JimboMcRackem/ESP32MCCAN/hardware/datasheets/NEEDED.md

# Datasheets still needed

Manufacturer sites block automated fetching from this project — downloading the PDF yourself and
dropping it in this directory is what has worked every time. PDFs, PNGs and text extractions here
are **gitignored**; only this file and `README.md` are tracked.

**Last reconciled against the folder contents: 2026-09-19**, after the owner supplied six files.
Full read-out of what each one settled is in `../docs/part-selection.md`, "Parts selected 2026-09-18".

---

## 2026-11-13 — aux stage

- ~~`sn74ahct2g126.pdf`~~ **Supplied 2026-11-13 as `74AHC_AHCT2G126.pdf`** (Nexperia Rev. 9). The pinout
  is verified, and U15 is now **74AHCT2G126DC, VSSOP-8 (SOT765-1)**. That is the only AHCT package;
  the TSSOP-8 "DP" is AHC.
- **`mmbt3904.pdf`** (Diotec, 2025-11-18): supplied. B on pin 1, E on pin 2, C on pin 3, which
  matches `Q_NPN_BEC` on Q2, Q3 and Q12.
- The pod switch is **chosen**: Infineon BTS7008-2EPA, already held here
  (`infineon_bts7008_2epa_datasheet_en.pdf`). The inrush measurement confirms it; it no longer
  gates it.

---

## 2026-10-18 — board phase A

**`tps4h160-q1.pdf` supplied by the owner** (TI SLVSCV8E, rev. June 2025) and graded in
`../docs/part-selection.md`, "Signal-output quad switch, 2026-10-18": **selected**. The ST
VNQ9080AJ alternate is **not needed**. Still needed, kit-gated: the `AUX_L`/`AUX_R` dual switch's
datasheet, once the pod's inrush is measured (spec §9.1).

---

## Blocking — nothing

**Closed 2026-09-19, both items, within hours of being opened.** The owner supplied the two
documents that settled them:

| Item | Settled by | Outcome |
|---|---|---|
| **Pass FET for route C** | `infineon_ipt008n06nm5lf_datasheet_en.pdf` | **Infineon IPT008N06NM5LF SELECTED** — OptiMOS 5 **LinearFET**, 60 V, **0.8 mΩ max**, SOA Diagram 3 gives **~50 A at 12 V / 10 ms** against a 7 A need. Route C now lands the board at **~60 °C**, 3 K *better* than today, with protection it does not currently have |
| **eFuse / controller** | `LTC4380.pdf` | **LTC4380 route chosen**, indicated orderable `LTC4380HMS-2#TRPBF`. Stock `Package_SO:MSOP-10_3x3mm_P0.5mm` verified correct — **no footprint download needed** |

> **Two judgement calls recorded against the FET, neither blocking** (detail in
> `../docs/part-selection.md`): it is **JEDEC Industrial-qualified, not AEC-Q101** — every other
> active part in this feed path is automotive-grade, so this is the owner's call and worth one
> check for an automotive OptiMOS LinearFET before ordering; and **PG-HSOF-8 (TOLL) is large**,
> ~9.9 × 10.5 mm each, ~180 mm² net added over the Q1 it replaces.

> **What is still needed is a decision, not a document:** whether the Experia's DC-DC fed 12 V rail
> can produce a load dump at all. If it cannot, the LTC4380's overvoltage clamp never operates and
> the SOA question is moot. **Confirm on the vehicle** (spec §6, and the Task 11 bring-up list).

---

## Previously blocking — now closed

**Every electrical part on the earlier blocking list is chosen.** L2, the last one, is the **Würth
WE-CMBNC 7448031002** (`wurth_we-cmbnc_7448031002.pdf`) — nanocrystalline, 2 mH, 10 A,
**6.3 mΩ max per winding**, **AEC-Q200 Grade 1**. With L1 = IHLP-4040DZ-01 at 1.5 µH the pair is
**18.40 mΩ against F4's 22 mΩ ceiling — a 16.4% margin**, 0.90 W, night total ~2.70 W.

> **Any substitution anywhere in the feed path must still be re-checked against the 22 mΩ sum.**
> The margin is comfortable now, not infinite: the two ferrite alternatives considered
> (Bourns PM3700-10-RC, Coilcraft CG3885-AL) are both 8.0 mΩ per winding and would take the pair
> back to 21.80 mΩ — a 0.9% margin.

> **Two items to confirm before ordering** (flagged, not assumed): whether the 6.3 mΩ is **per
> winding** — the conservative reading used above; Würth does not state it, Bourns and Coilcraft
> both do — or the total; and the **derating curve** at the 65 °C internal ambient, since the 10 A
> is specified at 20 °C.

## Blocking Task 9 — nothing; the antenna document is obtained

**CLOSED 2026-09-19.** The owner supplied the URL for *ESP32 Hardware Design Guidelines → PCB
Layout Design*. Both halves of the keep-out question are now answered:

| | |
|---|---|
| **Antenna area** (module datasheet, Fig. 12) | **18.0 mm wide × 6.19 mm deep** from the module end face |
| **Preferred placement** | *"place the module's on-board PCB antenna outside the base board, and the feed point … close to the edge"* — board-edge overhang, which spec §9.1 already assumes |
| **Explicitly forbidden** | *"the module should not be placed in the center of the board with clearance created by hollowing out on all four sides"* |
| **Housing clearance** | **"A clearance of at least 15 mm is recommended in all directions"** |

> **The 15 mm figure is an ENCLOSURE constraint and is the significant one** — a keep-clear volume
> ~48 mm across that must contain no PCB, metal, cable, gland or heat-spreader plate. It is
> recorded in `../docs/enclosure.md` §5a, where it now has to be reconciled with the gland field,
> the plate wall and the no-penetrations-in-the-antenna-wall rule **simultaneously**. *"Opposite
> wall"* used to settle the plate/antenna relationship; it now carries a minimum distance.

## Medium / low — for the BOM, not blocking

| Part | Why |
|---|---|
| **BAT54** (D8–D21, fourteen) | V_F at the clamp point and, more importantly, **reverse leakage at 3.3 V over temperature** — twelve sit across the RGB sense nodes where leakage biases the reading |
| **D1** 12 V Zener, **D3** 40 V Schottky, **C3** 220 µF, **F1** blade fuse holder | No part numbers; needed for the BOM and footprints. **C3 must be 63 V, not 50 V** — `smbj.pdf` gives the SMBJ24A an **8/20 µs clamp of 50.6 V**, which leaves a 50 V part no margin (see part-selection.md, "Correction 2") |
| **MMBT3904** (Q2, Q3) | Generic jellybean; any vendor's datasheet will do |
| **Automotive-grade IHLP** for L1 | `ihlp-4040dz-01.pdf` is the **Commercial** series — no AEC-Q200. Electrically it is the right part; for a vehicle, order the automotive variant of the same package |

---

## Recently closed — do not re-source these

| Ref | Part chosen | Closed by |
|---|---|---|
| **L1** input inductor | **Vishay IHLP-4040DZ-01**, **1.5 µH — required, not merely preferred** (5.80 mΩ max, Isat 27.5 A) | `ihlp-4040dz-01.pdf` |
| **L2** input CM choke | **Würth WE-CMBNC 7448031002** — nanocrystalline, 2 mH, 10 A, **6.3 mΩ max/winding**, **AEC-Q200 Grade 1**, through-hole. *Chosen 2026-09-19 over the Bourns PM3700-10-RC and Coilcraft CG3885-AL, both 8.0 mΩ ferrite and neither AEC-qualified* | `wurth_we-cmbnc_7448031002.pdf` |
| **L4 / L5** buck inductors | **Coilcraft XAL7070-223ME**, 22 µH, 39.69 mΩ max, Isat 6.3 A | `xal7070.pdf` |
| **L6** CAN choke | **TDK ACT45B-510-2P-TL003**, 51 µH, AEC-Q200 | `cmf_automotive_signal_act45b_en.pdf` |
| **D6 / D7** CAN ESD | **Nexperia PESD2CANFD24U-T** — one SOT23 part replaces both | `PESD2CANFD24U-T.pdf` |
| **D4** boost rectifier | **Vishay SS5PH102**, 100 V / 5 A | `ss5ph102.pdf` |
| **D2** input TVS | **SMBJ24A** — row 6.2 closed | `smbj.pdf` |
| **U7** PCA9685 | **PCA9685PW/Q900** (the AEC-Q100 variant), TSSOP28 | `PCA9685.pdf` |
| **U5** ESP32 module | **ESP32-WROOM-32E-N8** confirmed, EN reset RC verified, pin table cross-checked | `esp32-wroom-32e_esp32-wroom-32ue_datasheet_en.pdf` |

## 3D models worth sourcing (Task 8/9, enclosure fit)

KiCad ships footprints and STEP models for nearly everything now selected — including
`RF_Module:ESP32-WROOM-32E`, `Inductor_SMD:L_Vishay_IHLP-4040`, `Package_TO_SOT_SMD:SOT-23`,
`Package_SO:TSSOP-28_4.4x9.7mm_P0.65mm` and `Package_SO:Infineon_PG-TSDSO-14-22`. These are the ones
it cannot have:

- **ESP32-WROOM-32E module** — tall, and its antenna end dictates a keep-out plus board-edge
  placement. Espressif publish a STEP model
- **TE Superseal 1.0** 4-way (J3–J6) and 2-way (J8); **TE Superseal 1.5** 3-way (J1, J7) — panel
  penetration positions and mating clearance (§9.1). TE publish STEP per part number
- **Panel-mount ATO/ATC fuse holder** (F1) — one of the nine penetrations
- **Würth WE-CMBNC 7448031002 (L2)** — **DONE.** The vendor SamacSys footprint and STEP model are
  installed as `footprints/mccan.pretty/Wurth_WE-CMBNC_7448031002.kicad_mod` and
  `3dmodels/Wurth_WE-CMBNC_7448031002.stp`. Pads verified against the datasheet: four through-hole
  pads, **7.5 × 10.7 mm pattern, ⌀1.3 mm drills**. Body **23.0 × 17.0 mm** in the board plane
  (courtyard 25.0 × 19.65), and it stands **~23–24 mm above the PCB** — **double either ferrite
  alternative, and the constraint to check against the enclosure lid (§9)**
- **TDK ACT45B** — no KiCad footprint exists for it; `L_CommonModeChoke_Coilank_ACM4532` is the right
  size class but **its land pattern must be checked against the ACT45B drawing before use**
