JimboMcRackem/ESP32MCCAN/hardware/docs/enclosure.md

# Enclosure, Heat-Spreader Plate and Panel

**Status:** **the board outline is 200 × 140 mm, four M3 holes 5 mm in from the corners**
(originally 140 × 100 mm at Task 8, 2026-09-20; re-laid out to 200 × 140 mm by
`docs/superpowers/specs/2026-09-23-pcb-relayout-8layer-design.md`, Tasks 1-10 of its own plan).
**Revision, 2026-09-27 — this document is re-derived against the 200 × 140 mm board.** Every
figure below that depended on the old 140 × 100 mm outline (plate area, notch coordinates, gland
row, board-outline row) has been re-measured against `mccan.kicad_pcb` as it stands today; the
thermal physics (§1's K-rise table) did not change and are carried forward.
**Thermal design decided 2026-09-12, revised 2026-09-13 (flat plate), figures corrected 2026-09-20
and re-derived 2026-09-27 for the 200 × 140 mm board — see §1.**
Every item marked **[PROVISIONAL]** depends on something not yet decided; every item marked
**[TO CONFIRM]** needs a catalogue or datasheet lookup and is stated as selection criteria rather
than a guessed part number.

**Authority:** `../../docs/superpowers/specs/2026-09-11-esp32-mccan-pcb-hardware-design.md` §9.3, §9.4

> **No part numbers have been invented in this document.** Where a specific manufacturer part is
> needed, the selection criteria are given precisely enough to make the lookup mechanical. A
> fabricated part number in a document that drives an order is worse than an admitted gap.

---

## 1. Thermal design — flat plate, ≥ 150 cm²

**Decision: FLAT plate ≥ 150 cm², metal-to-metal plate-to-bracket, rubber isolators at the frame only.**

> **This supersedes the finned-plate decision of 2026-09-12.** Fins were required when the budget
> stood at 4.5 W and needed ≥ 300 cm² of effective area. The RGB load then turned out to be ~4×
> smaller than assumed (spec §2.2), and §4.2's rewrite replaced the 0.78 W P-FET with a back-to-back
> pair at 0.12 W plus a 0.27 W sense resistor. Fins remain a harmless option — they would buy a
> further ~10 K — but nothing depends on them, and the "fins must be vertical" installation
> constraint falls away with them.

### How much plate area is needed

At the steady-state worst case, natural convection (h ≈ 8 W/m²K) needs:

**Load figures, current as of 2026-09-20.** The operating modes never coincide (spec §2.4 — the owner
confirmed the loads never all occur together: daytime has the Denali lights off, night has the front
DRLs off). **Night governs at ~2.31 W**; daytime is ~1.4 W plus the inductors. The
full-white-plus-both-Denali combination occurs only during a flash-to-pass in daylight, for seconds,
and is absorbed by thermal mass.

| Effective area | Night 2.31 W (governs) | Internal at 40 °C | Daytime ~1.4 W | Verdict |
|---|---|---|---|---|
| 80 cm² (a 100 × 80 mm plate) | 36 K | 76 °C | 22 K | Fails the 65 °C target |
| 100 cm² | 29 K | 69 °C | 18 K | Still short |
| 140 cm² (the *original* 140 × 100 mm board's own footprint — this board is no longer that size) | 21 K | **61 °C** | 13 K | Meets the target |
| **150 cm² — requirement** | **19 K** | **59 °C** | 12 K | Comfortable |
| 200 cm² | 14 K | 54 °C | 9 K | Ample |
| **276.8 cm² — this board's plate, after notching (§ below)** | **10.4 K** | **50.4 °C** | **6.3 K** | Ample, with more margin than the 200 cm² row |

**This table is what moved the plate, and it now also explains why the plate stopped being a
design driver on the 200 × 140 mm board.** The old 80 cm² footprint was sized against a board
assumed to be 100 × 80 mm; at 2.31 W it no longer clears the target. The 140 cm² row records
what the *original* 140 × 100 mm board's own footprint delivered. **Revision, 2026-09-27 — the
board re-laid out to 200 × 140 mm**, and the plate (which follows the board, less the antenna
notch) grew with it to **276.8 cm²** — see "Which face the plate is" below, where the new
figure is derived from the current board, not carried over from the old one. The new row's
K-rise figures use the same Q = h·A·ΔT relation as the rest of this table (h ≈ 8 W/m²K,
Q = 0.0008 W/cm²K·A): the other five rows all give Q/h between 2800 and 2940 K·cm² (the small
spread is rounding in the source table, not a different model), consistent with Q/h = 2.31 W ÷
0.0008 W/cm²K = 2887.5 K·cm² at night. At 276.8 cm², ΔT = 2887.5 / 276.8 = **10.4 K**; the
daytime figure scales the same way from 1.4 W.

> **Correction, 2026-09-20.** Earlier revisions of this section quoted "daytime, ~4.5 W governs;
> night ~2.9 W", and a table headed "Night 1.9 W / Daytime 1.2 W" that contradicted the prose two
> lines above it. Both are wrong and both are replaced here. The plan's own amendment table records
> the same correction.

### The contradiction that is now resolved

Spec §9.3 previously made the bracket **part of the heatsink** *and* **rubber-isolated from the
frame**. Rubber is a thermal insulator, so the vibration isolation destroyed the conduction path the
thermal argument depended on. Both could not hold.

**Because the plate now carries the whole thermal load by itself, the frame is no longer needed as a
heatsink — so the vibration isolation survives intact.** The conflict dissolves rather than being
traded away.

### Specification

| | Value |
|---|---|
| Plate type | **Flat aluminium plate** forming the base (a finned extrusion is optional, not required) |
| Plate face | **The BASE** — the face under the board (decided 2026-09-20, below) |
| Footprint | **200 × 140 mm, antenna corner notched** (3.09 cm², re-measured 2026-09-27 for the 8-layer board) → **276.8 cm² of plate** |
| **Effective area — requirement** | **≥ 150 cm²** → ~59 °C at 40 °C ambient |
| Effective area — plate alone | **276.8 cm² → ~50.4 °C**, which clears the 65 °C target with the bracket no longer needed to close the gap |
| Base thickness | ≥ 3 mm, for flatness under fastener load and in-plane spreading |
| Fin orientation, *if* fins are fitted | **VERTICAL in the installed attitude** — see below |
| Material | Aluminium — **6082/6061, machined** (the notch makes an extrusion awkward) |

Expressed as an area requirement rather than a named profile, so any plate or extrusion meeting it
qualifies. **[TO CONFIRM]** the supplier and, if a profile is used after all, its published area.

### Which face the plate is — DECIDED 2026-09-20: the BASE, antenna corner notched

**Decision: the heat-spreader plate is the BASE** — the face the board lies over — **200 × 140 mm
(re-laid out 2026-09-23, was 140 × 100 mm), with the antenna corner notched out.** The decision
itself — base, notched — is unchanged; only the outline grew under it. See below for the
re-derived notch coordinates and area.

Three things forced it off the wall spec §9.1 named:

1. **The gap pad contacts B.Cu** (§3, and the board's own fab note). Assembly is single sided
   precisely so the bottom is bare copper. A gap pad only works between two roughly parallel
   faces, so the plate it presses against has to be **parallel to the board**.
2. **An edge wall cannot be 140 cm².** The board is 1.6 mm thick with a ~24 mm tallest part (L2);
   an edge wall big enough to host the plate would need a box roughly 100 mm deep, against a
   board that needs about 30 mm of height.
3. **Spec §9.1's wall is now free**, which relaxes the three-constraint problem in §2 item 5
   rather than tightening it.

**The notch — coordinates re-derived 2026-09-27 for the 200 × 140 mm board.** U5 moved 60 mm to
the right in the re-layout (it sits at board x = 207 now, was x = 147), and its keep-out moved
with it. Re-read directly from `mccan.kicad_pcb`'s U5 footprint `(keepout ...)` polygon this
session: the keep-out runs to **x = 234.75 mm in board coordinates, 14.75 mm beyond the board's
own 220 mm edge** — the same 14.75 mm overhang as before, because the shift is a pure
translation — and spans **y = 48 to 96 mm** (unchanged; the board did not grow in y at this
edge). The plate is cut back clear of that rectangle. Because the gap-pad patches stop at
**x = 98 mm** (§3), the notch still costs nothing thermally — there is no thermal via anywhere
near this edge.

**Area after notching: 276.8 cm².** The notch itself did not change size, only position: it is
still the 6.44 × 48 mm sliver where the keep-out overlaps the board, now at
**x 213.56 → 220.00, y 48.00 → 96.00 = 6.44 × 48 mm = 3.09 cm²** (re-measured; the old figure was
3.1 cm² to one decimal place, same rectangle). Re-derived from the board's own geometry rather
than carried over: the board is **200 × 140 mm** less four 3 mm corner arcs = **279.92 cm²**
(`Edge.Cuts`, this session), so the plate after notching is **279.92 − 3.09 = 276.8 cm²** — up
from the old board's ~136.9 cm², because the board grew far more than the notch did. At 2.31 W
that is **10.4 K over ambient, 50.4 °C at 40 °C** (§1's table, same Q/h relation) — well clear of
the 65 °C target on the plate alone, and the ≥ 150 cm² requirement no longer needs the bracket's
help to meet it (see "the plate stops being a design driver",
`docs/superpowers/specs/2026-09-23-pcb-relayout-8layer-design.md` §2).

**Clearance actually achieved.** The keep-out rectangle still contains Espressif's 15 mm halo on
every side (unchanged: 21.19 mm deep against a 6.19 mm antenna; 48 mm wide against an 18 mm
antenna — the halo geometry is a property of the *keep-out*, not of where it sits on the board),
so the antenna proper occupies **x 228.56–234.75, y 63–81** (shifted the same 60 mm as the
keep-out). Measured from that, on the new geometry:

| Nearest plate metal | Distance to the antenna |
|---|---|
| Notch inner corners (213.56, 48) and (213.56, 96) | **21.2 mm** |
| Plate edge at (220, 48) and (220, 96) | **17.3 mm** |

Both figures are numerically unchanged from the old board — a pure 60 mm translation does not
change a distance between two points that both moved by the same amount, and re-computing them
against the new coordinates (√(15² + 15²) = 21.2 mm; √(8.56² + 15²) = 17.3 mm) confirms it rather
than assuming it. Both clear the 15 mm minimum. **[TO CONFIRM]** the vertical case separately:
the plate sits ~1.6 mm below B.Cu, and nothing in the notch region may rise toward the antenna.

> **Why notching beats cutting the plate back.** This argument's shape survives the re-layout;
> its arithmetic is redone against the new board rather than reused. A straight cut-back clear
> of the keep-out's x = 213.56 mm line would leave a **213.56 − 20 = 193.56 mm** wide plate at
> full 140 mm depth ≈ **271.0 cm²** — which, unlike the old board's 85 cm² cut-back, would
> actually still clear the thermal target on this much larger board. **The margin for notching
> over cutting back has shrunk to almost nothing on this board** (276.8 cm² notched vs. ~271 cm²
> cut back — about 2 % apart), because the board is now so much larger than the plate area the
> thermal budget needs. The notch is kept here because it is already drawn and costs one
> machining operation either way, not because cutting back would fail — that is a change from
> the old board worth recording rather than silently carrying the old conclusion forward.

**Spec §9.1 has been amended** to record this — it previously said the plate was the wall
opposite the panel, which is not compatible with a gap pad on B.Cu.

### Fin orientation, if fins are fitted

Fins are optional (§1). If they are fitted they must run **vertically** once installed, so convection
forms a chimney between them. Mounted with fins horizontal they trap air and much of the added area
stops contributing. Record the intended mounting attitude alongside the bracket drawing.

### Mounting interfaces

- **Plate → bracket: metal-to-metal**, thermal compound at the interface. On the 200 × 140 mm
  board the plate alone (276.8 cm², §1) already clears both the 65 °C target (50.4 °C) and the
  ≥ 150 cm² requirement, so the bracket's spreading area is no longer needed to close a gap —
  it is now pure margin, the reverse of the old board's arrangement where the bracket supplied
  the last ~13 cm². **[TO CONFIRM]** the bracket's effective area once its drawing exists, for
  the margin it adds rather than out of necessity.
- **Bracket → frame: rubber isolators.** Vibration decoupling preserved; nothing thermal is lost.

### Gap pad — not the bottleneck

**~0.75 K** across the **1358 mm²** the board actually presents (§3, measured from Task 8's
placement) of 1.5 mm, 2 W/mK material, at the **~1.35 W** that reaches it through the thermal vias.
The constraint was always the plate's external convection, never the pad.

**Note what the pad does *not* carry.** Only parts with an exposed paddle full of thermal vias couple
into it: U9 (PROFET), U3 (boost controller), U1 and U2 (the buck regulators) and D4's tab. **L2, the
single largest heat source at 0.78 W, is a through-hole common-mode choke with no paddle** — its heat
leaves through its own pins into the board copper and then into the air, not through the gap pad. So
the pad sees ~1.35 W while the plate must still be sized for the full ~2.31 W.

---

## 2. Enclosure

**[TO CONFIRM]** Polycarbonate or ABS, IP67, **with a removable or machinable BASE** for the
heat-spreader plate (§1 — the plate is the base, not a wall).

Selection criteria, in priority order:

1. **Internal dimensions** must clear the board plus the internal cable service loop. The board
   is **200 × 140 mm** (re-laid out 2026-09-23, was 140 × 100 mm at Task 8), tallest part
   ~24 mm (L2, the Würth common-mode choke). **The 25–40 mm of connector mating depth is gone**
   (glands, §5 below), and is replaced by a smaller but real allowance: enough slack on seven
   soldered tails to lift the board clear with the glands slackened, since nothing unplugs any
   more.
2. **The BASE must take a 200 × 140 mm plate** (§1, decided 2026-09-20, re-derived for this
   outline 2026-09-27). Either the box has a separable base the plate replaces, or the base is
   machined to accept it with a gasket. A box whose base is moulded in one piece with the walls
   will not work.
3. **The plate is notched clear of the antenna**, so this is no longer a choice of walls. The
   notch removes **x 213.56–220.00, y 48.00–96.00** in board coordinates (3.09 cm², re-derived
   for the new U5 position — was x 153.56–160.00 before the antenna moved 60 mm right with the
   re-layout) and leaves ≥ 17.3 mm from the nearest plate metal to the antenna — see §1. What
   still needs checking against the chosen box is the **vertical** case and that no bracket boss
   or gland body intrudes into the same volume (item 5a).
4. **Plastic elsewhere, not metal** — the ESP32-WROOM-32E uses its onboard antenna, so the remaining
   walls must be RF-transparent (spec §9.3). This is why a diecast aluminium box was rejected.
5a. **ANTENNA CLEARANCE — 15 mm in all directions. ADDED 2026-09-19, and it may be the
   binding constraint on this enclosure.** Espressif's *ESP32 Hardware Design Guidelines → PCB
   Layout Design* states: **"A clearance of at least 15 mm is recommended in all directions"**
   around the PCB antenna inside the end-product housing.

   The module is 18 mm wide and its antenna area is **18.0 × 6.19 mm** (module datasheet Figure
   12). Fifteen millimetres clear on every side makes a keep-clear volume roughly **48 mm across
   and 15 mm deep** that must contain **no PCB, no metal, no cable, no gland body and no plate**.

   **Re-placed in the 2026-09-23 re-layout, and re-read from the board this session.** U5 is now
   at **(207, 72) rotated 270°** (was (147, 72) — moved 60 mm right with the outline), and the
   board-level keep-out — copper, board material and plate alike — is **x 213.56 to 234.75 mm,
   y 48.00 to 96.00 mm**, i.e. **21.19 × 48.0 mm, overhanging the board's 220 mm edge by
   14.75 mm** — the same overhang as before, because the whole arrangement translated rather than
   changed shape. Espressif **explicitly forbids** the alternative: *"the module should not be
   placed in the center of the board with clearance created by hollowing out on all four sides."*
   Board-edge overhang is their preferred arrangement and is what the board does.

   **Still to check against the chosen box:** that 15 mm of air, not plastic wall thickness, sits
   beyond that rectangle on the +x side and above/below it.

5. **Panel area** for **eight** penetrations (§4). **REVISED 2026-09-19**, count corrected
   2026-09-20 — two changes, both of which shrink this:
   - The seven "Superseal panel cutouts" **never existed**: Superseal is a wire-to-wire series
     with no panel-mount housing. Those seven become **cable glands** — 5 × M12 and 2 × M16.
   - The blade-fuse holder is gone; F1 is now a **board-mounted eFuse** (spec §4.1).

   **Revision, 2026-09-27 — the 200 mm wall fits all seven glands in one row, computed rather
   than assumed.** The panel used to be 140 mm wide, which forced two rows (below). On a
   200 mm wall: 5 × M12 at an assumed 18 mm hex-across-flats (90 mm) + 2 × M16 at an assumed
   22 mm hex-across-flats (44 mm) + 6 gaps at an assumed 4 mm spanner clearance (24 mm) =
   **158 mm**, against 200 mm available — **42 mm of margin**. See spec §9.1 for the same
   arithmetic and the redrawn single-row panel sketch. (The old 140 mm wall could not fit this
   in one row: **4 × M12 corners ≈ 96 mm** in one row plus **M12 CAN + M16 Denali + M16 PWR
   ≈ 78 mm** in a second, ≈ 143 mm total gland width against a 140 mm wall — which is the
   "will not fit" defect the 2026-09-23 re-layout spec's §1 cites as one reason for the extra
   60 mm of width.)

   **The glands must stack in two rows; the board's connectors do not.** The board puts all seven
   pigtails in a single row spanning ~123 mm of one edge, but a seven-gland row is
   **≈ 143 mm** (5 × M12 + 2 × M16 with spanner access) and will not fit a 140 mm wall. This is
   harmless — these are solder-wire pigtails, not panel connectors, so the tails simply fan out
   inside the box on their way to two rows of glands. It is recorded because the panel drawing and
   the board's connector edge are *not* a one-to-one map, and someone will otherwise assume they are.

   **The bigger gain is not area, it is that there is no mating envelope.** A panel connector
   needs 25–40 mm of clear space in front of its face for the plug and its cable bend; a gland
   needs only the cable's bend radius. That envelope was what made the old estimate the binding
   constraint on enclosure length.

   **This is now satisfiable, and §1's decision is what settled it.** The plate moved to the
   **base**, which takes it out of the wall set entirely: the panel and the antenna sit on
   opposite edge walls with the remaining faces free. Spec §9.1 has been amended accordingly —
   it previously put the plate on the wall opposite the panel, and that is what made the three
   constraints fight.
6. IP67 with a gasketed lid, and lid screws accessible after installation.

**Revision, 2026-09-27 — checked against the 200 × 140 mm size class, since the board grew past
what these were originally listed for.** Candidate families known to offer IP66/67 polycarbonate
boxes: **Hammond 1554/1555** (catalogue range extends to roughly 299 × 240 × 120 mm — still
reaches this size) and **Fibox MNX** (range extends to roughly 360 × 255 × 150 mm — also still
reaches it). **Bopla is not a safe pointer by brand alone**: its commonly catalogued Euromas
family tops out around 200 × 120 × 75 mm, which is wide enough but not deep enough for a 140 mm
board dimension plus a service loop; a different Bopla series would need identifying before it
belongs on this list. Polycase is unverified this session and carried forward without a check.
**Exact part number and internal dimensions still require a catalogue lookup** — not guessed
here, and not chosen by this revision either.

---

## 3. Heat-spreader plate and gap pad

**Plate** — flat plate per §1 (a finned extrusion is optional). Dimensions follow the board
outline (re-laid out 2026-09-23 to 200 × 140 mm; was 140 × 100 mm at Task 8):
- Material: aluminium — **6082/6061, machined** (the notch makes an extrusion awkward)
- Base thickness: **3 mm minimum** for flatness under fastener load and in-plane heat spreading
- **Footprint 200 × 140 mm, the BASE, with the antenna corner notched** (§1) — no metal inside
  x 213.56–234.75, y 48.00–96.00 in board coordinates (moved 60 mm right with U5; was
  x 153.56–174.75)
- Fins, if fitted, vertical in the installed attitude (§1)
- Replaces one face; sealed with a gasket in a machined groove, or a compressible gasket under a
  flange
- Fastener pattern: M3 or M4 at ≤40 mm pitch around the perimeter, so gasket compression is even.
  Torque to the gasket manufacturer's compression spec — **[TO CONFIRM]** with the gasket choice;
  do not over-torque a plastic boss.

**Gap pad** — this part of the thermal path *does* close:
- Silicone gap pad, thermal conductivity **≥2 W/mK**, thickness **1.5 mm** nominal, compressible to
  ~1.0 mm
- **Contact area: two patches, 1358 mm² total**, measured from Task 8's placement and drawn on the
  board's `Cmts.User` layer as dashed rectangles labelled with their sizes:

  | Patch | Board coordinates | Size | Area | What it covers |
  |---|---|---|---|---|
  | **TIM-A** | x 64–98, y 23–58 | 34 × 35 mm | 1190 mm² | D4's tab, U3's paddle, U1 and U2's paddles, L3 alongside |
  | **TIM-B** | x 69–83, y 82–94 | 14 × 12 mm | 168 mm² | U9, the PROFET |

  Two patches rather than one because the thermal group's bounding box is 73 × 67.5 mm ≈ 4900 mm² —
  mostly empty board. The patches are sized to where the thermal vias actually are.
- **The pad contacts B.Cu.** Assembly is single sided and the bottom is left bare on purpose. The
  stitching vias inside the patches are tented no differently from the rest of the bottom side.
- Computed drop across the pad: **~0.75 K** at ~1.35 W through 1358 mm² of 1.5 mm / 2 W/mK material.
  Negligible — the pad is not the bottleneck. The bottleneck is the plate's external convection (§1).

> **Corrected 2026-09-20.** This section previously read "the Task 8 thermal group (boost FETs, boost
> inductor, the single P-FET) — estimate ~1000 mm²". There are **no boost FETs** (U3 is an integrated
> switcher) and **no P-FET** (§4.2's rewrite replaced it with a back-to-back pair). The area is now
> measured, not estimated.

---

## 4. Panel layout

**Eight penetrations.** Corrected 2026-09-20 from "nine": the ninth was a blade fuse holder, and F1
is now a board-mounted eFuse (spec §4.1). Positions follow Task 8, which owns the connector-edge
ordering (controller Ruling 3 — this document matches the board, not the reverse).

| # | Penetration | Board ref | Notes |
|---|---|---|---|
| 1 | **PWR** (single feed) | J1 | Superseal 1.5 **3-way** — IGN_IN, FEED_P, GND_IN. Gland **M16** |
| 2 | Denali | J7 | Superseal 1.5 3-way. Gland **M16** |
| 3 | CAN | J8 | Superseal 1.0 2-way, sited away from the power connector. Gland **M12** |
| 4–7 | Corner connectors FL, FR, RL, RR | J3, J4, J5, J6 | Superseal 1.0 4-way; must be **distinguishable** — see `harness.md` §3. Glands **M12** |
| 8 | Pressure-equalisation vent | — | §5 |

**Board-edge order, left to right (Task 8):** **J1 (PWR), J7 (Denali), J8 (CAN), J3, J4, J5, J6**,
spanning ~123 mm. **J2 is not a penetration** — it is the 6-pin programming header, reached with the
lid off, and it sits at the right-hand end of the same edge.

> **Corrected 2026-09-20.** PWR was listed as "Superseal 1.5 **2-way**"; the netlist has three
> conductors on J1 (IGN_IN, FEED_P, GND_IN), so it is **3-way**. The blade fuse holder row is
> deleted. **There is no panel-mounted fuse** — the accepted-risk note in `harness.md` §6 about
> owner-chosen panel fusing no longer applies to this build and should be re-read in that light.

**No second feed connector.** The second feed exists only as unpopulated board footprints, so
restoring it later needs one drilled hole rather than a PCB respin.

**Layout rules:**
- Keep the CAN gland away from the power gland
- Group the four corner glands, ordered to match the board's connector edge where the two rows allow
  (see §2 item 5 — seven glands do not fit one 140 mm row)
- Maintain the gasket land and minimum wall between adjacent cutouts per the gland datasheets
  **[TO CONFIRM]**
- **No penetration in the wall facing the ESP32 antenna**, and no metal there

---

## 5. Pressure-equalisation vent

**[TO CONFIRM]** A breathable membrane vent (Gore-type or equivalent), panel-mounted.

**Why it is not optional:** a sealed enclosure that heats and cools pumps air past its seals, and
eventually draws moisture *through* them. The vent equalises pressure while blocking liquid water,
and is what makes an IP67 rating hold over years rather than months.

Mount on a **sheltered face, pointing downward or sideways** — never upward where standing water
collects on the membrane.

---

## 6. Mounting

- Plate to bracket: **solid metal-to-metal** contact with thermal compound or a thermal pad, so the
  bracket contributes to heat spreading
- Bracket to frame: **rubber isolators** for vibration — see §1, this is the interface where the
  thermal/vibration conflict lives
- Bracket material: steel or aluminium, stiff enough not to resonate; no large unsupported spans
- Orientation: glands and vent **downward or sideways**, never upward
- Board to enclosure: **four M3 holes, 5 mm in from each corner** of the **200 × 140 mm** outline
  — re-verified this session against `mccan.kicad_pcb`'s H1–H4 footprints at (25, 25), (215, 25),
  (25, 155), (215, 155), which is 5 mm in from the board's own 20…220 / 20…160 edges; the
  5 mm inset carried over from Task 8 unchanged, only the outline it is measured from grew

---

## 7. Conformal coating

**[TO CONFIRM]** Acrylic or silicone conformal coating. Acrylic is easier to rework; silicone
tolerates temperature better and is kinder over thermal cycles.

**Mask before coating — every one of these:**

| Must be masked | Why |
|---|---|
| All connector solder pads and tails | Coating is an insulator; a coated joint is an open circuit |
| Programming header J2 (`+3V3_ALW`, `GND`, `UART_TX`, `UART_RX`, `DTR`, `RTS`) | Needed for flashing |
| All test points | Needed for bring-up (`bring-up.md`) |
| **ESP32 antenna keep-out** (x 213.56–234.75, y 48.00–96.00 — moved 60 mm right with U5 in the 2026-09-23 re-layout; was x 153.56–174.75) | Coating over the antenna detunes it — the same reason potting was rejected |
| Pressure-equalisation vent | Coating would seal the membrane and defeat it |
| **Gap-pad contact patches on B.Cu** — TIM-A and TIM-B (§3) | Coating adds thermal resistance exactly where it hurts |

Note the last two: both are cases where coating would silently destroy a feature designed in
elsewhere. Both are drawn on the board's `Cmts.User` layer so the coating house can see them.

> **Corrected 2026-09-21.** This row listed J2 as `(3V3, GND, TXD0, RXD0, EN, IO0)`. Pins 5 and 6
> are **`DTR` and `RTS`**, not `EN` and `IO0` — they reach `EN_MCU` and `BOOT_N` only *through* the
> cross-coupled auto-reset pair Q2/Q3 (`schematic-review.md` §7.4; netlist at
> `part-selection.md` §J2). The distinction matters when building an adapter cable: wiring a
> USB-UART's DTR and RTS straight to `EN` and `IO0` is the naive arrangement the transistor pair
> exists to replace, and it resets the board on every serial connect. Feed the header raw DTR and
> RTS and let Q2/Q3 do the sequencing — that is what makes flashing work with **no manual BOOT
> hold** (`bring-up.md` §106).

---

## 8. Open items carried

| Item | Needed to close |
|---|---|
| ~~Thermal design~~ **RESOLVED 2026-09-12/13** | Flat plate, metal-to-metal plate-to-bracket, rubber at the frame. Remaining: pick a plate or profile meeting **≥ 150 cm²** |
| ~~Which face the plate is~~ **RESOLVED 2026-09-20, figures superseded 2026-09-27** | The **base** — still true. **200 × 140 mm** (was 140 × 100 mm), antenna corner notched (3.09 cm², moved 60 mm right with U5) → **276.8 cm²** (was ~137 cm²). Spec §9.1 amended. §1 |
| ~~2 oz outer copper vs the land patterns~~ **RESOLVED 2026-09-20, wrong twice by 2026-09-27** | This row read "1 oz outer / 2 oz inner" and named `In2.Cu` as the feed. Both are wrong on this board: it is **1 oz on all eight layers** (not 2 oz inner — see the layer-count row below), and the feed polygon is `In4.Cu` (not `In2.Cu`, which is a signal/CAN layer). Spec §10 amended; see `fabrication.md` §2 |
| ~~Layer count~~ **RESOLVED 2026-09-22, layer count superseded 2026-09-27** | **8 layers, 1 oz on all eight** (was 6 layers, 1 oz on all six — the board grew two more inner layers during the 200×140 mm re-layout; see `fabrication.md` §2). The reasoning that decided the copper weight is unchanged and still holds: odd stacks are laminated from an even one and warp, so an even layer count costs the same; 2 oz inner is still not used, because PCBWay etch inner layers to 6/8 mil at 2 oz and 8 mil is 0.203 mm, above this board's 0.20 mm clearance. The feed plane also moved layers — it is `In4.Cu` now, not `In3.Cu` — and `check_plane_width.py` measures its current worst cut at 104.90 mm against 11.44 mm required (was 71 mm on the retired six-layer `In3.Cu`; see `fabrication.md` §2 for both figures, re-measured this session) |
| Bracket spreading area | **Revised 2026-09-27**: the notched plate is now **276.8 cm²** (~50.4 °C, target met with room to spare) — it already clears the ≥ 150 cm² requirement on its own. Quantifying the bracket is no longer needed to *reach* the requirement, only to add margin |
| Antenna-to-plate **vertical** clearance | In-plane is 17.3 mm (§1). The plate sits ~1.6 mm below B.Cu; confirm nothing rises into the notch |
| ~~Board outline~~ **RESOLVED 2026-09-20, re-laid out 2026-09-23** | **200 × 140 mm**, M3 at 5 mm from each corner — inset unchanged, re-verified this session against H1–H4 at (25,25)/(215,25)/(25,155)/(215,155) (was 140 × 100 mm at Task 8) |
| ~~Thermal group area~~ **RESOLVED 2026-09-20, needs re-measurement** | 1358 mm² in two patches — §3. The 2026-09-23 re-layout spec §4.3 relaxed the thermal group's placement veto now that the plate has margin; the patch geometry itself was not re-measured against the new placement this session and should not be assumed unchanged |
| Enclosure part number and internal dimensions | Catalogue lookup against **200 × 140 mm** + ~24 mm tallest part + the antenna's 15 mm halo. §2's family check (2026-09-27) confirms Hammond 1554/1555 and Fibox MNX still reach this size; Bopla needs a specific series identified first |
| Plate part number, or drawing if machined | Catalogue lookup against the **≥ 150 cm²** requirement, once §1's face decision closes |
| Gasket and fastener torque | Follows the gasket part choice |
| Vent part number | Catalogue lookup |
| Gland cutout diameters and minimum spacing | Gland datasheets (5 × M12, 2 × M16) |
| ~~`harness.md` §6~~ **RESOLVED 2026-09-22** | Rewritten for the eFuse. §4 no longer claims a 10 A panel fuse, and §6's accepted risk now says what it always meant: the protection is at the wrong end of the cable, and that was as true of the panel fuse as it is of F1. The one thing it could not answer is what the **vehicle** fuses the peripheral outlet with, which is now a **[TO CONFIRM]** in harness.md rather than an assumption. |
