JimboMcRackem/ESP32MCCAN/docs/superpowers/plans/2026-10-18-board-schematic-phase-a.md

# Board Schematic, Phase A (everything the Oxford kit does not gate) Implementation Plan

> **For agentic workers:** REQUIRED SUB-SKILL: Use superpowers:subagent-driven-development (recommended) or superpowers:executing-plans to implement this plan task-by-task. Steps use checkbox (`- [ ]`) syntax for tracking.

**Goal:** Regenerate the four schematic sheets for the E-marked-module board — feed A protection, a new feed B, the rails, the MCU/CAN sheet with its final pin map, and ten signal outputs on three quad smart high-side switches — verified by a netlist assertion script, leaving only the pod (aux) switch stage for when the Oxford kit arrives.

**Architecture:** The sheets stay text-generated by `hardware/scripts/gen_*.py` (never hand-edited). A new `check_netlist.py` encodes this plan's electrical intent as named check groups and is written first, failing against the plan3 netlist; each sheet task turns its group green. The chosen quad switch's pin numbers and application values live in one module, `quadpins.py`, which `symlib.py`, `gen_outputs.py` and `check_netlist.py` all import. **Layout is out of scope** — the pod switch's footprint is kit-gated, so `gen_pcb.py` is not run in this plan and `hardware/mccan.kicad_pcb` stays the abandoned plan3 board.

**Tech Stack:** Python 3 generators emitting KiCad 10 s-expressions; `kicad-cli` 10.0 (ERC, netlist export); PlatformIO / Arduino-ESP32 for the one firmware task.

**Spec:** `docs/superpowers/specs/2026-10-17-emarked-module-redesign-design.md` (the `main` copy is current; Task 0 brings it to the PCB branch)

## Global Constraints

- Work on branch **`plan4-emarked-modules`** in a worktree at `D:/Projects/ESP32MCCAN-pcb` (spec §8: board work inherits `hardware/scripts/`). Only Task 10 touches `main`.
- Sheets are generated, **never hand-edited**. Every generator must stay idempotent: running it twice leaves the file byte-identical.
- Run order: `symlib.py` first, then `gen_power_input.py`, `gen_rails.py`, `gen_mcu_can.py`, `gen_outputs.py`, `gen_root.py`, all from `hardware/scripts/`.
- `kicad-cli` is **not on PATH**: `"/c/Program Files/KiCad/10.0/bin/kicad-cli.exe"`. ERC and netlist export can exceed 2 min — use a 180 s timeout.
- **Do not run `gen_pcb.py`**, any `layout_*`/`route_*` script, or DRC in this plan.
- **Never `git add -A`.** Datasheet PDFs and their `pdftotext` extractions are gitignored third-party content; extract to the scratchpad, stage files by name.
- Datasheets are read from `hardware/datasheets/` with `/mingw64/bin/pdftotext -layout`. Manufacturer sites block automated fetching: a missing datasheet is a request to the user, not a web fetch.
- Every part on `VBAT`, `VBAT_PROT` or `VBAT_B` must survive the **SMBJ24A's 50.6 V 8/20 µs clamp** (fpmap.py docstring) — capacitors there are **≥ 63 V**, 0805 or larger.
- Every enable net carries an external pull-down (hardware-review-lessons: missed three times on plan3).
- An alternative-build part is a **DNP flag**, never a sentence in sheet text.
- Feed A's protected net keeps its existing name **`VBAT`**; the new feed is **`VBAT_B`**. They are never joined by any net or part (spec §4.1.1).
- **No lamp output on a strapping pin** (GPIO 0, 2, 5, 12, 15), and none on GPIO 14, which toggles during boot.

## Review Focus

1. **Lamp lit at reset.** A GPIO floats or is pulled high while the ESP32 boots, and a switch input sees it → every switch `IN` net must have a resistor to `GND` and no path to a supply. Test: `boot_safety` group (Task 2).
2. **Feed B fitted backwards / the TVS on the wrong side.** A reverse-connected feed B must be blocked by the P-FET, and the unidirectional TVS must sit on the protected side or it shorts the reversed supply → FET drain on the connector, source on `VBAT_B`, TVS cathode on `VBAT_B`. Test: `feed_b` group (Task 2).
3. **The two feeds bridged.** Any part with one pin on `VBAT` and another on `VBAT_B` re-merges both pods through one 5 A fuse → no such part, no shared net. Test: `feed_b` group.
4. **A fault drives a sense pin above 3.3 V into the ADC.** Smart-switch sense outputs go to a fault level on short or over-temperature → every `SNS_x` net reaches the MCU through a series resistor and a Schottky clamp to `+3V3_ALW`. Test: `outputs` group.
5. **CAN never wakes or never receives.** The RX pin must be RTC-capable for EXT1 wake, and the transceiver's `+5V` must be under an enable that defaults off but that the firmware drives on → `CAN_RXD` on GPIO35, `EN_5V` pulled down, firmware drives `EN_5V` high and `CAN_STB` low. Test: `mcu` group (Task 2) and Task 10's build.

---

## Decisions this plan applies (made 2026-10-18, before Task 1)

These are fixed inputs. A task that finds one of them impossible stops and reports rather than choosing another.

**D1. Three quad switches, not two.** Spec §4.4 says "two quad-channel parts for the ten signal outputs", which is eight channels. User decision: **three quads, 12 channels, 2 spare.** Channel allocation, chosen so that one dead chip never takes out both sides' indicators, and brake survives a side chip failing:

| Chip | Ref | Ch1 | Ch2 | Ch3 | Ch4 | Sense net |
|---|---|---|---|---|---|---|
| A (left) | U11 | `FL_DRL` | `FL_IND` | `RL_DRL` | `RL_IND` | `SNS_A` |
| B (right) | U12 | `FR_DRL` | `FR_IND` | `RR_DRL` | `RR_IND` | `SNS_B` |
| C (brake) | U13 | `RL_BRK` | `RR_BRK` | spare, reserved for `AUX_MODE` | spare | `SNS_C` |

**D2. Final ESP32 pin map.** Module pin numbers are ESP32-WROOM-32E pad numbers, as in the plan3 netlist.

| Net | GPIO | Pad | Why this pin |
|---|---|---|---|
| `OUT_FL_DRL` | 25 | 10 | non-strapping output |
| `OUT_FL_IND` | 26 | 11 | " |
| `OUT_FR_DRL` | 32 | 8 | " |
| `OUT_FR_IND` | 33 | 9 | " |
| `OUT_RL_DRL` | 27 | 12 | " |
| `OUT_RL_IND` | 16 | 27 | " (free on WROOM: no PSRAM) |
| `OUT_RL_BRK` | 17 | 28 | " |
| `OUT_RR_DRL` | 18 | 30 | " |
| `OUT_RR_IND` | 19 | 31 | " |
| `OUT_RR_BRK` | 21 | 33 | " (was I2C SDA) |
| `OUT_AUX_L` | 22 | 36 | " (was I2C SCL) — terminated in a pull-down until the kit plan |
| `OUT_AUX_R` | 23 | 37 | " — as above |
| `EN_5V` | 4 | 26 | enable, RTC-capable so it can be held in sleep |
| `LED_STAT` | 13 | 16 | unchanged from plan3 |
| `CAN_STB` | 14 | 13 | unchanged; a boot-time toggle on standby is harmless |
| `CAN_RXD` | 35 | 7 | input-only, **RTC GPIO → EXT1 wake** (firmware currently says 16, which cannot wake) |
| `DIAG_EN` | 2 | 24 | strapping, must be low for download — the pull-down serves both |
| `DIAG_SEL0` | 5 | 29 | strapping; a select line's boot-time level is harmless while `DIAG_EN` is low |
| `DIAG_SEL1` | 15 | 23 | strapping; as above |
| `SNS_A` | 34 | 6 | ADC1 (ADC2 is unusable with Wi-Fi up) |
| `SNS_B` | 36 / SENSOR_VP | 4 | ADC1; freed by deleting `IGN_SENSE` |
| `SNS_C` | 39 / SENSOR_VN | 5 | ADC1 |
| `IO12_STRAP` | 12 | 14 | keeps plan3's pull-down; also the firmware's TWAI TX pin (D4) |
| `BOOT_N`, `EN_MCU`, `UART_RX`, `UART_TX` | 0, EN, 3, 1 | 25, 3, 34, 35 | unchanged |

`DIAG_EN`, `DIAG_SEL0` and `DIAG_SEL1` are **shared by all three chips**; each chip has its own sense line. `DIAG_SEL0`/`DIAG_SEL1` get **no external pull**: their level is irrelevant while `DIAG_EN` is low, and a pull-down on GPIO15 would mute the boot ROM log.

**D3. Ignition sense is deleted.** Spec §6.2: CAN is off when the bike is off, so bus activity is the wake source. `IGN_IN` (J1 cavity 1), `IGN_SENSE` and their divider/clamp parts go; J1 becomes 2-pin.

**D4. The CAN TX GPIO link is deleted; listen-only stays hardware-enforced.** Plan3 joined GPIO17 to the TJA1042 `TXD` through DNP 0R `R23`. GPIO17 is now a lamp output, and the TWAI peripheral idles its TX pin **high** — so if the firmware's TX pin were a lamp pin, that lamp would light. `R23` is removed, `TXD` stays pulled up by `R24`, and the firmware points TWAI TX at **GPIO12**, which has no connection but its strap pull-down (it is sampled only at reset, long before TWAI starts).

**D5. Harness tails.** KiCad's `Connector_Wire` relief footprints stop at 1x06, so the rear 7-conductor run is two tails on one 7-core cable through one gland: one return, as spec §3.1 requires.

| Ref | Footprint | Pin 1..n |
|---|---|---|
| J1 (feed A) | `SolderWire-1.5sqmm_1x02_P6mm_D1.7mm_OD3mm_Relief` | `FEED_P`, `GND_IN` |
| J9 (feed B) | `SolderWire-1.5sqmm_1x02_P6mm_D1.7mm_OD3mm_Relief` | `FEED_B_P`, `GND_B` |
| J3 (front) | `SolderWire-0.5sqmm_1x05_P4.6mm_D0.9mm_OD2.1mm_Relief` | `FL_DRL`, `FL_IND`, `FR_DRL`, `FR_IND`, `GND` |
| J4 (rear, part 1) | `SolderWire-0.5sqmm_1x04_P4.6mm_D0.9mm_OD2.1mm_Relief` | `RL_DRL`, `RL_IND`, `RL_BRK`, `GND` |
| J5 (rear, part 2) | `SolderWire-0.5sqmm_1x03_P4.6mm_D0.9mm_OD2.1mm_Relief` | `RR_DRL`, `RR_IND`, `RR_BRK` |
| J8 (CAN) | unchanged | unchanged |

J6 and J7 (plan3's RR corner and Denali) are deleted. The pod tail is kit-gated and is not added here.

**D6. Feed B circuit** (spec §4.1.1: reverse polarity + 24 V TVS, no buck, no filter, no LTC4380). Reuses parts whose datasheets are already on disk.

| Ref | Part | Connection |
|---|---|---|
| Q13 | Vishay SQJ461EP, P-ch −60 V, 16 mΩ, VGS ±20 V (`sqj461ep.pdf`) | D → `FEED_B_P`, S → `VBAT_B`, G → `GATE_B` |
| R108 | 100 kΩ 0603 | `GATE_B` → `GND_B` |
| D24 | MMSZ5245B, 15 V zener, SOD-123 | cathode `VBAT_B`, anode `GATE_B` (holds VGS inside ±20 V at the 50.6 V clamp) |
| D25 | SMBJ24A, SMB | cathode `VBAT_B`, anode `GND_B` — on the **protected** side |
| C66 | 100 nF 100 V 0805 | `VBAT_B` → `GND_B` |
| NT1 | `Device:NetTie_2`, `NetTie:NetTie-2_SMD_Pad0.5mm` | `GND_B` ↔ `GND`: the star point, a deliberate object for the layout phase |

At 2.48 A worst case (spec §4.1.1, 10.5 V) Q13 dissipates 2.48² × 16 mΩ ≈ 0.10 W. `VBAT_B` ends at a root-level label for the kit plan's `AUX_R` switch.

**D7. LTC4380 current limit — recorded, not changed.** `R100` = 5.6 mΩ sets 50 mV / 5.6 mΩ ≈ **9 A** (`LTC4380.pdf`, VSNS 45–55 mV), behind feed A's **4 A** fuse, so it can never act. Re-sizing it needs pod L's start-up current on feed A, which is spec §9.1 item 2: **kit-gated**. `R100` is left as is, and Task 9 records the gap in spec §9.1.

---

### Task 0: Worktree and baseline

**Files:**
- Create: worktree `D:/Projects/ESP32MCCAN-pcb` on `plan4-emarked-modules`
- Modify (from `main`): `docs/superpowers/specs/2026-10-17-emarked-module-redesign-design.md`, this plan file

- [ ] **Step 1: Create the worktree and bring the current spec and this plan across**

```bash
cd /d/Projects/ESP32MCCAN && git worktree add ../ESP32MCCAN-pcb plan4-emarked-modules
cd ../ESP32MCCAN-pcb && git checkout main -- docs/superpowers/specs/2026-10-17-emarked-module-redesign-design.md docs/superpowers/plans/2026-10-18-board-schematic-phase-a.md
git commit -m "docs: bring the current redesign spec and the phase-A board plan onto the PCB branch"
```

- [ ] **Step 2: Confirm every generator is idempotent on the untouched tree**

Run each generator in the Global Constraints order, then `git status --short hardware/`.
Expected: no modified files. If any sheet changes, stop — the baseline is not reproducible.

- [ ] **Step 3: Capture the plan3 netlist as the baseline**

```bash
"/c/Program Files/KiCad/10.0/bin/kicad-cli.exe" sch export netlist --format kicadsexpr -o hardware/output/netlist.net hardware/mccan.kicad_sch
cp hardware/output/netlist.net "$SCRATCH/netlist.plan3.net"
```
Expected: export succeeds. (`$SCRATCH` is the session scratchpad.)

---

### Task 1: Quad switch selection and `quadpins.py`

**Files:**
- Create: `hardware/scripts/quadpins.py`
- Modify: `hardware/docs/part-selection.md` (new section "Signal-output quad switch, 2026-10-18")
- Modify: `hardware/datasheets/NEEDED.md`

**Interfaces:**
- Produces, in `quadpins.py`:
  - `PART: str` (orderable part number), `LIB_ID: str` (`"mccan_parts:<name>"`), `FOOTPRINT: str`
  - `PINS: dict[str, list[str]]` with keys `"IN1".."IN4"`, `"OUT1".."OUT4"` (each a list: multi-pad outputs), `"VS"`, `"GND"`, `"DIAG_EN"`, `"SEL0"`, `"SEL1"`, `"SNS"`, and `"OTHER"` (every remaining pad, with its required strap as a comment)
  - `R_IN_SERIES: str`, `R_IN_PULLDOWN: str`, `R_SNS: str`, `R_CL: str`, `R_THER: str`, `C_OUT: str | None`, `C_VS: str` — value strings as they will appear on the sheet
  - `PINS` also carries `"CL"`, `"THER"`, `"FAULT"` and `"EP"` when the part has them

- [ ] **Step 1: Get the datasheets**

Ask the user to download into `hardware/datasheets/`: **TI TPS4H160-Q1** (first candidate) and **ST VNQ9080AJ** (alternate). Add both to `NEEDED.md` until they land. Do not fetch them yourself.

- [ ] **Step 2: Grade each candidate against the criteria, from the pin table and the electrical tables, not the feature list**

| # | Criterion | Pass if |
|---|---|---|
| 1 | Channels | 4 |
| 2 | Survives the feed | VS rating covers `VBAT`, which the LTC4380-2's **31.5 V gate clamp** (SEL grounded) holds near **27 V**; record the abs. max against the TVS's 50.6 V full-I<sub>PP</sub> clamp as a margin note, not a gate (corrected 2026-10-18: the 50.6 V rule is for passives, and no 12 V smart switch meets it) |
| 3 | Off with input open | internal input pull-down **and** output off with IN floating (spec §3.2) |
| 4 | 3.3 V logic | VIH(max) ≤ 2.0 V |
| 5 | Protection | per-channel current limit and thermal shutdown, fault reported on the sense output |
| 6 | Indicator inrush | limit does not trip on a 0.08 A load with a reservoir capacitor (spec §2.1.1 item 3) |
| 7 | Diagnostics shape | one enable + two select lines + one analog sense per chip (D2's shared-bus layout) |
| 8 | Off-state supply current | record the figure with all inputs low; prefer ≤ 10 µA per chip (three sit on `VBAT` always) |
| 9 | Qualification | AEC-Q100 |
| 10 | Footprint | a stock KiCad footprint whose pad count matches the pin table |
| tiebreak | Open-load | resolves 80 mA; note whether 20 mA (rear `*_DRL`) is resolvable (spec §6 item 4) |

Write the graded table into `part-selection.md` with the datasheet page for every figure. If neither candidate passes 1–10, stop and report.

- [ ] **Step 3: Write `quadpins.py` from the winner's pin table**

Every pad number is copied from the datasheet's pin-function table, with the table's name and page in a comment. `R_IN_SERIES`/`R_IN_PULLDOWN` default to `"4.7k"`/`"47k"` (TI §7.3.7.5 recommends 4.7 kΩ for a 3.3 V MCU); check `3.3 × (Rpd ∥ Rint) / ((Rpd ∥ Rint) + Rs) ≥ VIH + 0.5 V` and record the arithmetic. A sense output's **fault level is a fixed voltage**, not set by `R_SNS`, and the Schottky clamp handles it; `R_SNS` instead puts the **linear full-scale at the current limit ≤ 3.0 V** (ESP32 ADC at 11 dB), so a reading above that means fault. Also record `R_CL` (current-limit resistor), `THER` handling and any pin left unconnected. `C_OUT` is the application circuit's output capacitor or `None`.

- [ ] **Step 4: Verify the module imports and the pin set is complete**

Run: `cd hardware/scripts && python -I -c "import quadpins as q; pads=[p for v in q.PINS.values() for p in v]; assert len(pads)==len(set(pads)); print(q.PART, len(pads))"`
Expected: prints the part and a pad count equal to the package's pad count (including any exposed pad).

- [ ] **Step 5: Commit**

```bash
git add hardware/scripts/quadpins.py hardware/docs/part-selection.md hardware/datasheets/NEEDED.md
git commit -m "hw(parts): select the signal-output quad switch and record its pin table"
```

---

### Task 2: `check_netlist.py` — the plan's tests, written first

**Files:**
- Create: `hardware/scripts/check_netlist.py`

**Interfaces:**
- Consumes: `quadpins.PINS`, D1–D6 above
- Produces:
  - `load(path: str) -> Netlist`, where `Netlist.nets: dict[str, set[str]]` maps a net name with its sheet prefix stripped (`/mcu_can/CAN_RXD` → `CAN_RXD`) to `{"U5.7", ...}`, and `Netlist.parts: dict[str, Part]`, `Part(value: str, footprint: str, dnp: bool)`
  - `GROUPS: dict[str, list[Callable[[Netlist], list[str]]]]` with keys `deleted`, `feed_b`, `rails`, `mcu`, `outputs`, `harness`, `boot_safety` — each check returns a list of failure strings
  - CLI: `python check_netlist.py [--only GROUP ...] [NETLIST]`, default `../output/netlist.net`; prints `PASS <group>` or each failure; exit 0 only when every selected check passes

- [ ] **Step 1: Write the checks**

Values come from D1–D6 and `quadpins`; each group is a list of small functions. Required assertions:

- `deleted`: no part whose value is `LM51571-Q1`, `DML3017LDC`, `PCA9685PW/Q900`, `ADG706`, `NX5020UNBKS`, `BTS7008-2EPA` or `1206L050/24`; no net named `+24V`, `+3V3_SW`, `EN_BOOST`, `EN_3V3SW`, `EN_DIAG`, `IGN_IN`, `IGN_SENSE`, `I2C_SDA`, `I2C_SCL`, `MUX_S0`..`MUX_S3`, `RGB_ISNS`, `ISNS_DEN`, `PWM_DEN_A`, `PWM_DEN_B`, `DEN_DSEL`; no ref `R23`, `J6`, `J7`.
- `feed_b`: D6's table, pin by pin (Q13 pin roles taken from the symbol's G/S/D map); `VBAT` and `VBAT_B` are different nets; **no part has one pin on `VBAT` and another on `VBAT_B`**; `GND_B` contains only J9.2, R108, D25, C66 and NT1.
- `rails`: `EN_5V` contains U5.26, the 5 V buck's `EN/UVLO` pin and a resistor whose other pin is on `GND`; `+5V` still reaches U6 `VCC`.
- `mcu`: every row of D2 — `U5.<pad>` is on the named net; `CAN_RXD` is on U5.7; `IO12_STRAP` has a resistor to `GND`; `U6.1` (`TXD`) is on a net with no U5 pin and a resistor to `+3V3_ALW` (R24 — the hardware listen-only guarantee); `CAN_STB` has a resistor to `+3V3_ALW` (R25, standby by default).
- `outputs`: for each of the 12 `(chip, channel)` cells of D1 that carries a function: `OUT_<fn>` contains U5's pad, the series resistor, and nothing else on the MCU side; the chip's `IN<ch>` pin is on a net with the series resistor's other pin and an `R_IN_PULLDOWN` resistor to `GND`; the chip's `OUT<ch>` pads are all on net `<fn>`. Spare channels: `IN` pulled down, `OUT` unconnected. `OUT_AUX_L`/`OUT_AUX_R`: U5's pad plus a pull-down to `GND`, nothing else. Each chip's `SNS` pin sits on a net with `R_SNS` to `GND` and a series resistor whose other end is on `SNS_A|B|C`, and that net also has a Schottky whose cathode is on `+3V3_ALW`. Each chip's `CL` pin has `R_CL` to `GND`; its `THER` pin has `R_THER` to `+5V`; its `FAULT` pin is unconnected; its `EP` is on `GND`. `DIAG_EN`, `DIAG_SEL0`, `DIAG_SEL1` each reach all three chips; `DIAG_EN` has a pull-down; `DIAG_SEL0`/`DIAG_SEL1` have none. Each chip's `VS` pins are on `VBAT`, `GND` pins on `GND`.
- `harness`: D5's table, pin by pin.
- `boot_safety`: every net containing any chip's `IN*` pin has at least one resistor to `GND` and no part pin on `+3V3_ALW`, `+5V`, `VBAT` or `VBAT_B`; no `OUT_*` net contains U5 pads 13, 14, 23, 24, 25 or 29 (GPIO 14, 12, 15, 2, 0, 5).

- [ ] **Step 2: Run it against the plan3 baseline and confirm it fails for the right reasons**

Run: `cd hardware/scripts && python -I check_netlist.py "$SCRATCH/netlist.plan3.net"`
Expected: exit 1. `deleted` lists the plan3 parts and nets; `feed_b` reports no `VBAT_B`; `mcu` reports `CAN_RXD` correct (plan3 already used pad 7) but the output rows missing. A check that **passes** on plan3 when the table above says it should fail is a broken check — fix it before moving on.

- [ ] **Step 3: Commit**

```bash
git add hardware/scripts/check_netlist.py
git commit -m "hw(gates): check_netlist.py encodes the phase-A board's electrical intent"
```

---

### Task 3: Symbols and footprints

**Files:**
- Modify: `hardware/scripts/symlib.py`, `hardware/symbols/mccan_parts.kicad_sym` (generated)
- Modify: `hardware/scripts/fpmap.py`

**Interfaces:**
- Consumes: `quadpins.PART`, `quadpins.PINS`, `quadpins.FOOTPRINT`
- Produces: symbol `mccan_parts:<quad>` with one pin per pad and pin names equal to the `PINS` keys (`IN1`, `OUT1`, …) so the netlist's `pinfunction` is readable; `fpmap.fp()` entries for U11–U13, Q13, R108, D24, D25, C66, NT1, J1, J3, J4, J5, J9 and every new resistor/capacitor in Task 7

- [ ] **Step 1: Add the quad symbol to `symlib.py`, built from `quadpins.PINS`**

Pin electrical types: `IN*`, `DIAG_EN`, `SEL*` input; `OUT*` output; `SNS` output; `VS` power_in; `GND` power_in. Leave the plan3 symbols in the library — unused symbols cost nothing, and removing them is not this plan's work.

- [ ] **Step 2: Add the fpmap entries**

Footprints from D5, D6 and `quadpins.FOOTPRINT`. Every override carries its reason, per fpmap's rule 2. Remove the entries for deleted refs (J6, J7, R23, and the parts Tasks 4–7 delete) as each of those tasks deletes them — not here.

- [ ] **Step 3: Regenerate the library and confirm idempotence**

Run: `python symlib.py && python symlib.py && git status --short ../symbols/`
Expected: the library shows modified once; a second run changes nothing further (`git diff --stat` identical across the two runs).

- [ ] **Step 4: Commit**

```bash
git add hardware/scripts/symlib.py hardware/symbols/mccan_parts.kicad_sym hardware/scripts/fpmap.py
git commit -m "hw(lib): quad high-side switch symbol and phase-A footprint assignments"
```

---

### Task 4: `power_input` — delete ignition sense, add feed B

**Files:**
- Modify: `hardware/scripts/gen_power_input.py`, `hardware/scripts/layout_power_input.py`, `hardware/scripts/notes_power_input.py`
- Modify (generated): `hardware/sheets/power_input.kicad_sch`

**Interfaces:**
- Produces: hierarchical labels `VBAT_B` (output) on this sheet; `IGN_IN` removed

- [ ] **Step 1: Run the target groups and confirm they fail**

Run: `python -I check_netlist.py --only feed_b` (after a netlist export)
Expected: FAIL — `VBAT_B` absent.

- [ ] **Step 2: Remove `IGN_IN` from J1 and make J1 two-pin (D3, D5)**

J1 pin 1 becomes `FEED_P`, pin 2 `GND_IN`. Delete the ignition divider/clamp parts that lived on this sheet; the MCU-side ones go in Task 6.

- [ ] **Step 3: Add feed B per D6**, with the sheet note stating: feed B serves `AUX_R` only; never diode-OR it with `VBAT`; its fuse (3 A, harness-side) sits below the bike's 5 A circuit fuse.

- [ ] **Step 4: Regenerate twice, export the netlist, run the group**

Run: `python gen_power_input.py && python gen_power_input.py && git diff --stat` then the netlist export, then `python -I check_netlist.py --only feed_b`.
Expected: second run adds no diff; `PASS feed_b`. (The root has no `VBAT_B` pin yet, so ERC is not run until Task 8.)

- [ ] **Step 5: Commit**

```bash
git add hardware/scripts/gen_power_input.py hardware/scripts/layout_power_input.py hardware/scripts/notes_power_input.py hardware/sheets/power_input.kicad_sch hardware/scripts/fpmap.py
git commit -m "hw(power): feed B for AUX_R, and delete the ignition sense"
```

---

### Task 5: `rails` — delete the boost and `+3V3_SW`, `EN_3V3SW` becomes `EN_5V`

**Files:**
- Modify: `hardware/scripts/gen_rails.py`, `hardware/scripts/notes.py`, `hardware/scripts/fpmap.py`
- Modify (generated): `hardware/sheets/rails.kicad_sch`

**Interfaces:**
- Produces: hierarchical label `EN_5V` (input); `+24V`, `+3V3_SW`, `EN_BOOST`, `EN_3V3SW` removed

- [ ] **Step 1: Delete the LM51571 boost and everything only it uses**, and the DML3017 load switch with its bleed resistor, slew cap and `+3V3_SW` decoupling. Grep `hardware/scripts/` for `LM51571`, `DML3017`, `+24V`, `+3V3_SW` the same hour, so no generator, note or fpmap entry still names them.

- [ ] **Step 2: Rename `EN_3V3SW` to `EN_5V`**, now driving only the 5 V buck's `EN/UVLO`, keeping its existing pull-down. Update `notes.py`'s rail description: three domains (`+3V3_ALW`, gated `+5V`, protected `VBAT`) plus `VBAT_B` (spec §4.3).

- [ ] **Step 3: Regenerate twice, export, run `--only rails deleted`**

Expected: no diff on the second run; `PASS rails`. `deleted` still fails on the parts Tasks 6–7 remove — confirm the remaining failures are only those.

- [ ] **Step 4: Commit** the generator, notes, fpmap and sheet by name: `hw(rails): delete the 24 V boost and the switched 3V3 domain`.

---

### Task 6: `mcu_can` — the final pin map

**Files:**
- Modify: `hardware/scripts/gen_mcu_can.py`, `hardware/scripts/fpmap.py`
- Modify (generated): `hardware/sheets/mcu_can.kicad_sch`

**Interfaces:**
- Produces: hierarchical labels on this sheet for every D2 net that leaves it: the 12 `OUT_*`, `EN_5V`, `DIAG_EN`, `DIAG_SEL0`, `DIAG_SEL1`, `SNS_A`, `SNS_B`, `SNS_C`

- [ ] **Step 1: Confirm `--only mcu` fails**

- [ ] **Step 2: Rewire U5 to D2.** Delete `IGN_SENSE` (R37–R39, D7, C40), the I2C, mux, Denali and `EN_BOOST`/`EN_DIAG` nets and any pull resistor that served only them; delete `R23` (D4). Add the `DIAG_EN` pull-down (10 kΩ) on this sheet. Keep `R24` (TXD pull-up), `R25` (STB), `R36` (IO12 strap), the BOOT/EN/UART/LED circuitry unchanged.

- [ ] **Step 3: Verify every pad against the WROOM-32E datasheet's pin table**

Extract `esp32-wroom-32e_esp32-wroom-32ue_datasheet_en.pdf` to the scratchpad and confirm, for each D2 row, the pad number and that the GPIO is output-capable where D2 drives it (34/35/36/39 are input-only and appear only as inputs). Record any mismatch and stop.

- [ ] **Step 4: Regenerate twice, export, run `--only mcu boot_safety`**

Expected: no diff on the second run; `PASS mcu`. `boot_safety` may still fail until Task 7 adds the chips — confirm its failures are only "no IN nets found".

- [ ] **Step 5: Commit** by name: `hw(mcu): final GPIO map for twelve outputs, shared diagnostics and RTC CAN RX`.

---

### Task 7: `outputs` — three quads, the signal tails, the aux placeholders

**Files:**
- Modify: `hardware/scripts/gen_outputs.py` (rewrite of the channel section; keep its geometry helpers and lib-symbol plumbing)
- Modify: `hardware/scripts/fpmap.py`
- Modify (generated): `hardware/sheets/outputs.kicad_sch`

**Interfaces:**
- Consumes: `quadpins.*`, Task 6's hierarchical labels
- Produces: hierarchical labels matching Task 6's, consumed by `gen_root.py` in Task 8

- [ ] **Step 1: Confirm `--only outputs harness boot_safety` fails**

- [ ] **Step 2: Delete the plan3 output stage**: PCA9685, ADG706, the 12 NX5020 channels and shunts, the DNP snubbers, the BTS7008, the four PTCs, J6, J7, and their fpmap entries.

- [ ] **Step 3: Place U11–U13 per D1**, each with `C_VS` (≥ 63 V) on `VS`. Per used channel: GPIO net → `R_IN_SERIES` → `IN` net with `R_IN_PULLDOWN` to `GND`; `OUT` pads → the function net → its tail pin per D5; `C_OUT` to `GND` if `quadpins.C_OUT` is not `None` (≥ 63 V). Spare channels: `IN` pulled down, `OUT` pads no-connect; a sheet note on U13 ch3 saying it is reserved for `AUX_MODE` (spec §3) and wired in the kit plan.

- [ ] **Step 4: Sense and control paths.** Per chip: `SNS` → `R_SNS` to `GND`; series 4.7 kΩ → `SNS_A|B|C` (limits the clamp current from the 6.5 V fault level to ~0.6 mA); BAT54 anode on `SNS_x`, cathode on `+3V3_ALW`; 10 nF 0603 `SNS_x` → `GND`. `CL` → `R_CL` → `GND`. `THER` → `R_THER` → `+5V` (latch mode, so the firmware owns retry with backoff per spec §6.3; tied to the **gated** `+5V` so the pin's internal pull-down draws nothing in sleep). `FAULT` unconnected (no GPIO left; the per-chip sense line reports faults). `GND` pins and the exposed pad straight to `GND`: feed A's LTC4380 already blocks reverse polarity, so TI's GND network is not fitted.

- [ ] **Step 5: Aux placeholders.** `OUT_AUX_L` and `OUT_AUX_R` each end in a 47 kΩ pull-down to `GND` and a sheet note: switch stage, pod tail and `R100` re-size are kit-gated (spec §9.1).

- [ ] **Step 6: Regenerate twice, export, run `--only outputs harness boot_safety deleted`**

Expected: no diff on the second run; all four PASS.

- [ ] **Step 7: Commit** by name: `hw(outputs): ten signal channels on three quad smart high-side switches`.

---

### Task 8: Root sheet, ERC, and reading every net

**Files:**
- Modify: `hardware/scripts/gen_root.py`
- Modify (generated): `hardware/mccan.kicad_sch`, `hardware/output/erc.rpt`, `hardware/output/netlist.net`

- [ ] **Step 1: Update `PINS` in `gen_root.py`**: remove `IGN_IN` and every deleted inter-sheet net; add `VBAT_B` (power_input out), `EN_5V`, the 12 `OUT_*`, `DIAG_EN`, `DIAG_SEL0`, `DIAG_SEL1`, `SNS_A`–`SNS_C` (mcu_can ↔ outputs/rails). `VBAT_B` gets a root-level label and `PWR_FLAG`, with no consumer yet. Resize the sheet boxes to fit; keep the four sheet UUIDs fixed.

- [ ] **Step 2: Regenerate everything in order, twice**

Expected: the second full pass produces no diff anywhere under `hardware/`.

- [ ] **Step 3: ERC**

Run: `"/c/Program Files/KiCad/10.0/bin/kicad-cli.exe" sch erc --output hardware/output/erc.rpt hardware/mccan.kicad_sch` (180 s timeout)
Expected: 0 errors. Every warning is listed in the commit message with why it stands. A `hier_label_mismatch` means a Step 1 pin is missing.

- [ ] **Step 4: Full check, footprints, and read every net by hand**

Run: `python -I check_netlist.py && python -I verify_fpmap.py`
Expected: every group PASS; verify_fpmap exit 0.
Then dump `net → ref.pin` for the whole netlist and read every net. Look specifically for: nets that should have merged across sheets and did not (two halves of a rail with different names); any single-pin net; and the DNP set read back as a list, compared against intent (only plan3's surviving DNP parts, nothing new).

- [ ] **Step 5: Commit** by name, including `erc.rpt` and `netlist.net`: `hw(root): phase-A hierarchy; ERC clean, every net read`.

---

### Task 9: Documentation

**Files:**
- Modify: `hardware/docs/harness.md`, `hardware/docs/part-selection.md`, `hardware/README.md`
- Modify: `docs/superpowers/specs/2026-10-17-emarked-module-redesign-design.md` (on this branch **and** on `main`)

- [ ] **Step 1: `harness.md`**: replace the RGB/Denali/PWR rows with D5's tails and the wire gauges for spec §3.1's currents (front return 160 mA, rear return 200 mA: 22 AWG; feed A 2.86 A and feed B 2.48 A worst case: 18 AWG minimum); the two harness-side fuses (4 A feed A, 3 A feed B); the pod run marked kit-gated.

- [ ] **Step 2: `hardware/README.md`**: state that `mccan.kicad_pcb` and `output/gerbers/` are the abandoned plan3 board and no longer match the schematic.

- [ ] **Step 3: Spec updates** — §4.4 "two quad-channel parts" → three (D1, with the reason); §3.1 rear tail split (D5); §9.1 gains item 2a: `R100` sets ~9 A behind a 4 A fuse and is re-sized once pod inrush is measured (D7); §9.3 records that ignition sense is deleted (D3). Apply on this branch, then `git checkout plan4-emarked-modules -- <spec>` on `main` and commit there too, since `main` holds the current copy.

- [ ] **Step 4: Commit** on each branch, files by name: `docs: phase-A board decisions reach the spec and the hardware docs`.

---

### Task 10: Firmware pin table (on `main`)

**Files:**
- Modify: `src/main.cpp`

**Interfaces:**
- Consumes: D2, D4

- [ ] **Step 1: Update the pins**

`kOutputPins` in `OutputIndex` order = `{25, 26, 32, 33, 27, 16, 17, 18, 19, 21, 22, 23}`; `kCanRxPin = 35`; `kCanTxPin = 12` with a comment giving D4's reason (TX idles high, so it must never be a lamp pin; GPIO12 is wired only to its strap pull-down). Add `kEn5vPin = 4`, `kCanStbPin = 14`, `kDiagEnPin = 2`. Replace the "provisional" comment with one saying the table matches the phase-A schematic.

- [ ] **Step 2: Drive the new control pins in `setup()`**, after `g_out.begin()` and before the CAN driver starts: `DIAG_EN` low, `CAN_STB` low (normal mode), `EN_5V` high (the transceiver's `VCC`; without it nothing is received and every lamp stays dark).

- [ ] **Step 3: Native tests and the ESP32 build**

Run: `python -m platformio test -e native` then `py -3.13 -m platformio run -e esp32`
Expected: 95/95 native pass (`main.cpp` is not in the native build); ESP32 build SUCCESS.

- [ ] **Step 4: Commit** `src/main.cpp`: `feat(pins): output and CAN pins match the phase-A schematic`. This board does not exist yet, so the on-device output walk waits for it, and the plan does not claim it.

---

## Left for the kit plan (not tasks here)

The `AUX_L`/`AUX_R` dual switch (spec §4.4: current limit 3.0–3.5 A, latch before feed A's 4 A fuse, capacitive-load rated), the pod tail and `AUX_MODE` wiring, the `R100` re-size, the aux diagnostic pins (GPIO12 is the only spare output and is taken by TWAI TX; the aux sense needs an ADC1 pin that D2 has used up — the kit plan must share a sense line or free one), and then the 4-layer layout.
