JimboMcRackem/ESP32MCCAN/docs/superpowers/specs/2026-09-23-pcb-relayout-8layer-design.md

# ESP32 MCCAN — PCB Re-layout: 200 × 140 mm, 8 Layers

**Date:** 2026-09-23
**Status:** design, approved for planning
**Branch:** `plan3-pcb-hardware`
**Supersedes:** the board produced by Plan 3 Tasks 8–9 up to commit `4989e8a`. It does
**not** supersede `2026-09-11-esp32-mccan-pcb-hardware-design.md` — that document remains
the electrical specification. This one replaces its §9.1, §9.3 and §10 and nothing else.

---

## 1. Why this exists

The 6-layer, 140 × 100 mm board reached 0 DRC errors and 122 of 139 signal nets routed,
and it is still not a board worth fabricating. Three complaints, all of them the same
complaint:
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
