JimboMcRackem/ESP32MCCAN/docs/superpowers/specs/2026-07-29-esp32-mccan-lighting-firmware-design.md

# ESP32 MCCAN — Dynamic CAN-Driven Lighting Firmware

**Status:** Design approved (2026-07-29)
**Scope:** Firmware + configuration web app for the ESP32 lighting controller.
**Out of scope (future sessions):** PCB/hardware design, and app packaging beyond the self-hosted web app.

---

## 1. Overview
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
