JimboMcRackem/ESP32MCCAN/hardware/output/mccan-bom.csv

Refs | Value | Footprint | Qty | DNP
C1 | 100nF | Capacitor_SMD:C_0603_1608Metric | 1
C2 | 100nF | Capacitor_SMD:C_0805_2012Metric | 1
C3 | 220uF 63V | Capacitor_SMD:CP_Elec_10x10.5 | 1
C4 | 1uF | Capacitor_SMD:C_1206_3216Metric | 1
C5 | 100nF | Capacitor_SMD:C_0805_2012Metric | 1
C6 | 2.2uF | Capacitor_SMD:C_1206_3216Metric | 1
C7 | 100nF | Capacitor_SMD:C_0805_2012Metric | 1
C8 | 2.2nF | Capacitor_SMD:C_0603_1608Metric | 1
C9 | 68pF | Capacitor_SMD:C_0603_1608Metric | 1
C10 | 22uF | Capacitor_SMD:C_0603_1608Metric | 1
C11 | 22uF | Capacitor_SMD:C_0603_1608Metric | 1
C12 | 2.2uF | Capacitor_SMD:C_1206_3216Metric | 1
C13 | 100nF | Capacitor_SMD:C_0805_2012Metric | 1
C14 | 2.2nF | Capacitor_SMD:C_0603_1608Metric | 1
C15 | 39pF | Capacitor_SMD:C_0603_1608Metric | 1
C16 | 22uF | Capacitor_SMD:C_0603_1608Metric | 1
C17 | 100nF | Capacitor_SMD:C_0603_1608Metric | 1
C18 | 10uF | Capacitor_SMD:C_1210_3225Metric | 1
C19 | 10uF | Capacitor_SMD:C_1210_3225Metric | 1
C20 | 4.7uF | Capacitor_SMD:C_1206_3216Metric | 1
C21 | 4.7uF | Capacitor_SMD:C_1206_3216Metric | 1
C22 | 4.7uF | Capacitor_SMD:C_1206_3216Metric | 1
C23 | 10nF | Capacitor_SMD:C_0603_1608Metric | 1
C24 | 100pF | Capacitor_SMD:C_0603_1608Metric | 1
C25 | 22nF | Capacitor_SMD:C_0603_1608Metric | 1
C26 | 1uF | Capacitor_SMD:C_0603_1608Metric | 1
C27 | 100nF | Capacitor_SMD:C_0603_1608Metric | 1
C28 | 2.2nF | Capacitor_SMD:C_0603_1608Metric | 1
C29 | 2.2nF | Capacitor_SMD:C_0603_1608Metric | 1
C30 | 1uF | Capacitor_SMD:C_0603_1608Metric | 1
C31 | 1uF | Capacitor_SMD:C_0603_1608Metric | 1
C32 | 1nF | Capacitor_SMD:C_0603_1608Metric | 1
C33 | 100nF | Capacitor_SMD:C_0603_1608Metric | 1
C34 | 10uF | Capacitor_SMD:C_0603_1608Metric | 1
C35 | 10uF | Capacitor_SMD:C_0603_1608Metric | 1
C36 | 100nF | Capacitor_SMD:C_0603_1608Metric | 1
C37 | 1uF | Capacitor_SMD:C_0603_1608Metric | 1
C38 | 100nF | Capacitor_SMD:C_0603_1608Metric | 1
C39 | 100nF | Capacitor_SMD:C_0603_1608Metric | 1
C40 | 100nF | Capacitor_SMD:C_0603_1608Metric | 1
C41 | 10uF | Capacitor_SMD:C_0603_1608Metric | 1
C42 | 100nF | Capacitor_SMD:C_0603_1608Metric | 1
C43 | 100nF | Capacitor_SMD:C_0603_1608Metric | 1
C44 | 10nF | Capacitor_SMD:C_0603_1608Metric | 1
C45 | 10uF | Capacitor_SMD:C_1210_3225Metric | 1
C46 | 100nF | Capacitor_SMD:C_0805_2012Metric | 1
C47 | 220pF | Capacitor_SMD:C_0603_1608Metric | 1
C48 | 10nF | Capacitor_SMD:C_0603_1608Metric | 1
C49 | 10nF | Capacitor_SMD:C_1206_3216Metric | 1 | DNP
C50 | 10nF | Capacitor_SMD:C_1206_3216Metric | 1 | DNP
C51 | 10nF | Capacitor_SMD:C_1206_3216Metric | 1 | DNP
C52 | 10nF | Capacitor_SMD:C_1206_3216Metric | 1 | DNP
C53 | 10nF | Capacitor_SMD:C_1206_3216Metric | 1 | DNP
C54 | 10nF | Capacitor_SMD:C_1206_3216Metric | 1 | DNP
C55 | 10nF | Capacitor_SMD:C_1206_3216Metric | 1 | DNP
C56 | 10nF | Capacitor_SMD:C_1206_3216Metric | 1 | DNP
C57 | 10nF | Capacitor_SMD:C_1206_3216Metric | 1 | DNP
C58 | 10nF | Capacitor_SMD:C_1206_3216Metric | 1 | DNP
C59 | 10nF | Capacitor_SMD:C_1206_3216Metric | 1 | DNP
C60 | 10nF | Capacitor_SMD:C_1206_3216Metric | 1 | DNP
C61 | 10pF | Capacitor_SMD:C_0603_1608Metric | 1 | DNP
C62 | 680nF | Capacitor_SMD:C_0603_1608Metric | 1
C63 | 220nF | Capacitor_SMD:C_0603_1608Metric | 1
C64 | 47nF | Capacitor_SMD:C_0805_2012Metric | 1
C65 | 22uF 63V | Capacitor_SMD:CP_Elec_6.3x7.7 | 1
D2 | SMBJ24A | Diode_SMD:D_SMB | 1
D3 | Schottky 40V | Diode_SMD:D_SMA | 1
D4 | SS5PH102 | Package_TO_SOT_SMD:TO-277A | 1
D5 | green | LED_SMD:LED_0603_1608Metric | 1
D6 | PESD2CANFD24U-T | Package_TO_SOT_SMD:SOT-23 | 1
D7 | BAT54 | Diode_SMD:D_SOD-123 | 1
D8 | BAT54 | Diode_SMD:D_SOD-123 | 1
D9 | BAT54 | Diode_SMD:D_SOD-123 | 1
D10 | BAT54 | Diode_SMD:D_SOD-123 | 1
D11 | BAT54 | Diode_SMD:D_SOD-123 | 1
D12 | BAT54 | Diode_SMD:D_SOD-123 | 1
D13 | BAT54 | Diode_SMD:D_SOD-123 | 1
D14 | BAT54 | Diode_SMD:D_SOD-123 | 1
D15 | BAT54 | Diode_SMD:D_SOD-123 | 1
D16 | BAT54 | Diode_SMD:D_SOD-123 | 1
D17 | BAT54 | Diode_SMD:D_SOD-123 | 1
D18 | BAT54 | Diode_SMD:D_SOD-123 | 1
D19 | BAT54 | Diode_SMD:D_SOD-123 | 1
D20 | BAT54 | Diode_SMD:D_SOD-123 | 1
D21 | 22V | Diode_SMD:D_SOD-123 | 1
D22 | 1N4148 | Diode_SMD:D_SOD-323 | 1
D23 | 1N4148 | Diode_SMD:D_SOD-323 | 1
F2 | 1206L050/24 | Fuse:Fuse_1206_3216Metric | 1
F3 | 1206L050/24 | Fuse:Fuse_1206_3216Metric | 1
F4 | 1206L050/24 | Fuse:Fuse_1206_3216Metric | 1
F5 | 1206L050/24 | Fuse:Fuse_1206_3216Metric | 1
J2 | Prog/UART | Connector_PinHeader_2.54mm:PinHeader_1x06_P2.54mm_Vertical | 1
L1 | 1.5uH | Inductor_SMD:L_Vishay_IHLP-4040 | 1
L2 | 7448031002 | mccan:Wurth_WE-CMBNC_7448031002 | 1
L3 | 6.8uH XAL4030-682ME | Inductor_SMD:L_Coilcraft_XAL4030-XXX | 1
L4 | XAL7070-223ME | Inductor_SMD:L_Coilcraft_XAL7070-XXX | 1
L5 | XAL7070-223ME | Inductor_SMD:L_Coilcraft_XAL7070-XXX | 1
L6 | ACT45B-510-2P-TL003 | mccan:TDK_ACT45B | 1
Q2 | MMBT3904 | Package_TO_SOT_SMD:SOT-23 | 1
Q3 | MMBT3904 | Package_TO_SOT_SMD:SOT-23 | 1
Q4 | NX5020UNBKS | Package_TO_SOT_SMD:SOT-363_SC-70-6 | 1
Q5 | NX5020UNBKS | Package_TO_SOT_SMD:SOT-363_SC-70-6 | 1
Q6 | NX5020UNBKS | Package_TO_SOT_SMD:SOT-363_SC-70-6 | 1
Q7 | NX5020UNBKS | Package_TO_SOT_SMD:SOT-363_SC-70-6 | 1
Q8 | NX5020UNBKS | Package_TO_SOT_SMD:SOT-363_SC-70-6 | 1
Q9 | NX5020UNBKS | Package_TO_SOT_SMD:SOT-363_SC-70-6 | 1
Q10 | IPT008N06NM5LF | Package_TO_SOT_SMD:Infineon_PG-HSOF-8-1 | 1
Q11 | IPT008N06NM5LF | Package_TO_SOT_SMD:Infineon_PG-HSOF-8-1 | 1
Q12 | MMBT3904 | Package_TO_SOT_SMD:SOT-23 | 1
R2 | 0R (link) | Resistor_SMD:R_2512_6332Metric | 1 | DNP
R3 | 0R (link) | Resistor_SMD:R_2512_6332Metric | 1 | DNP
R4 | 20.5k | Resistor_SMD:R_0603_1608Metric | 1
R5 | 348k | Resistor_SMD:R_0603_1608Metric | 1
R6 | 200k | Resistor_SMD:R_0603_1608Metric | 1
R7 | 31.6k | Resistor_SMD:R_0603_1608Metric | 1
R8 | 634k | Resistor_SMD:R_0603_1608Metric | 1
R9 | 200k | Resistor_SMD:R_0603_1608Metric | 1
R10 | 9.09k | Resistor_SMD:R_0603_1608Metric | 1
R11 | 37.4k | Resistor_SMD:R_0603_1608Metric | 1
R12 | 576k | Resistor_SMD:R_0603_1608Metric | 1
R13 | 24.9k | Resistor_SMD:R_0603_1608Metric | 1
R14 | 2.61k | Resistor_SMD:R_0603_1608Metric | 1
R15 | 5.1R | Resistor_SMD:R_0603_1608Metric | 1
R16 | 0R | Resistor_SMD:R_0603_1608Metric | 1
R17 | 133k | Resistor_SMD:R_0603_1608Metric | 1
R18 | 174k | Resistor_SMD:R_0603_1608Metric | 1
R19 | 100k | Resistor_SMD:R_0603_1608Metric | 1
R20 | 100k | Resistor_SMD:R_0603_1608Metric | 1
R21 | 100R | Resistor_SMD:R_0603_1608Metric | 1
R22 | 10k | Resistor_SMD:R_0603_1608Metric | 1
R23 | 0R | Resistor_SMD:R_0603_1608Metric | 1 | DNP
R24 | 10k | Resistor_SMD:R_0603_1608Metric | 1
R25 | 10k | Resistor_SMD:R_0603_1608Metric | 1
R26 | 120R | Resistor_SMD:R_0603_1608Metric | 1 | DNP
R27 | 1k | Resistor_SMD:R_0603_1608Metric | 1
R28 | 10k | Resistor_SMD:R_0603_1608Metric | 1
R29 | 10k | Resistor_SMD:R_0603_1608Metric | 1
R30 | 10k | Resistor_SMD:R_0603_1608Metric | 1
R31 | 10k | Resistor_SMD:R_0603_1608Metric | 1
R32 | 10k | Resistor_SMD:R_0603_1608Metric | 1
R33 | 10k | Resistor_SMD:R_0603_1608Metric | 1
R34 | 10k | Resistor_SMD:R_0603_1608Metric | 1
R35 | 10k | Resistor_SMD:R_0603_1608Metric | 1
R36 | 10k | Resistor_SMD:R_0603_1608Metric | 1
R37 | 90.9k | Resistor_SMD:R_0603_1608Metric | 1 | DNP
R38 | 33k | Resistor_SMD:R_0603_1608Metric | 1 | DNP
R39 | 100k | Resistor_SMD:R_0603_1608Metric | 1
R40 | 10k | Resistor_SMD:R_0603_1608Metric | 1
R41 | 10k | Resistor_SMD:R_0603_1608Metric | 1
R42 | 10k | Resistor_SMD:R_0603_1608Metric | 1
R43 | 10k | Resistor_SMD:R_0603_1608Metric | 1
R44 | 10k | Resistor_SMD:R_0603_1608Metric | 1
R45 | 10k | Resistor_SMD:R_0603_1608Metric | 1
R46 | 10k | Resistor_SMD:R_0603_1608Metric | 1
R47 | 10k | Resistor_SMD:R_0603_1608Metric | 1
R48 | 10k | Resistor_SMD:R_0603_1608Metric | 1
R49 | 10k | Resistor_SMD:R_0603_1608Metric | 1
R50 | 10k | Resistor_SMD:R_0603_1608Metric | 1
R51 | 10k | Resistor_SMD:R_0603_1608Metric | 1
R52 | 10R | Resistor_SMD:R_1206_3216Metric | 1
R53 | 10R | Resistor_SMD:R_1206_3216Metric | 1
R54 | 10R | Resistor_SMD:R_1206_3216Metric | 1
R55 | 10R | Resistor_SMD:R_1206_3216Metric | 1
R56 | 10R | Resistor_SMD:R_1206_3216Metric | 1
R57 | 10R | Resistor_SMD:R_1206_3216Metric | 1
R58 | 10R | Resistor_SMD:R_1206_3216Metric | 1
R59 | 10R | Resistor_SMD:R_1206_3216Metric | 1
R60 | 10R | Resistor_SMD:R_1206_3216Metric | 1
R61 | 10R | Resistor_SMD:R_1206_3216Metric | 1
R62 | 10R | Resistor_SMD:R_1206_3216Metric | 1
R63 | 10R | Resistor_SMD:R_1206_3216Metric | 1
R64 | 10k | Resistor_SMD:R_0603_1608Metric | 1
R65 | 10k | Resistor_SMD:R_0603_1608Metric | 1
R66 | 10k | Resistor_SMD:R_0603_1608Metric | 1
R67 | 10k | Resistor_SMD:R_0603_1608Metric | 1
R68 | 10k | Resistor_SMD:R_0603_1608Metric | 1
R69 | 10k | Resistor_SMD:R_0603_1608Metric | 1
R70 | 10k | Resistor_SMD:R_0603_1608Metric | 1
R71 | 10k | Resistor_SMD:R_0603_1608Metric | 1
R72 | 10k | Resistor_SMD:R_0603_1608Metric | 1
R73 | 10k | Resistor_SMD:R_0603_1608Metric | 1
R74 | 10k | Resistor_SMD:R_0603_1608Metric | 1
R75 | 10k | Resistor_SMD:R_0603_1608Metric | 1
R76 | 4.7k | Resistor_SMD:R_0603_1608Metric | 1
R77 | 4.7k | Resistor_SMD:R_0603_1608Metric | 1
R78 | 10k | Resistor_SMD:R_0603_1608Metric | 1
R79 | 4.7k | Resistor_SMD:R_0603_1608Metric | 1
R80 | 4.7k | Resistor_SMD:R_0603_1608Metric | 1
R81 | 2.2k | Resistor_SMD:R_0603_1608Metric | 1
R82 | 4.7k | Resistor_SMD:R_0603_1608Metric | 1
R83 | 4.7k | Resistor_SMD:R_0603_1608Metric | 1
R84 | 4.7k | Resistor_SMD:R_0603_1608Metric | 1
R85 | 4.7k | Resistor_SMD:R_0603_1608Metric | 1
R86 | 10k | Resistor_SMD:R_0603_1608Metric | 1
R87 | 10k | Resistor_SMD:R_0603_1608Metric | 1
R88 | 100R | Resistor_SMD:R_1206_3216Metric | 1 | DNP
R89 | 100R | Resistor_SMD:R_1206_3216Metric | 1 | DNP
R90 | 100R | Resistor_SMD:R_1206_3216Metric | 1 | DNP
R91 | 100R | Resistor_SMD:R_1206_3216Metric | 1 | DNP
R92 | 100R | Resistor_SMD:R_1206_3216Metric | 1 | DNP
R93 | 100R | Resistor_SMD:R_1206_3216Metric | 1 | DNP
R94 | 100R | Resistor_SMD:R_1206_3216Metric | 1 | DNP
R95 | 100R | Resistor_SMD:R_1206_3216Metric | 1 | DNP
R96 | 100R | Resistor_SMD:R_1206_3216Metric | 1 | DNP
R97 | 100R | Resistor_SMD:R_1206_3216Metric | 1 | DNP
R98 | 100R | Resistor_SMD:R_1206_3216Metric | 1 | DNP
R99 | 100R | Resistor_SMD:R_1206_3216Metric | 1 | DNP
R100 | 5m6 1% 1W | Resistor_SMD:R_2512_6332Metric | 1
R101 | 30k | Resistor_SMD:R_1206_3216Metric | 1
R102 | 10R | Resistor_SMD:R_0603_1608Metric | 1
R103 | 33R | Resistor_SMD:R_0603_1608Metric | 1
R104 | 10k | Resistor_SMD:R_0603_1608Metric | 1
R105 | 240k | Resistor_SMD:R_1206_3216Metric | 1
R106 | 10k | Resistor_SMD:R_0603_1608Metric | 1
R107 | 240k | Resistor_SMD:R_1206_3216Metric | 1
SW1 | BOOT | Button_Switch_SMD:Panasonic_EVQPUJ_EVQPUA | 1
SW2 | EN/RESET | Button_Switch_SMD:Panasonic_EVQPUJ_EVQPUA | 1
U1 | LM5164DDA | Package_SO:SOIC-8-1EP_3.9x4.9mm_P1.27mm_EP2.62x3.51mm | 1
U2 | LM5164DDA | Package_SO:SOIC-8-1EP_3.9x4.9mm_P1.27mm_EP2.62x3.51mm | 1
U3 | LM51571-Q1 | Package_DFN_QFN:QFN-16-1EP_3x3mm_P0.5mm_EP1.675x1.675mm | 1
U4 | DML3017LDC | Package_DFN_QFN:DFN-12-1EP_3x3mm_P0.5mm_EP2.05x2.86mm | 1
U5 | ESP32-WROOM-32E-N8 | RF_Module:ESP32-WROOM-32E | 1
U6 | TJA1042T/3 | Package_SO:SOIC-8_3.9x4.9mm_P1.27mm | 1
U7 | PCA9685PW/Q900 | Package_SO:TSSOP-28_4.4x9.7mm_P0.65mm | 1
U8 | ADG706 | Package_SO:TSSOP-28_4.4x9.7mm_P0.65mm | 1
U9 | BTS7008-2EPA | Package_SO:Infineon_PG-TSDSO-14-22 | 1
U10 | LTC4380HMS-2 | Package_SO:MSOP-10_3x3mm_P0.5mm | 1
