JimboMcRackem/ESP32MCCAN/hardware/3dmodels/Wurth_WE-CMBNC_7448031002.stp

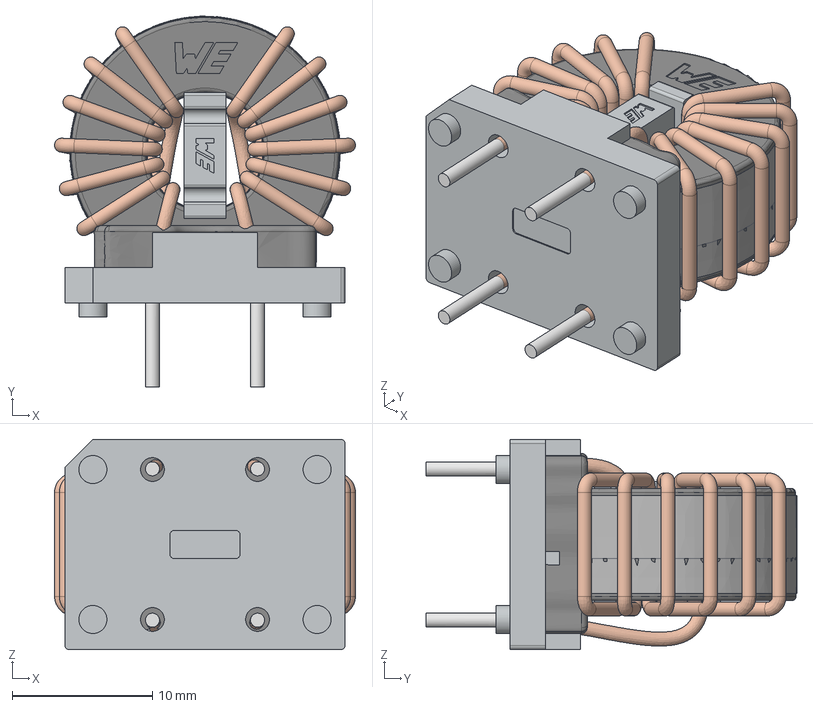
[picture p1: CAD file, 2026-09-18]
hardware/3dmodels/Wurth_WE-CMBNC_7448031002.stp
21.5 x 26.5 x 15.0 mm
BASE-4P-22
SPACER-0909-1
CASE-T1610-3A_0
CASE-T1610-3B_0
PRT0001_0
tesaM1
glueM6
turns_m
