JimboMcRackem/ESP32MCCAN/hardware/output/mccan-assembly.pdf

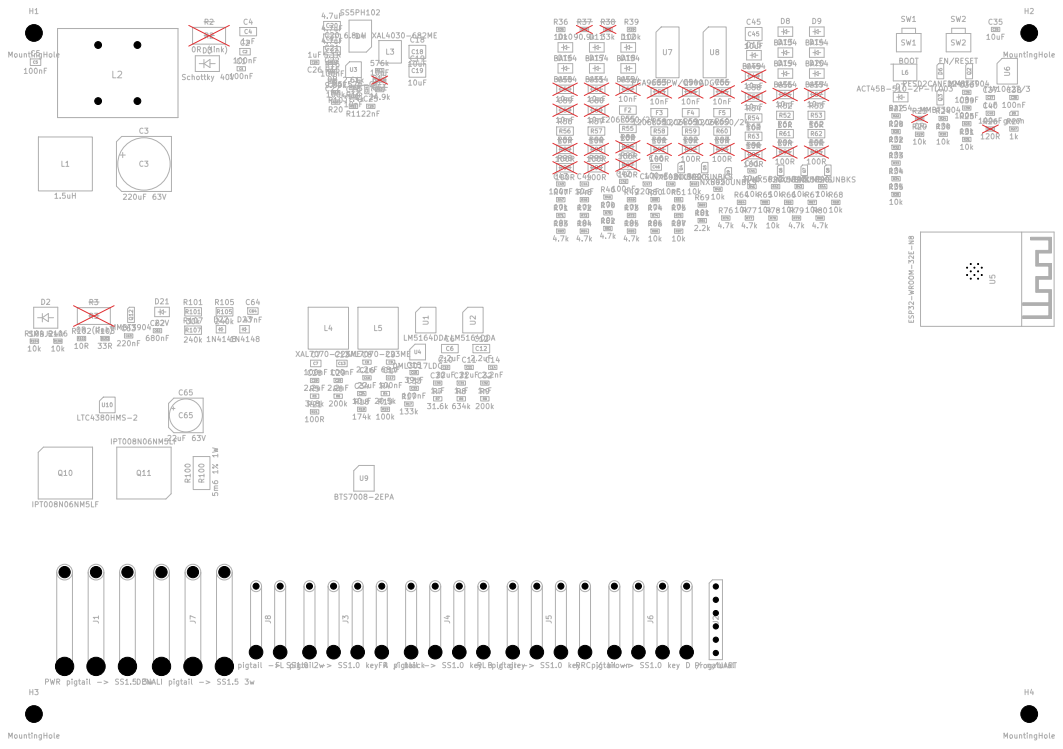
[picture p2: page 1]

FL pigtail -> SS1.0 key A / black J3

Board 200 x 140 mm, 8 layer, 1 oz copper on all layers
GENERATED by scripts/gen_pcb.py -- do not edit in pcbnew

Sheet:
File: mccan.kicad_pcb
Title: MCCAN Lighting Controller

Size: A3 | Rev: | F Date:
KiCad E.D.A. 10.0.2 | Id: 1/4

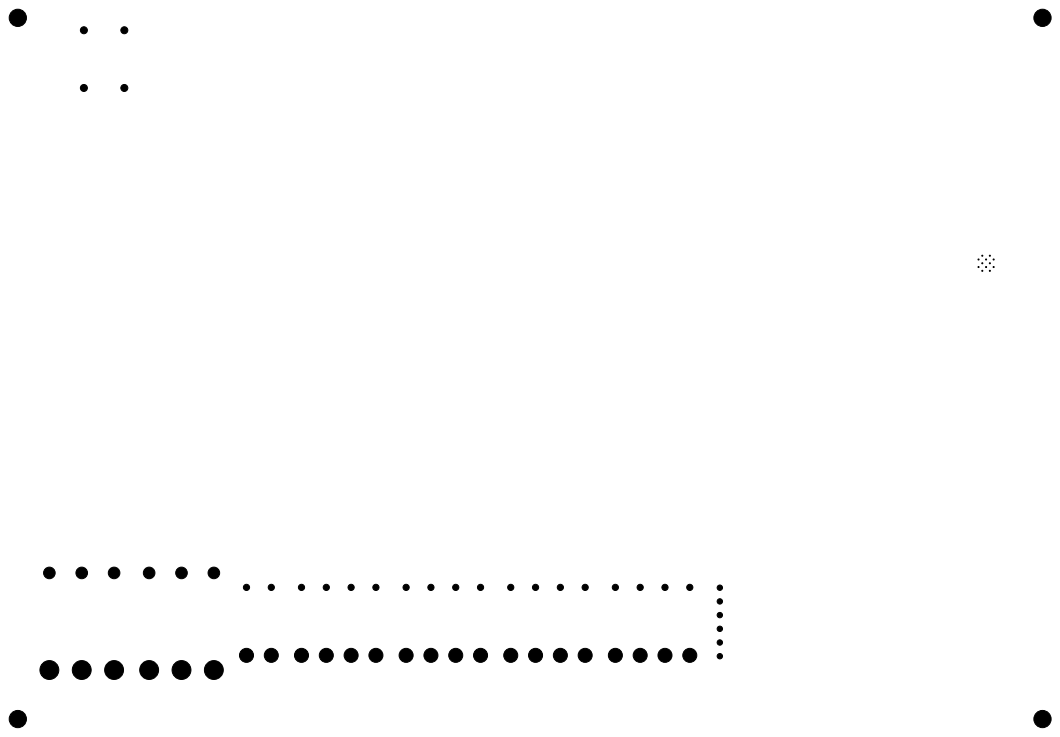
[picture p3: page 2]
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

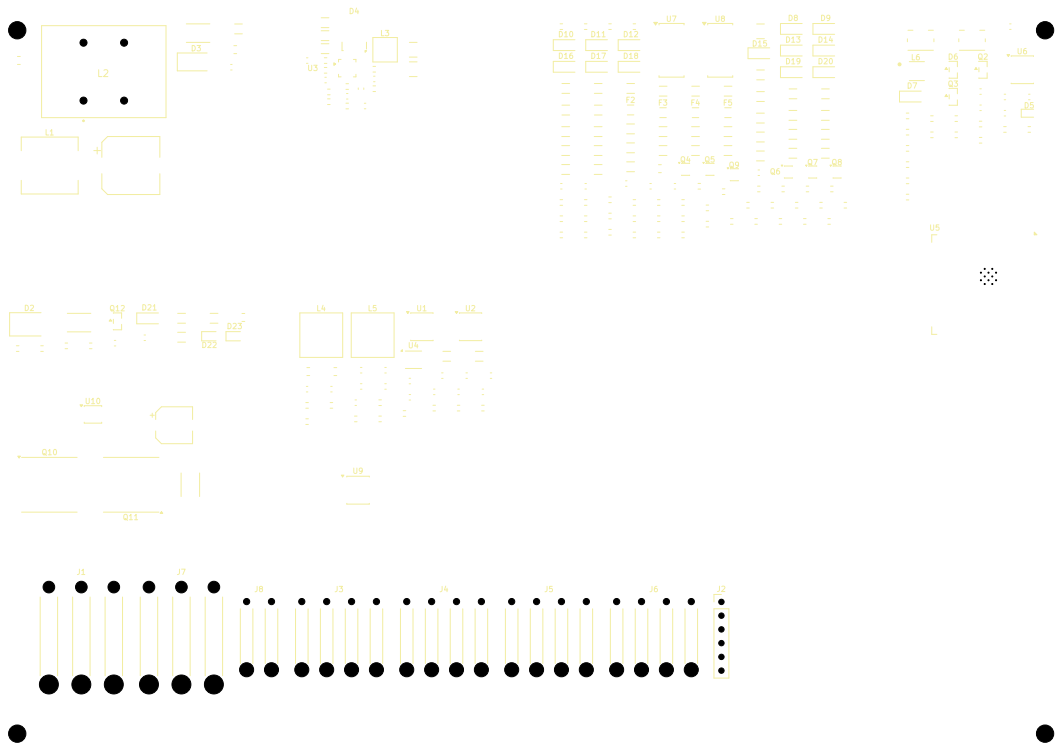
[picture p4: page 3]
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

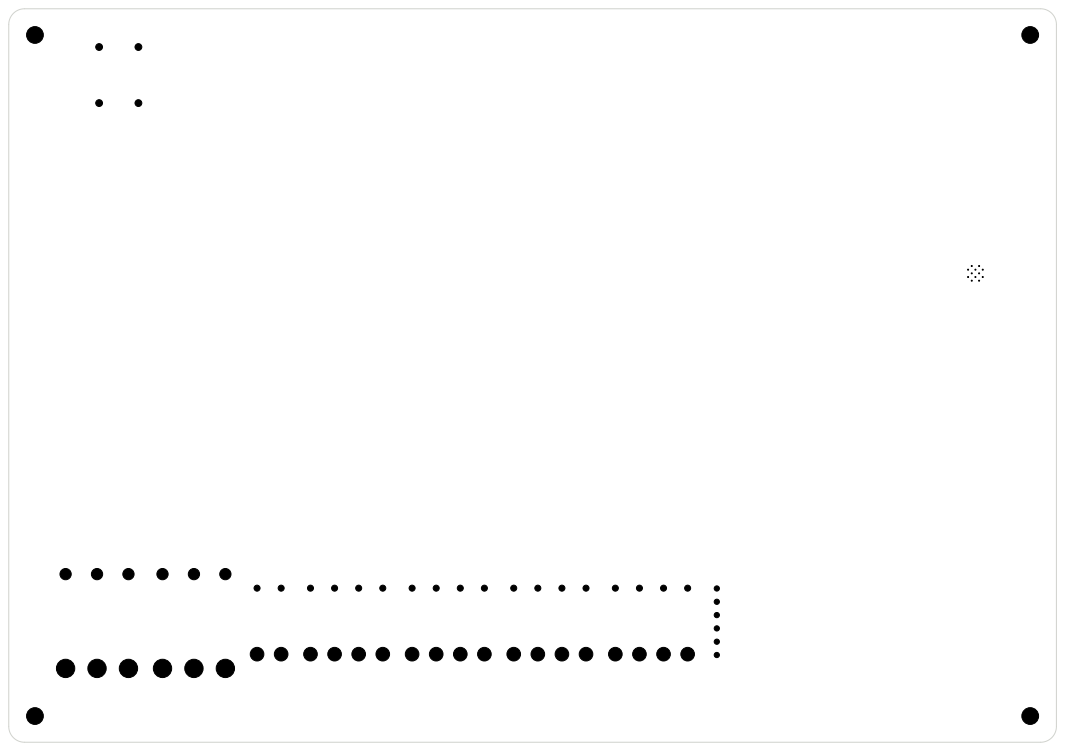
[picture p5: page 4]
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
