JimboMcRackem/ESP32MCCAN/hardware/mccan.kicad_pcb

## KiCad design hardware/mccan.kicad_pcb (2026-09-27)

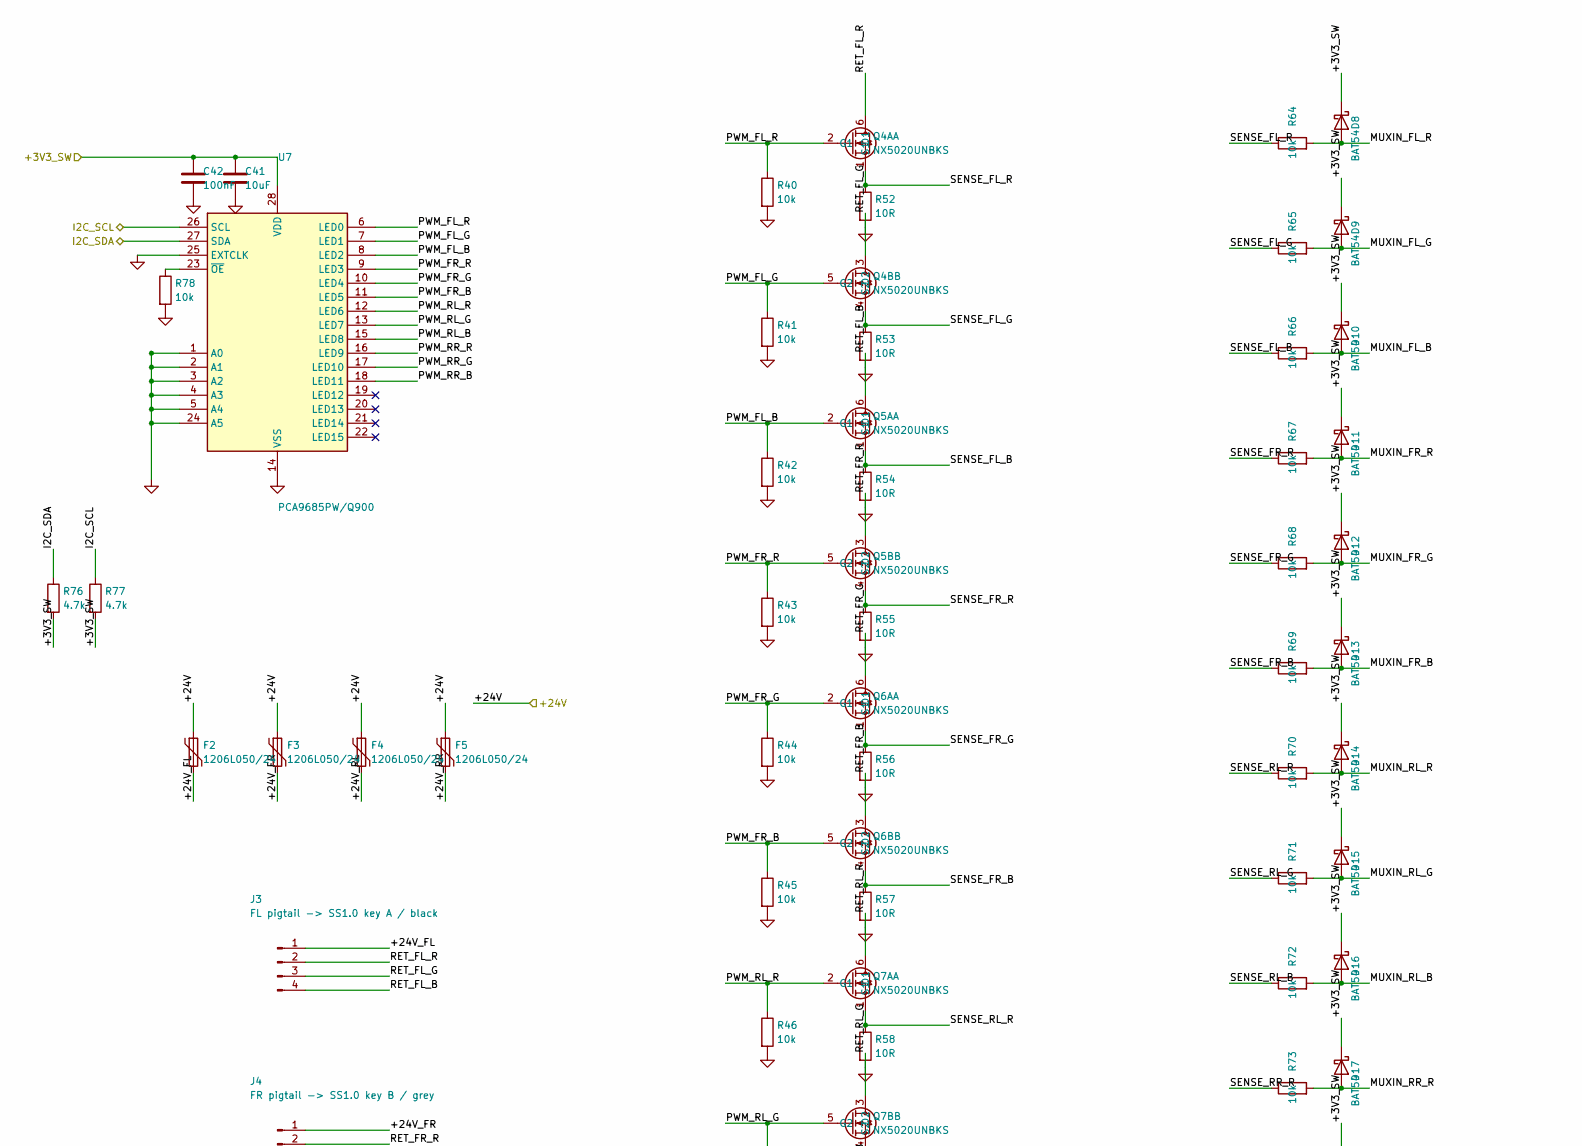
[picture p11: schematic outputs.kicad_sch, part in row 1, column 1]

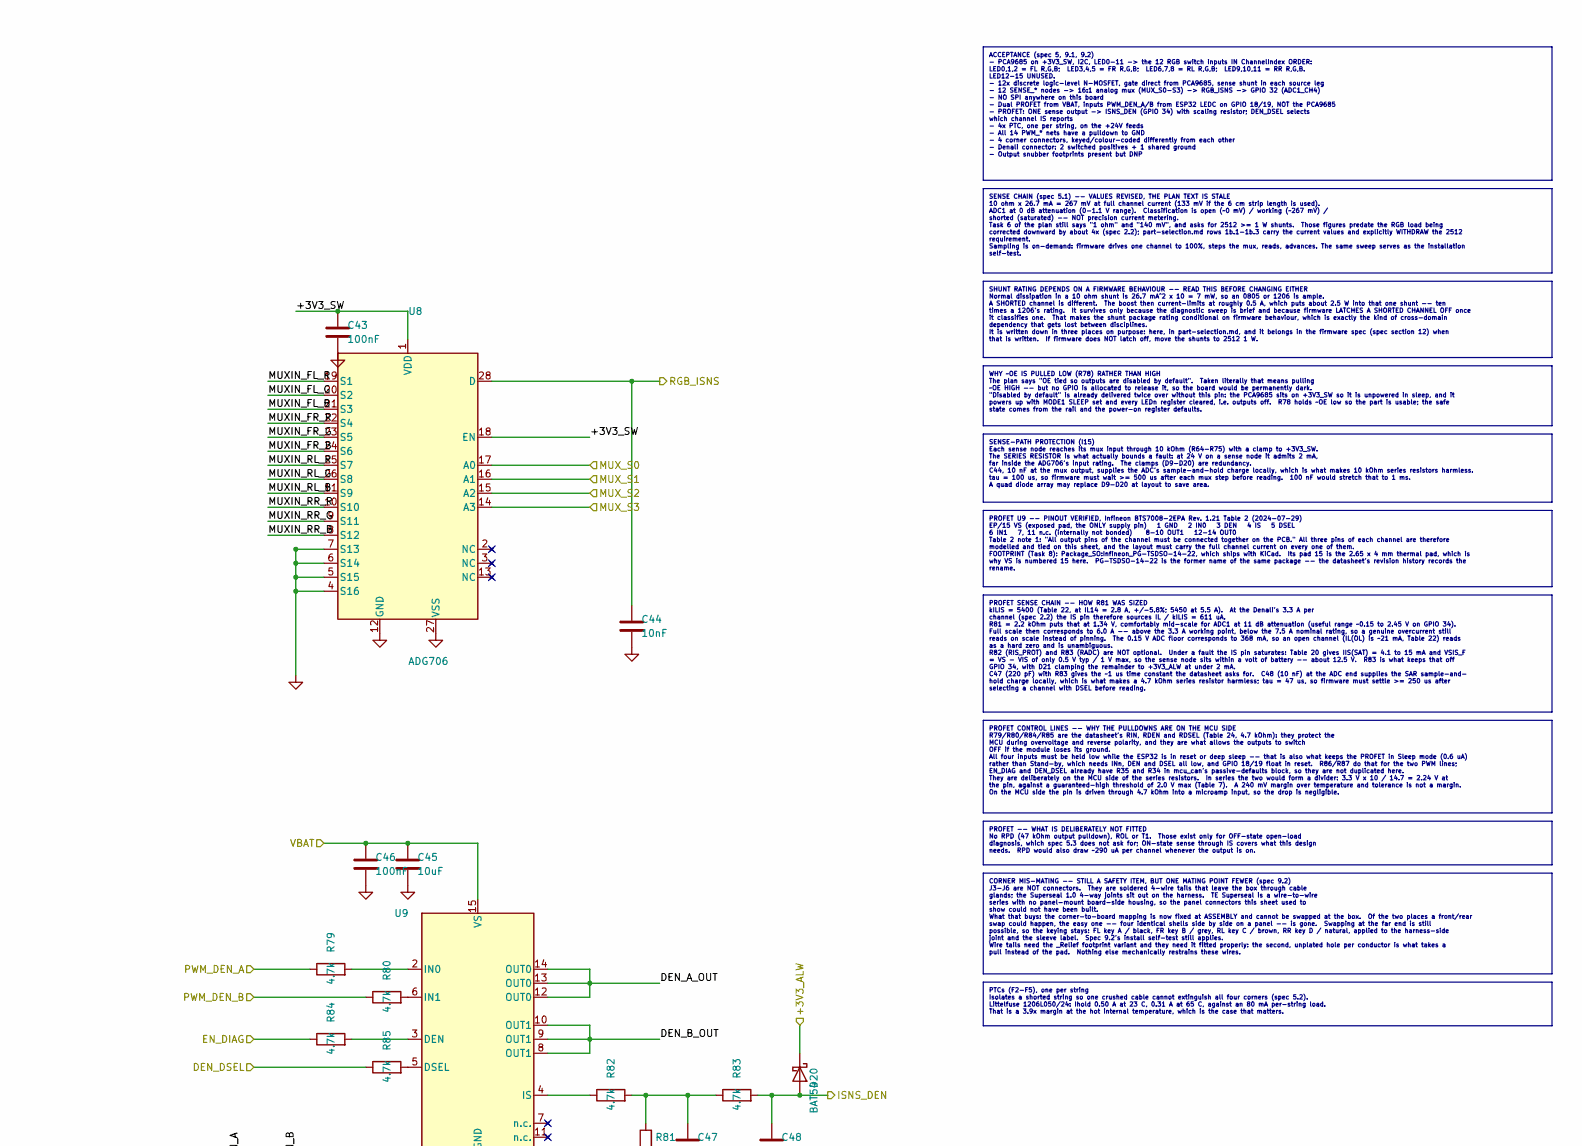
[picture p12: schematic outputs.kicad_sch, part in row 1, column 2]

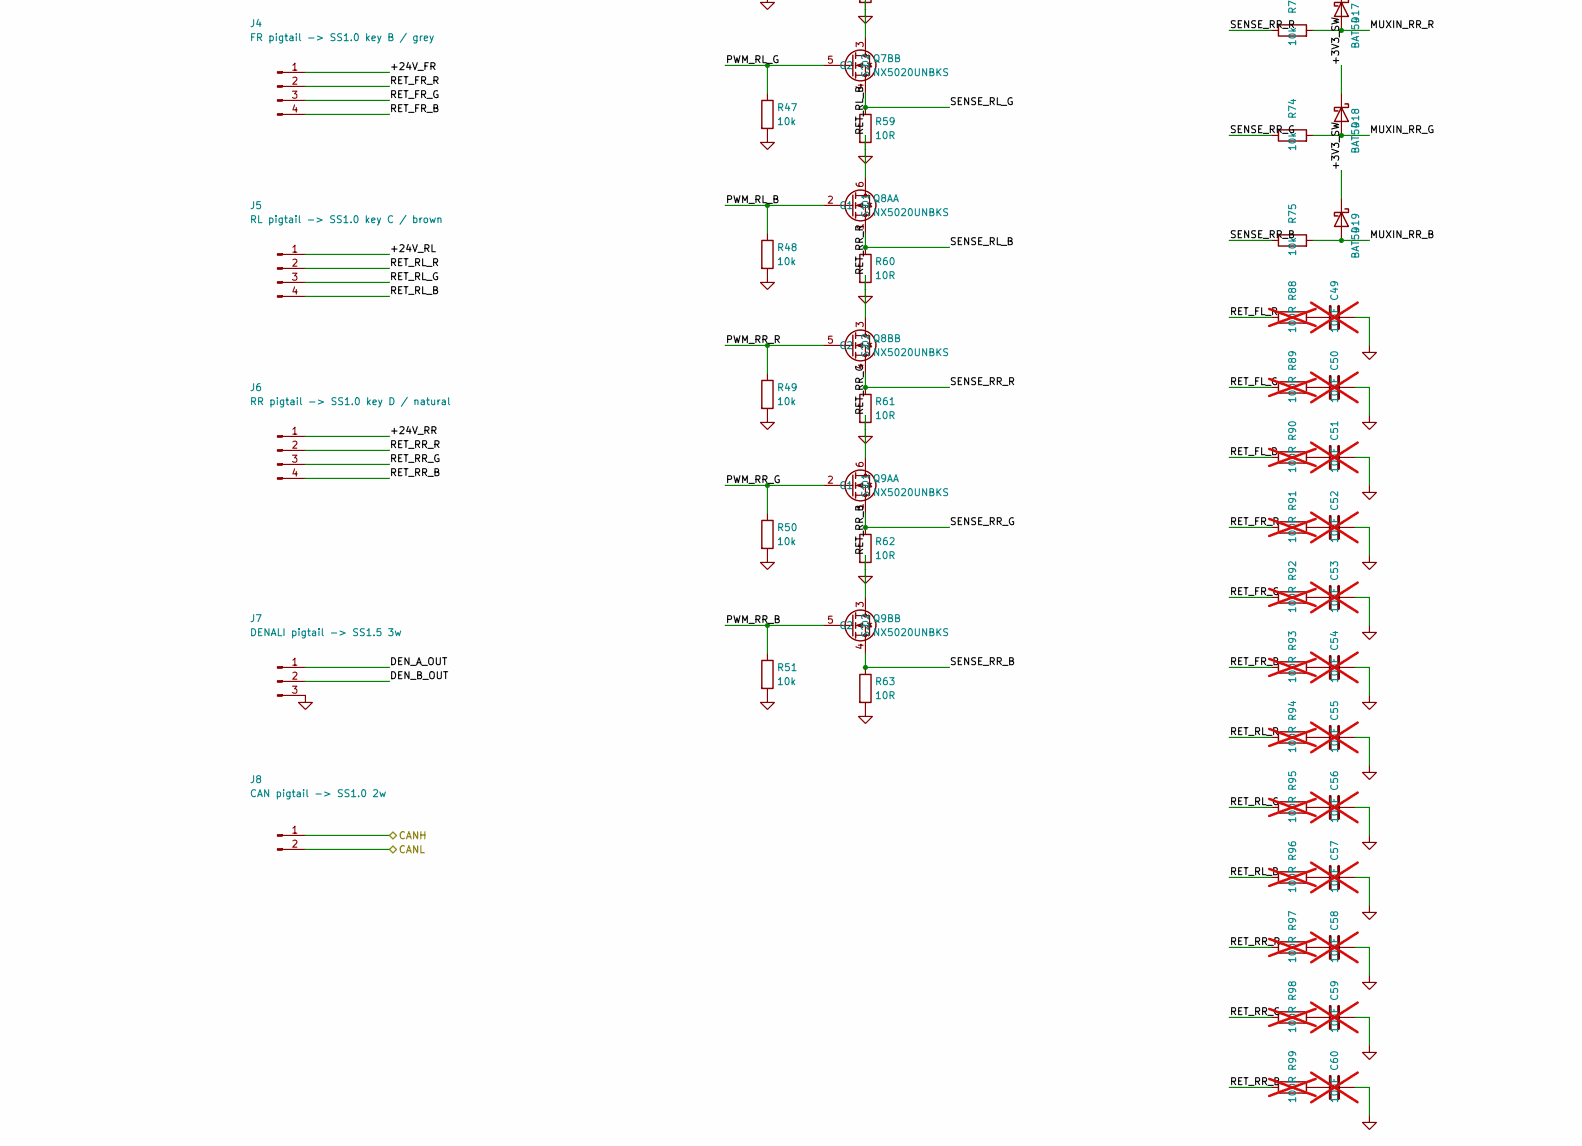
[picture p13: schematic outputs.kicad_sch, part in row 2, column 1]

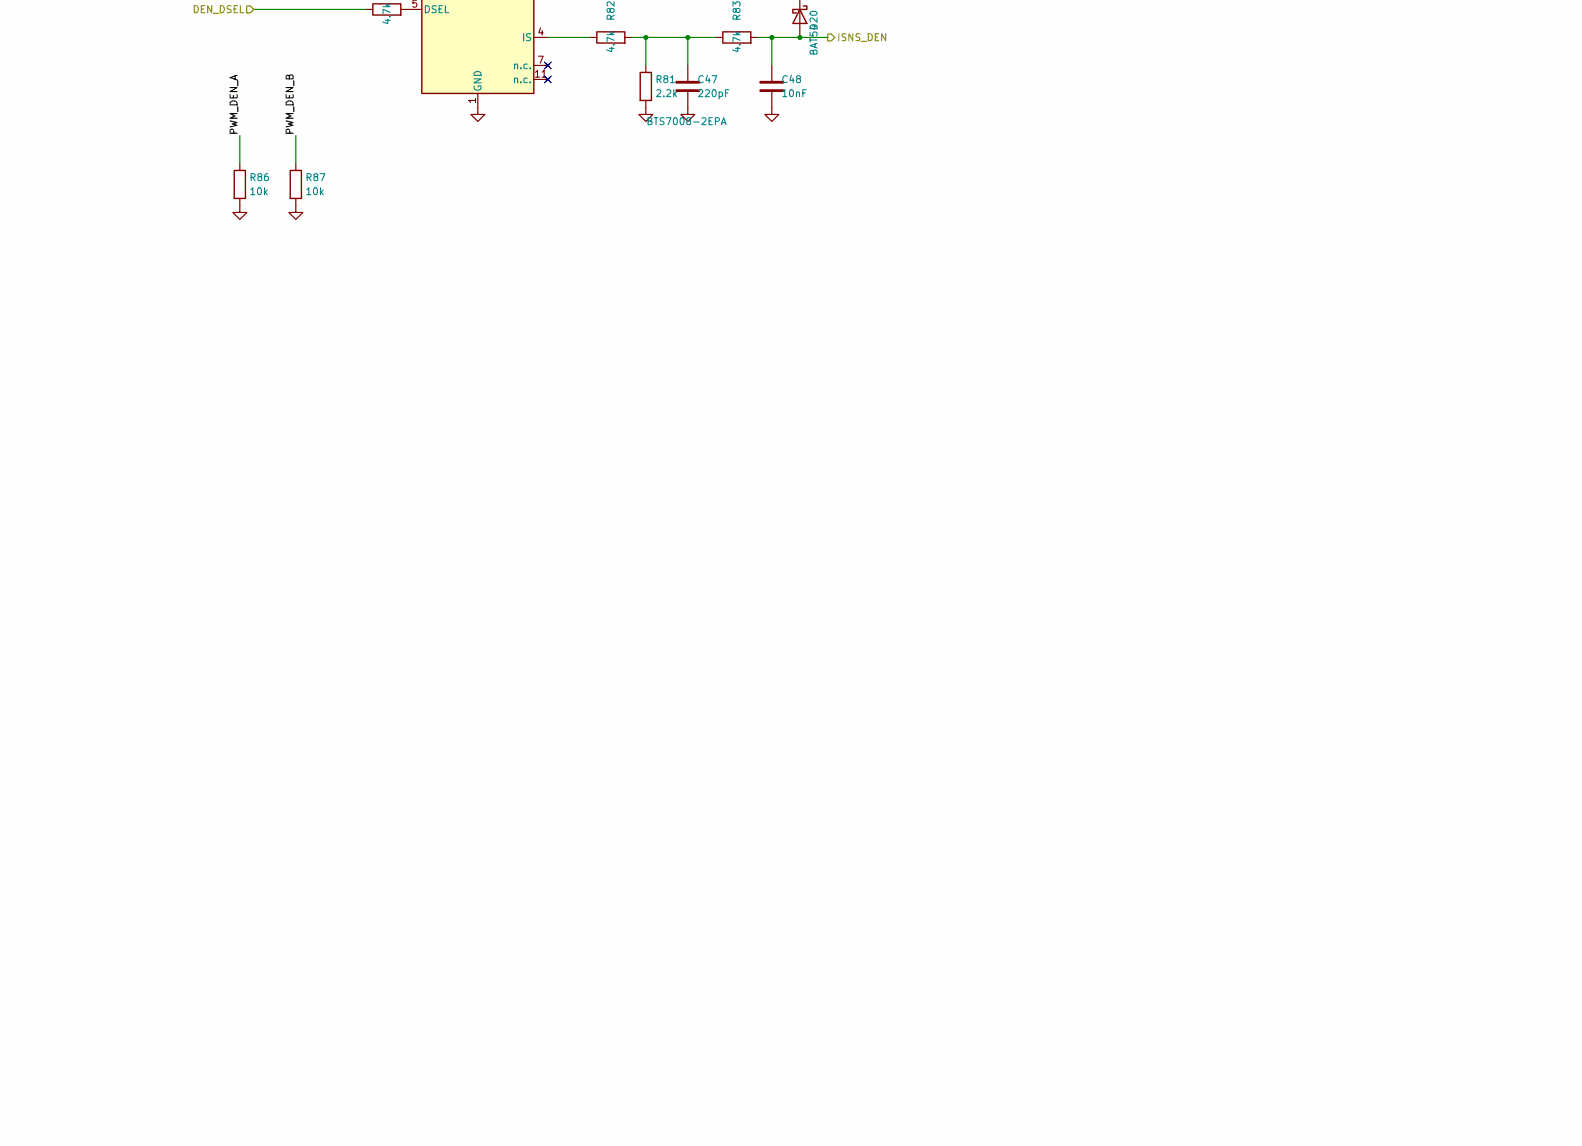
[picture p14: schematic outputs.kicad_sch, part in row 2, column 2]

Parts:
C41: 10uF; C_0603_1608Metric
C42, C43: 100nF; C_0603_1608Metric
C44, C48: 10nF; C_0603_1608Metric
C45: 10uF; C_1210_3225Metric
C46: 100nF; C_0805_2012Metric
C47: 220pF; C_0603_1608Metric
C49, C50, C51, C52, C53, C54, C55, C56, C57, C58, C59, C60: 10nF; C_1206_3216Metric; not fitted
D8, D9, D10, D11, D12, D13, D14, D15, D16, D17, D18, D19, D20: BAT54; D_SOD-123
F2, F3, F4, F5: 1206L050/24; Fuse_1206_3216Metric
J3: FL pigtail -> SS1.0 key A / black; SolderWire-0.5sqmm_1x04_P4.6mm_D0.9mm_OD2.1mm_Relief
J4: FR pigtail -> SS1.0 key B / grey; SolderWire-0.5sqmm_1x04_P4.6mm_D0.9mm_OD2.1mm_Relief
J5: RL pigtail -> SS1.0 key C / brown; SolderWire-0.5sqmm_1x04_P4.6mm_D0.9mm_OD2.1mm_Relief
J6: RR pigtail -> SS1.0 key D / natural; SolderWire-0.5sqmm_1x04_P4.6mm_D0.9mm_OD2.1mm_Relief
J7: DENALI pigtail -> SS1.5 3w; SolderWire-1.5sqmm_1x03_P6mm_D1.7mm_OD3mm_Relief
J8: CAN pigtail -> SS1.0 2w; SolderWire-0.5sqmm_1x02_P4.6mm_D0.9mm_OD2.1mm_Relief
Q4A, Q4B, Q5A, Q5B, Q6A, Q6B, Q7A, Q7B, Q8A, Q8B, Q9A, Q9B: NX5020UNBKS; SOT-363_SC-70-6
R40, R41, R42, R43, R44, R45, R46, R47, R48, R49, R50, R51, R64, R65, R66, R67, R68, R69, R70, R71, R72, R73, R74, R75, R78, R86, R87: 10k; R_0603_1608Metric
R52, R53, R54, R55, R56, R57, R58, R59, R60, R61, R62, R63: 10R; R_1206_3216Metric
R76, R77, R79, R80, R82, R83, R84, R85: 4.7k; R_0603_1608Metric
R81: 2.2k; R_0603_1608Metric
R88, R89, R90, R91, R92, R93, R94, R95, R96, R97, R98, R99: 100R; R_1206_3216Metric; not fitted
U7: PCA9685PW/Q900; TSSOP-28_4.4x9.7mm_P0.65mm
U8: ADG706; TSSOP-28_4.4x9.7mm_P0.65mm
U9: BTS7008-2EPA; Infineon_PG-TSDSO-14-22

Connections:
/+3V3_ALW: D20.1 (K); also elsewhere on the board
/+3V3_SW: C41.1, C42.1, C43.1, D8.1 (K), D9.1 (K), D10.1 (K), D11.1 (K), D12.1 (K), D13.1 (K), D14.1 (K), D15.1 (K), D16.1 (K), D17.1 (K), D18.1 (K), D19.1 (K), R76.2, R77.2, U7.28 (VDD), U8.1 (VDD), U8.18 (EN); also elsewhere on the board
/+24V: F2.1, F3.1, F4.1, F5.1; also elsewhere on the board
/CANH: J8.1; also elsewhere on the board
/CANL: J8.2; also elsewhere on the board
/DEN_DSEL: R85.1; also elsewhere on the board
/EN_DIAG: R84.1; also elsewhere on the board
/I2C_SCL: R77.1, U7.26 (SCL); also elsewhere on the board
/I2C_SDA: R76.1, U7.27 (SDA); also elsewhere on the board
/ISNS_DEN: C48.1, D20.2 (A), R83.2; also elsewhere on the board
/MUX_S0: U8.17 (A0); also elsewhere on the board
/MUX_S1: U8.16 (A1); also elsewhere on the board
/MUX_S2: U8.15 (A2); also elsewhere on the board
/MUX_S3: U8.14 (A3); also elsewhere on the board
/PWM_DEN_A: R79.1, R86.1; also elsewhere on the board
/PWM_DEN_B: R80.1, R87.1; also elsewhere on the board
/RGB_ISNS: C44.1, U8.28 (D); also elsewhere on the board
/VBAT: C45.1, C46.1, U9.15 (VS); also elsewhere on the board
/outputs/+24V_FL: F2.2, J3.1
/outputs/+24V_FR: F3.2, J4.1
/outputs/+24V_RL: F4.2, J5.1
/outputs/+24V_RR: F5.2, J6.1
/outputs/DEN_A_OUT: J7.1, U9.12 (OUT0), U9.13 (OUT0), U9.14 (OUT0)
/outputs/DEN_B_OUT: J7.2, U9.8 (OUT1), U9.9 (OUT1), U9.10 (OUT1)
/outputs/MUXIN_FL_B: D10.2 (A), R66.2, U8.21 (S3)
/outputs/MUXIN_FL_G: D9.2 (A), R65.2, U8.20 (S2)
/outputs/MUXIN_FL_R: D8.2 (A), R64.2, U8.19 (S1)
/outputs/MUXIN_FR_B: D13.2 (A), R69.2, U8.24 (S6)
/outputs/MUXIN_FR_G: D12.2 (A), R68.2, U8.23 (S5)
/outputs/MUXIN_FR_R: D11.2 (A), R67.2, U8.22 (S4)
/outputs/MUXIN_RL_B: D16.2 (A), R72.2, U8.11 (S9)
/outputs/MUXIN_RL_G: D15.2 (A), R71.2, U8.26 (S8)
/outputs/MUXIN_RL_R: D14.2 (A), R70.2, U8.25 (S7)
/outputs/MUXIN_RR_B: D19.2 (A), R75.2, U8.8 (S12)
/outputs/MUXIN_RR_G: D18.2 (A), R74.2, U8.9 (S11)
/outputs/MUXIN_RR_R: D17.2 (A), R73.2, U8.10 (S10)
/outputs/PWM_FL_B: R42.1, U7.8 (LED2); also elsewhere on the board
/outputs/PWM_FL_G: R41.1, U7.7 (LED1); also elsewhere on the board
/outputs/PWM_FL_R: R40.1, U7.6 (LED0); also elsewhere on the board
/outputs/PWM_FR_B: R45.1, U7.11 (LED5); also elsewhere on the board
/outputs/PWM_FR_G: R44.1, U7.10 (LED4); also elsewhere on the board
/outputs/PWM_FR_R: R43.1, U7.9 (LED3); also elsewhere on the board
/outputs/PWM_RL_B: R48.1, U7.15 (LED8); also elsewhere on the board
/outputs/PWM_RL_G: R47.1, U7.13 (LED7); also elsewhere on the board
/outputs/PWM_RL_R: R46.1, U7.12 (LED6); also elsewhere on the board
/outputs/PWM_RR_B: R51.1, U7.18 (LED11); also elsewhere on the board
/outputs/PWM_RR_G: R50.1, U7.17 (LED10); also elsewhere on the board
/outputs/PWM_RR_R: R49.1, U7.16 (LED9); also elsewhere on the board
/outputs/RET_FL_R: J3.2, R88.1; also elsewhere on the board
/outputs/SENSE_FL_B: R54.1, R66.1; also elsewhere on the board
/outputs/SENSE_FL_G: R53.1, R65.1; also elsewhere on the board
/outputs/SENSE_FL_R: R52.1, R64.1; also elsewhere on the board
/outputs/SENSE_FR_B: R57.1, R69.1; also elsewhere on the board
/outputs/SENSE_FR_G: R56.1, R68.1; also elsewhere on the board
/outputs/SENSE_FR_R: R55.1, R67.1; also elsewhere on the board
/outputs/SENSE_RL_B: R60.1, R72.1; also elsewhere on the board
/outputs/SENSE_RL_G: R59.1, R71.1; also elsewhere on the board
/outputs/SENSE_RL_R: R58.1, R70.1; also elsewhere on the board
/outputs/SENSE_RR_B: R63.1, R75.1; also elsewhere on the board
/outputs/SENSE_RR_G: R62.1, R74.1; also elsewhere on the board
/outputs/SENSE_RR_R: R61.1, R73.1; also elsewhere on the board
unnamed: C47.1, R81.1, R82.2, R83.1
unnamed: C49.1, R88.2
unnamed: C50.1, R89.2
unnamed: C51.1, R90.2
unnamed: C52.1, R91.2
unnamed: C53.1, R92.2
unnamed: C54.1, R93.2
unnamed: C55.1, R94.2
unnamed: C56.1, R95.2
unnamed: C57.1, R96.2
unnamed: C58.1, R97.2
unnamed: C59.1, R98.2
unnamed: C60.1, R99.2
unnamed: R78.1, U7.23 (~OE)
unnamed: R84.2, U9.3 (DEN)
unnamed: R85.2, U9.5 (DSEL)
unnamed: R79.2, U9.2 (IN0)
unnamed: R80.2, U9.6 (IN1)
unnamed: R82.1, U9.4 (IS)

Notes on the sheet:
PROFET U9 -- PINOUT VERIFIED, Infineon BTS7008-2EPA Rev. 1.21 Table 2 (2024-07-29) EP/15 VS (exposed pad, the ONLY supply pin) 1 GND 2 IN0 3 DEN 4 IS 5 DSEL 6 IN1 7, 11 n.c. (internally not bonded) 8-10 OUT1 12-14 OUT0 Table 2 note 1: "All output pins of the channel must be connected together on th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
PTCs (F2-F5), one per string Isolates a shorted string so one crushed cable cannot extinguish all four corners (spec 5.2). Littelfuse 1206L050/24: Ihold 0.50 A at 23 C, 0.31 A at 65 C, against an 80 mA per-string load. That is a 3.9x margin at the hot internal temperature, which is the case that ma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
PROFET SENSE CHAIN -- HOW R81 WAS SIZED kILIS = 5400 (Table 22, at IL14 = 2.8 A, +/-5.8%; 5450 at 5.5 A). At the Denali's 3.3 A per channel (spec 2.2) the IS pin therefore sources IL / kILIS = 611 uA. R81 = 2.2 kOhm puts that at 1.34 V, comfortably mid-scale for ADC1 at 11 dB attenuation (useful ra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
CORNER MIS-MATING -- STILL A SAFETY ITEM, BUT ONE MATING POINT FEWER (spec 9.2) J3-J6 are NOT connectors. They are soldered 4-wire tails that leave the box through cable glands; the Superseal 1.0 4-way joints sit out on the harness. TE Superseal is a wire-to-wire series with no panel-mount board-si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
SENSE-PATH PROTECTION (I15) Each sense node reaches its mux input through 10 kOhm (R64-R75) with a clamp to +3V3_SW. The SERIES RESISTOR is what actually bounds a fault: at 24 V on a sense node it admits 2 mA, far inside the ADG706's input rating. The clamps (D9-D20) are redundancy. C44, 10 nF at t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
ACCEPTANCE (spec 5, 9.1, 9.2) - PCA9685 on +3V3_SW, I2C, LED0-11 -> the 12 RGB switch inputs IN ChannelIndex ORDER: LED0,1,2 = FL R,G,B; LED3,4,5 = FR R,G,B; LED6,7,8 = RL R,G,B; LED9,10,11 = RR R,G,B. LED12-15 UNUSED. - 12x discrete logic-level N-MOSFET, gate direct from PCA9685, sense shunt in ea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
SENSE CHAIN (spec 5.1) -- VALUES REVISED, THE PLAN TEXT IS STALE 10 ohm x 26.7 mA = 267 mV at full channel current (133 mV if the 6 cm strip length is used). ADC1 at 0 dB attenuation (0-1.1 V range). Classification is open (~0 mV) / working (~267 mV) / shorted (saturated) -- NOT precision current m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
SHUNT RATING DEPENDS ON A FIRMWARE BEHAVIOUR -- READ THIS BEFORE CHANGING EITHER Normal dissipation in a 10 ohm shunt is 26.7 mA^2 x 10 = 7 mW, so an 0805 or 1206 is ample. A SHORTED channel is different. The boost then current-limits at roughly 0.5 A, which puts about 2.5 W into that one shunt -- 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
WHY ~OE IS PULLED LOW (R78) RATHER THAN HIGH The plan says "OE tied so outputs are disabled by default". Taken literally that means pulling ~OE HIGH -- but no GPIO is allocated to release it, so the board would be permanently dark. "Disabled by default" is already delivered twice over without this 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
PROFET CONTROL LINES -- WHY THE PULLDOWNS ARE ON THE MCU SIDE R79/R80/R84/R85 are the datasheet's RIN, RDEN and RDSEL (Table 24, 4.7 kOhm): they protect the MCU during overvoltage and reverse polarity, and they are what allows the outputs to switch OFF if the module loses its ground. All four input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
PROFET -- WHAT IS DELIBERATELY NOT FITTED No RPD (47 kOhm output pulldown), ROL or T1. Those exist only for OFF-state open-load diagnosis, which spec 5.3 does not ask for; ON-state sense through IS covers what this design needs. RPD would also draw ~290 uA per channel whenever the output is on.

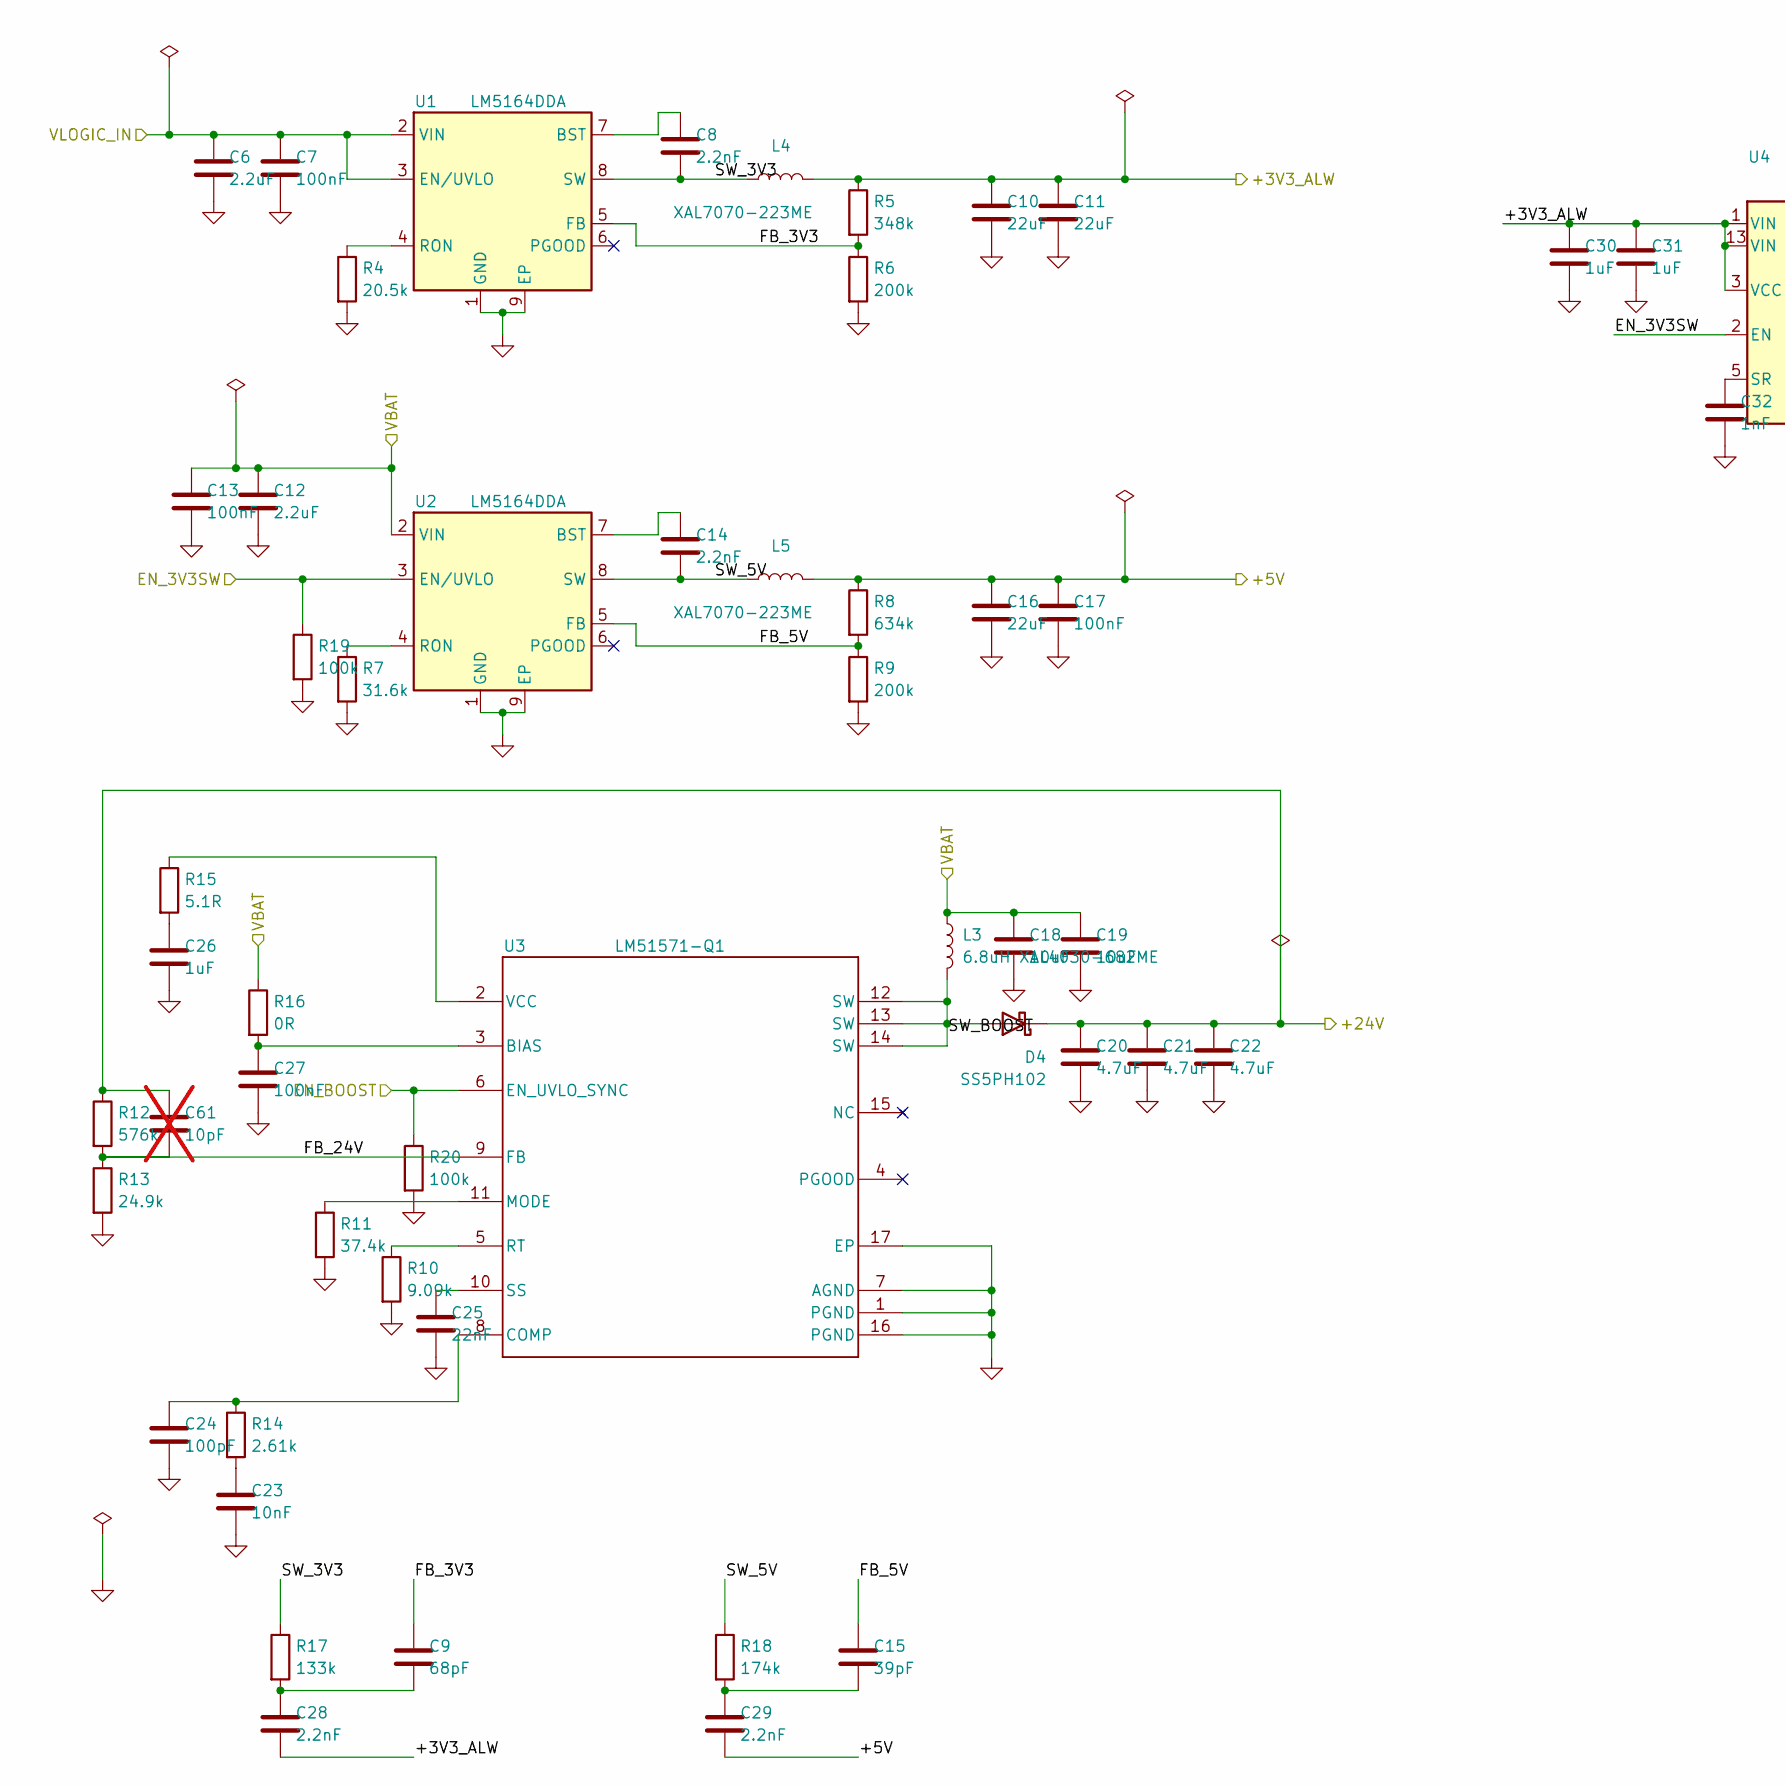
[picture p15: schematic rails.kicad_sch, part in row 1, column 1]

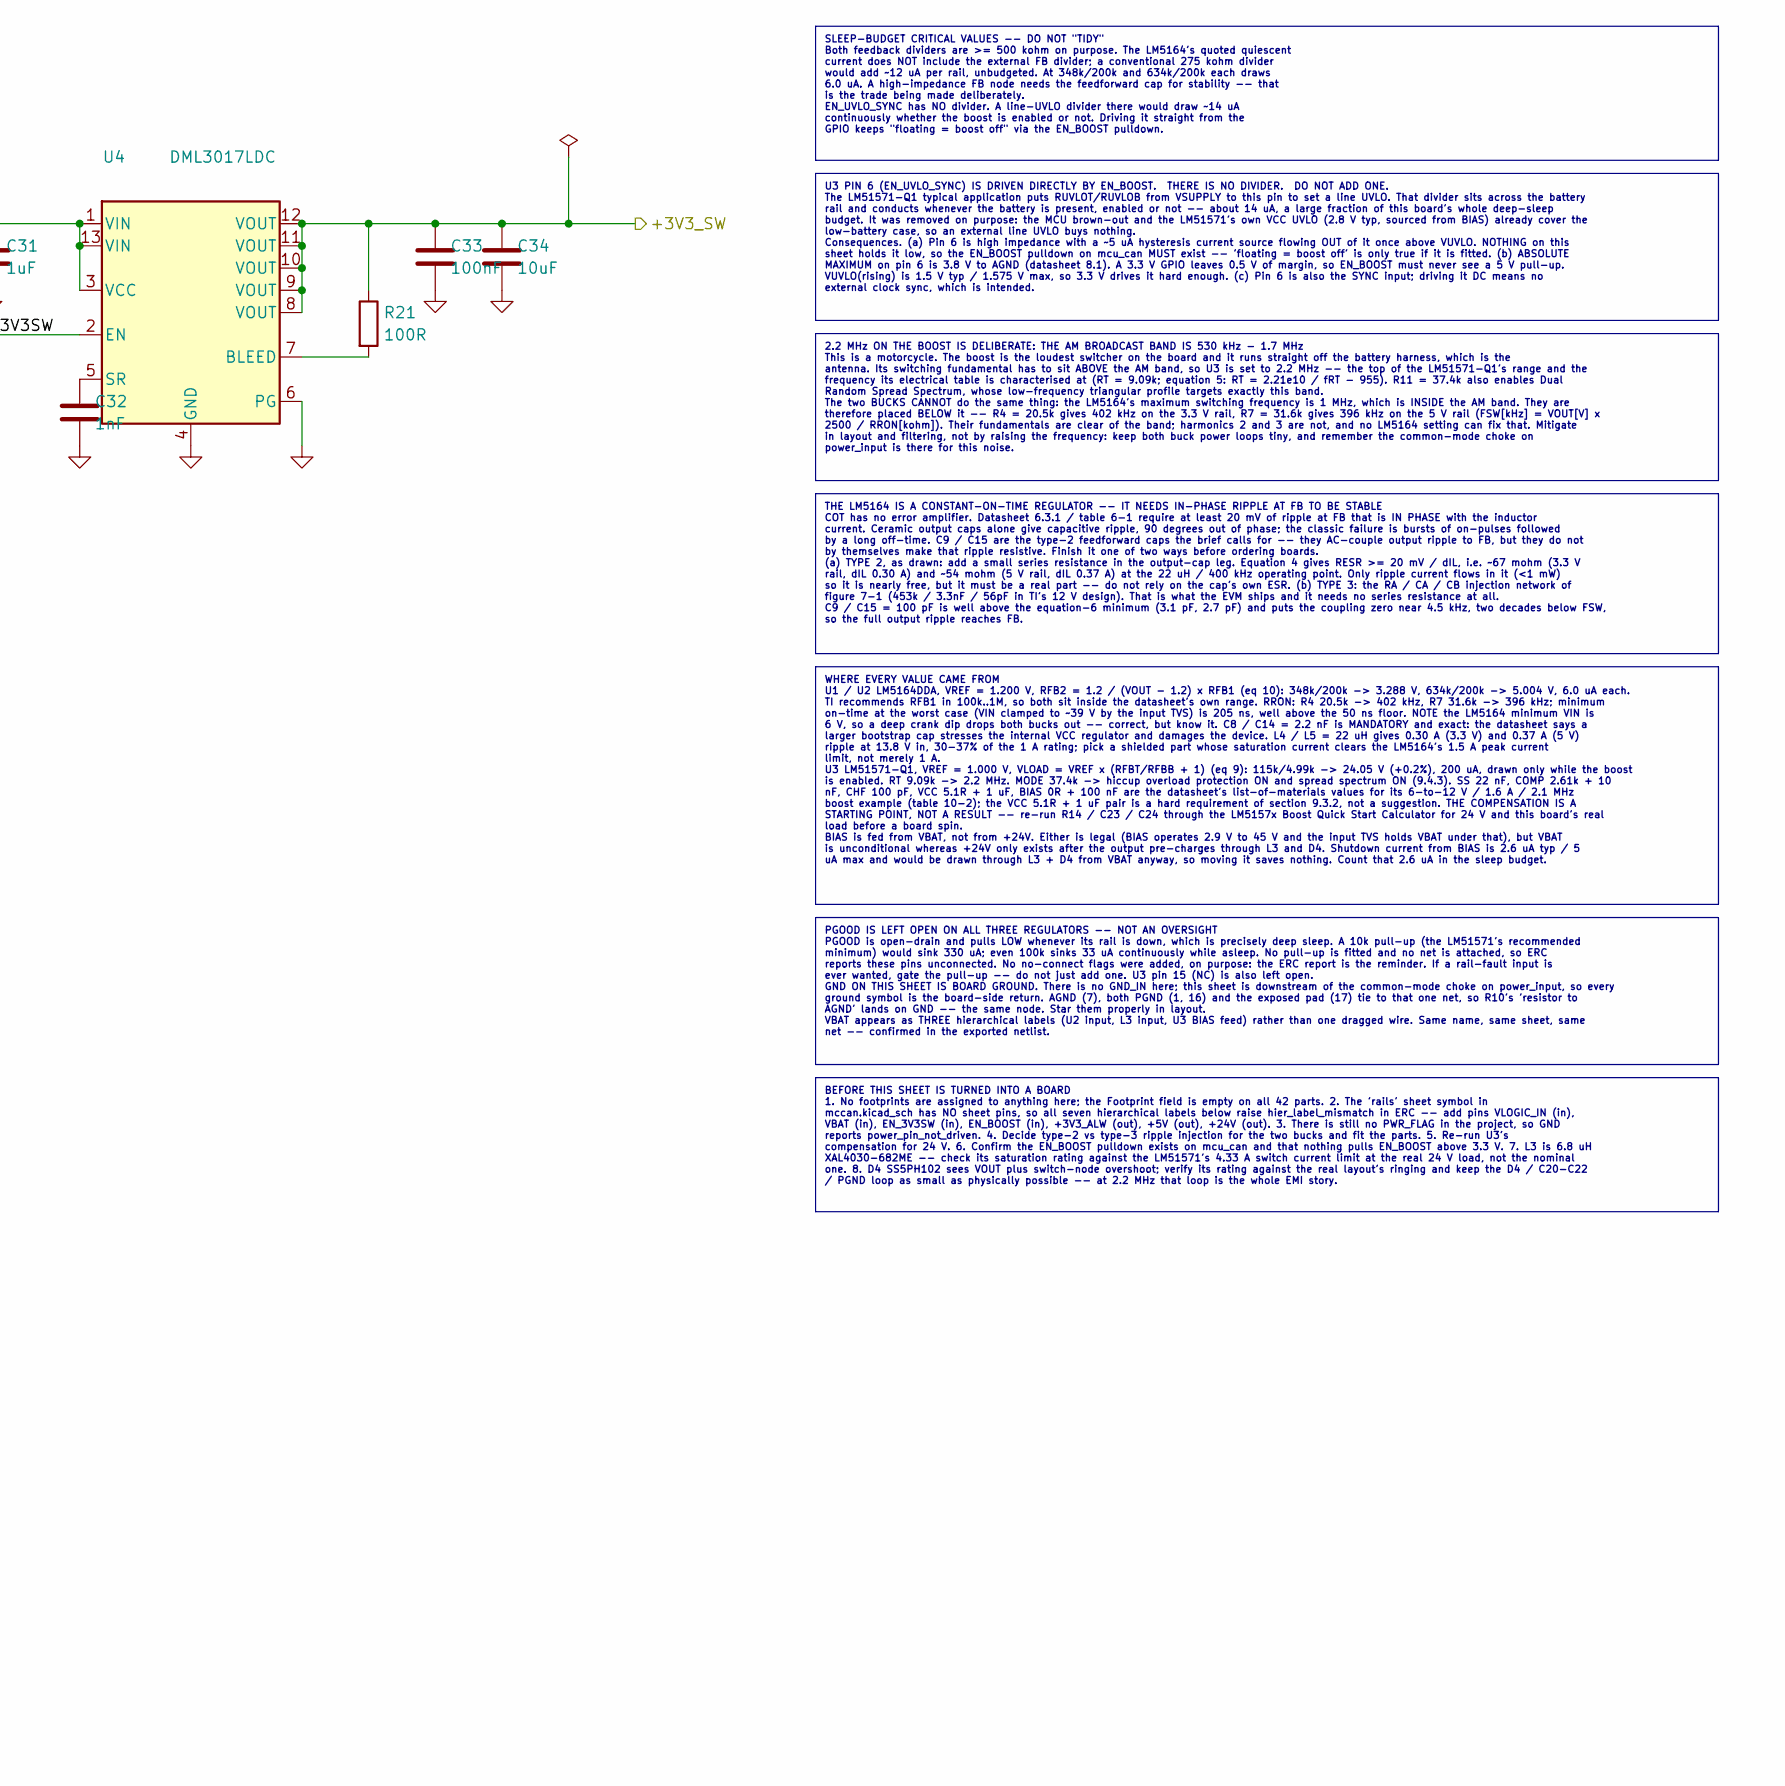
[picture p16: schematic rails.kicad_sch, part in row 1, column 2]

Parts:
C6, C12: 2.2uF; C_1206_3216Metric
C7, C13: 100nF; C_0805_2012Metric
C8, C14, C28, C29: 2.2nF; C_0603_1608Metric
C9: 68pF; C_0603_1608Metric
C10, C11, C16: 22uF; C_0603_1608Metric
C15: 39pF; C_0603_1608Metric
C17, C27, C33: 100nF; C_0603_1608Metric
C18, C19: 10uF; C_1210_3225Metric
C20, C21, C22: 4.7uF; C_1206_3216Metric
C23: 10nF; C_0603_1608Metric
C24: 100pF; C_0603_1608Metric
C25: 22nF; C_0603_1608Metric
C26, C30, C31: 1uF; C_0603_1608Metric
C32: 1nF; C_0603_1608Metric
C34: 10uF; C_0603_1608Metric
C61: 10pF; C_0603_1608Metric; not fitted
D4: SS5PH102; TO-277A
L3: 6.8uH XAL4030-682ME; L_Coilcraft_XAL4030-XXX
L4, L5: XAL7070-223ME; L_Coilcraft_XAL7070-XXX
R4: 20.5k; R_0603_1608Metric
R5: 348k; R_0603_1608Metric
R6, R9: 200k; R_0603_1608Metric
R7: 31.6k; R_0603_1608Metric
R8: 634k; R_0603_1608Metric
R10: 9.09k; R_0603_1608Metric
R11: 37.4k; R_0603_1608Metric
R12: 576k; R_0603_1608Metric
R13: 24.9k; R_0603_1608Metric
R14: 2.61k; R_0603_1608Metric
R15: 5.1R; R_0603_1608Metric
R16: 0R; R_0603_1608Metric
R17: 133k; R_0603_1608Metric
R18: 174k; R_0603_1608Metric
R19, R20: 100k; R_0603_1608Metric
R21: 100R; R_0603_1608Metric
U1, U2: LM5164DDA; SOIC-8-1EP_3.9x4.9mm_P1.27mm_EP2.62x3.51mm
U3: LM51571-Q1; QFN-16-1EP_3x3mm_P0.5mm_EP1.675x1.675mm
U4: DML3017LDC; DFN-12-1EP_3x3mm_P0.5mm_EP2.05x2.86mm

Connections:
/+3V3_ALW: C10.1, C11.1, C28.2, C30.1, C31.1, L4.2, R5.1, U4.1 (VIN), U4.3 (VCC), U4.13 (VIN); also elsewhere on the board
/+3V3_SW: C33.1, C34.1, R21.1, U4.8 (VOUT), U4.9 (VOUT), U4.10 (VOUT), U4.11 (VOUT), U4.12 (VOUT); also elsewhere on the board
/+5V: C16.1, C17.1, C29.2, L5.2, R8.1; also elsewhere on the board
/+24V: C20.1, C21.1, C22.1, C61.1, D4.1 (K), D4.3 (K), R12.1; also elsewhere on the board
/EN_3V3SW: R19.1, U2.3 (EN/UVLO), U4.2 (EN); also elsewhere on the board
/EN_BOOST: R20.1, U3.6 (EN_UVLO_SYNC); also elsewhere on the board
/VBAT: C12.1, C13.1, C18.1, C19.1, L3.1, R16.1, U2.2 (VIN); also elsewhere on the board
/VLOGIC_IN: C6.1, C7.1, U1.2 (VIN), U1.3 (EN/UVLO); also elsewhere on the board
/rails/FB_3V3: C9.1, R5.2, R6.1, U1.5 (FB)
/rails/FB_5V: C15.1, R8.2, R9.1, U2.5 (FB)
/rails/FB_24V: C61.2, R12.2, R13.1, U3.9 (FB)
/rails/SW_3V3: C8.2, L4.1, R17.1, U1.8 (SW)
/rails/SW_5V: C14.2, L5.1, R18.1, U2.8 (SW)
/rails/SW_BOOST: D4.2 (A), L3.2, U3.12 (SW), U3.13 (SW), U3.14 (SW)
unnamed: C15.2, C29.1, R18.2
unnamed: C23.1, R14.2
unnamed: C26.1, R15.2
unnamed: C9.2, C28.1, R17.2
unnamed: C8.1, U1.7 (BST)
unnamed: R4.1, U1.4 (RON)
unnamed: C14.1, U2.7 (BST)
unnamed: R7.1, U2.4 (RON)
unnamed: C27.1, R16.2, U3.3 (BIAS)
unnamed: C24.1, R14.1, U3.8 (COMP)
unnamed: R10.1, U3.5 (RT)
unnamed: C25.1, U3.10 (SS)
unnamed: R15.1, U3.2 (VCC)
unnamed: R21.2, U4.7 (BLEED)
unnamed: C32.1, U4.5 (SR)

Notes on the sheet:
PGOOD IS LEFT OPEN ON ALL THREE REGULATORS -- NOT AN OVERSIGHT PGOOD is open-drain and pulls LOW whenever its rail is down, which is precisely deep sleep. A 10k pull-up (the LM51571's recommended minimum) would sink 330 uA; even 100k sinks 33 uA continuously while asleep. No pull-up is fitted and n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
2.2 MHz ON THE BOOST IS DELIBERATE: THE AM BROADCAST BAND IS 530 kHz - 1.7 MHz This is a motorcycle. The boost is the loudest switcher on the board and it runs straight off the battery harness, which is the antenna. Its switching fundamental has to sit ABOVE the AM band, so U3 is set to 2.2 MHz -- 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
BEFORE THIS SHEET IS TURNED INTO A BOARD 1. No footprints are assigned to anything here; the Footprint field is empty on all 42 parts. 2. The 'rails' sheet symbol in mccan.kicad_sch has NO sheet pins, so all seven hierarchical labels below raise hier_label_mismatch in ERC -- add pins VLOGIC_IN (in)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
WHERE EVERY VALUE CAME FROM U1 / U2 LM5164DDA, VREF = 1.200 V, RFB2 = 1.2 / (VOUT - 1.2) x RFB1 (eq 10): 348k/200k -> 3.288 V, 634k/200k -> 5.004 V, 6.0 uA each. TI recommends RFB1 in 100k..1M, so both sit inside the datasheet's own range. RRON: R4 20.5k -> 402 kHz, R7 31.6k -> 396 kHz; minimum on-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
THE LM5164 IS A CONSTANT-ON-TIME REGULATOR -- IT NEEDS IN-PHASE RIPPLE AT FB TO BE STABLE COT has no error amplifier. Datasheet 6.3.1 / table 6-1 require at least 20 mV of ripple at FB that is IN PHASE with the inductor current. Ceramic output caps alone give capacitive ripple, 90 degrees out of ph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
SLEEP-BUDGET CRITICAL VALUES -- DO NOT "TIDY" Both feedback dividers are >= 500 kohm on purpose. The LM5164's quoted quiescent current does NOT include the external FB divider; a conventional 275 kohm divider would add ~12 uA per rail, unbudgeted. At 348k/200k and 634k/200k each draws 6.0 uA. A hig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
U3 PIN 6 (EN_UVLO_SYNC) IS DRIVEN DIRECTLY BY EN_BOOST. THERE IS NO DIVIDER. DO NOT ADD ONE. The LM51571-Q1 typical application puts RUVLOT/RUVLOB from VSUPPLY to this pin to set a line UVLO. That divider sits across the battery rail and conducts whenever the battery is present, enabled or not -- a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
