JimboMcRackem/ESP32MCCAN/hardware/mccan.kicad_pcb

## KiCad design hardware/mccan.kicad_pcb (continued)

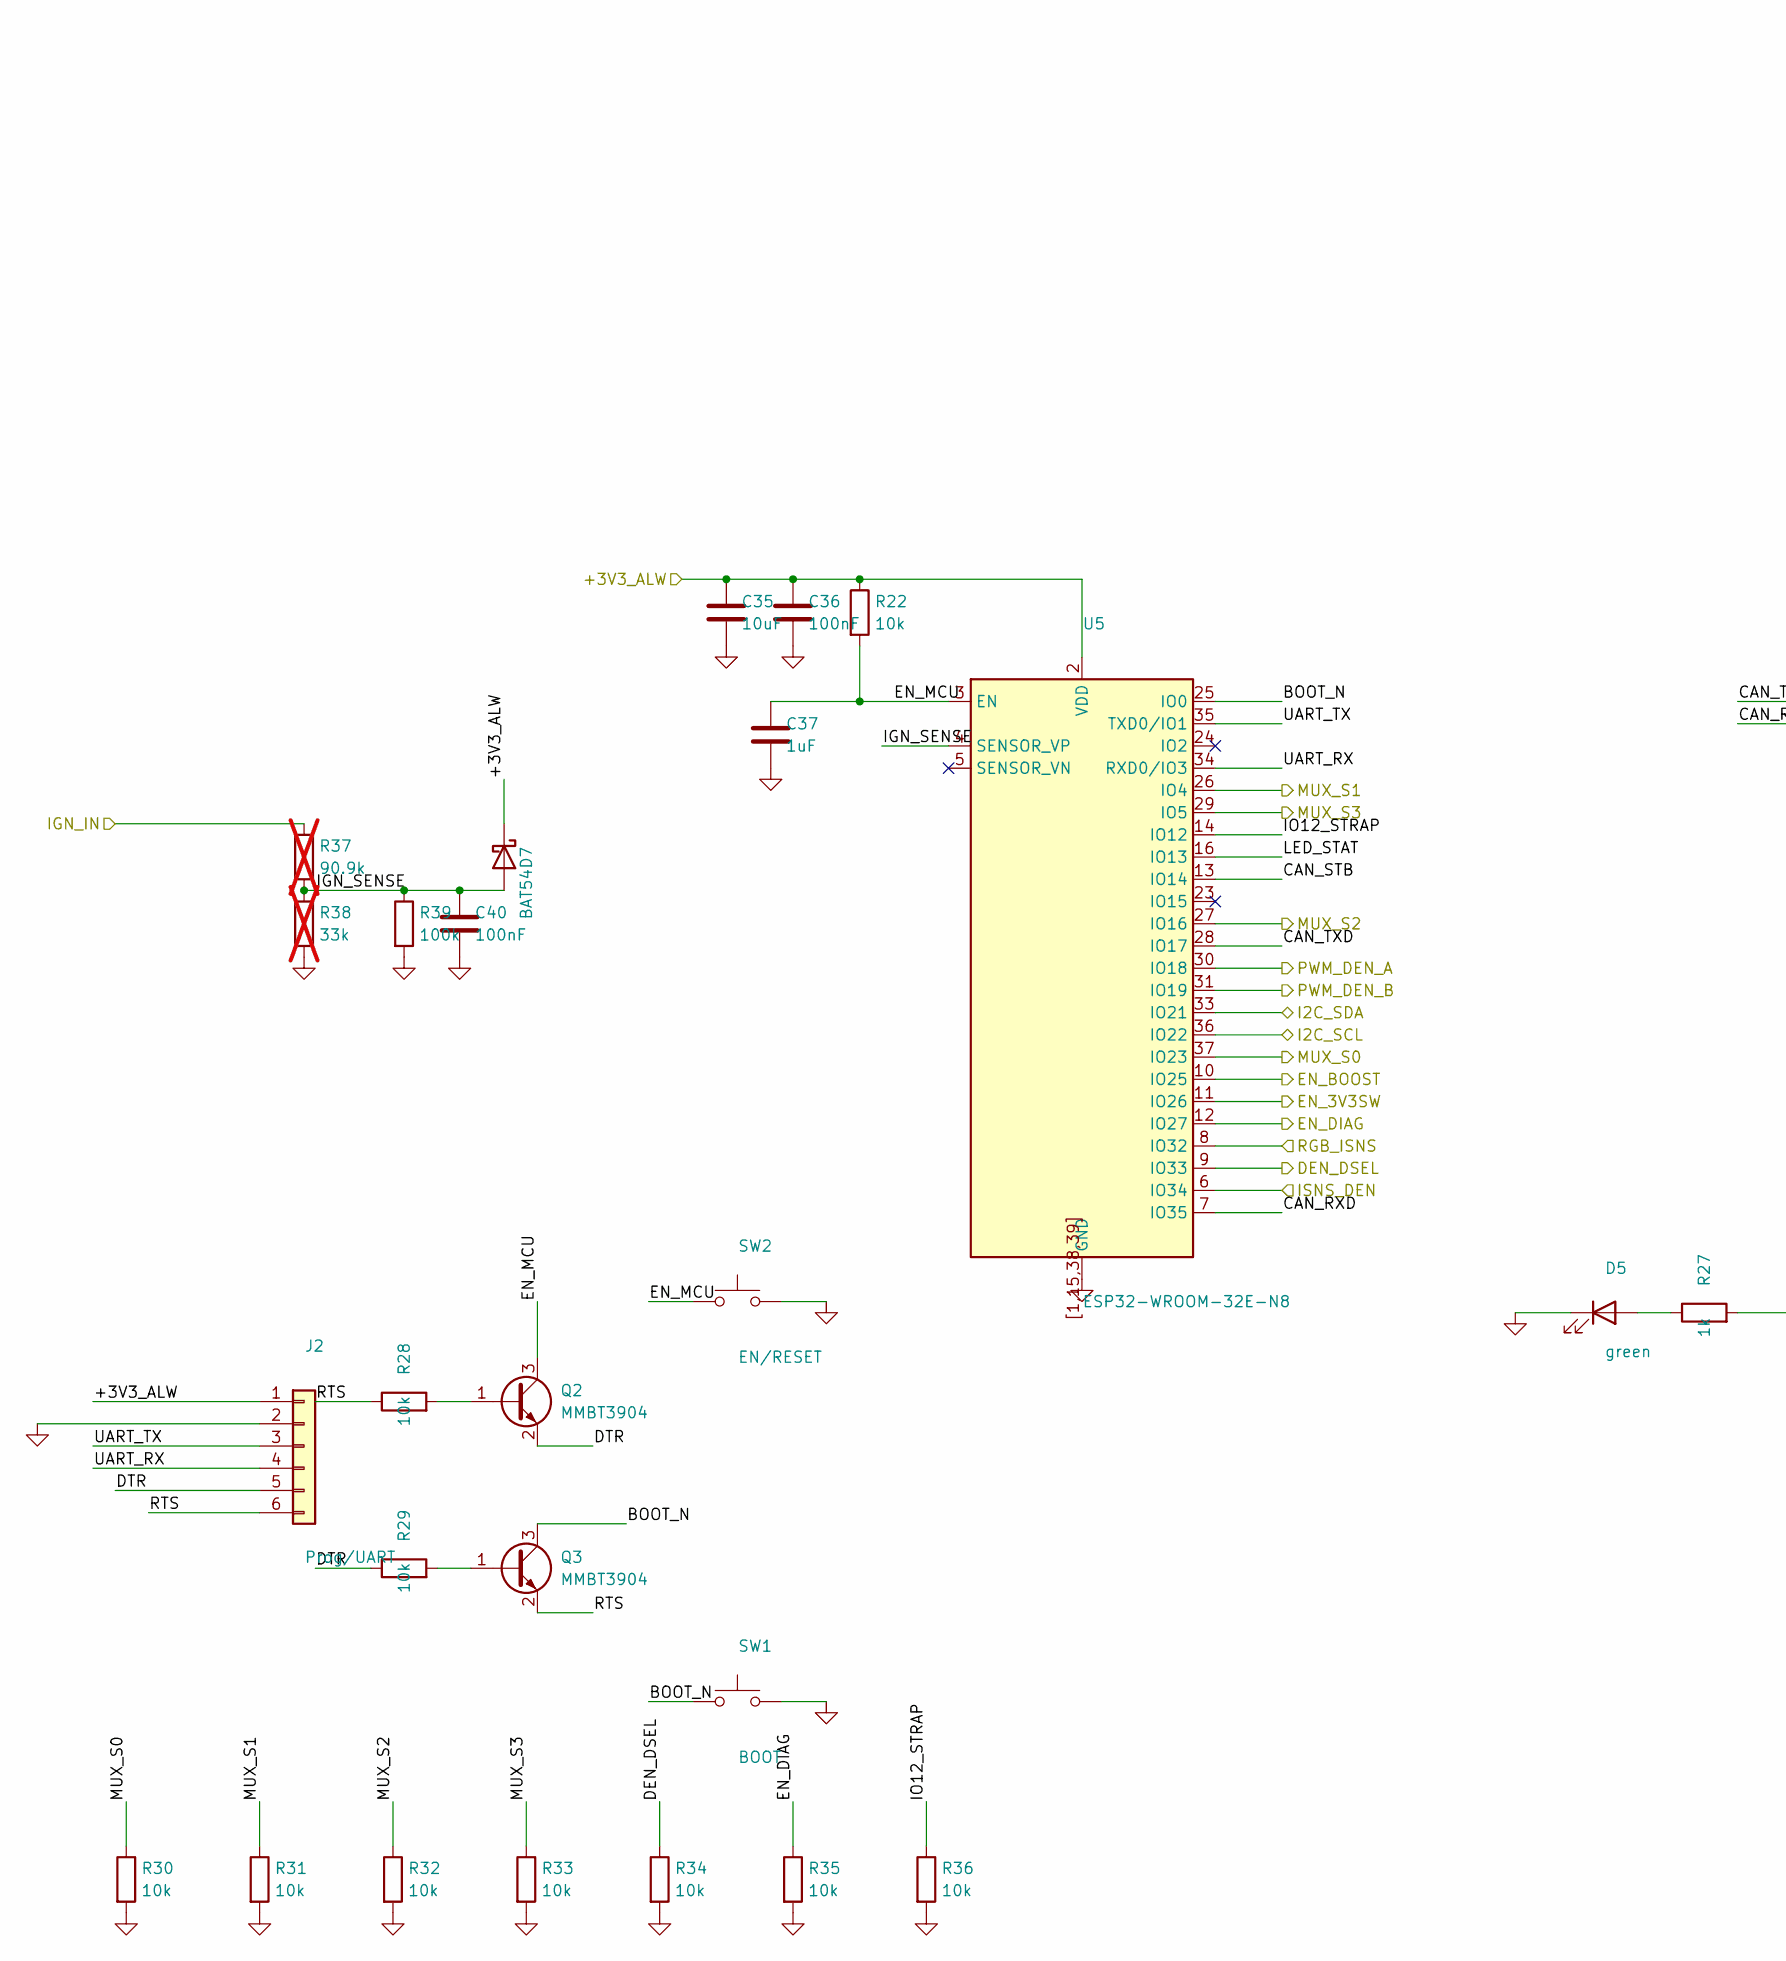
[picture p17: schematic mcu_can.kicad_sch, part in row 1, column 1]

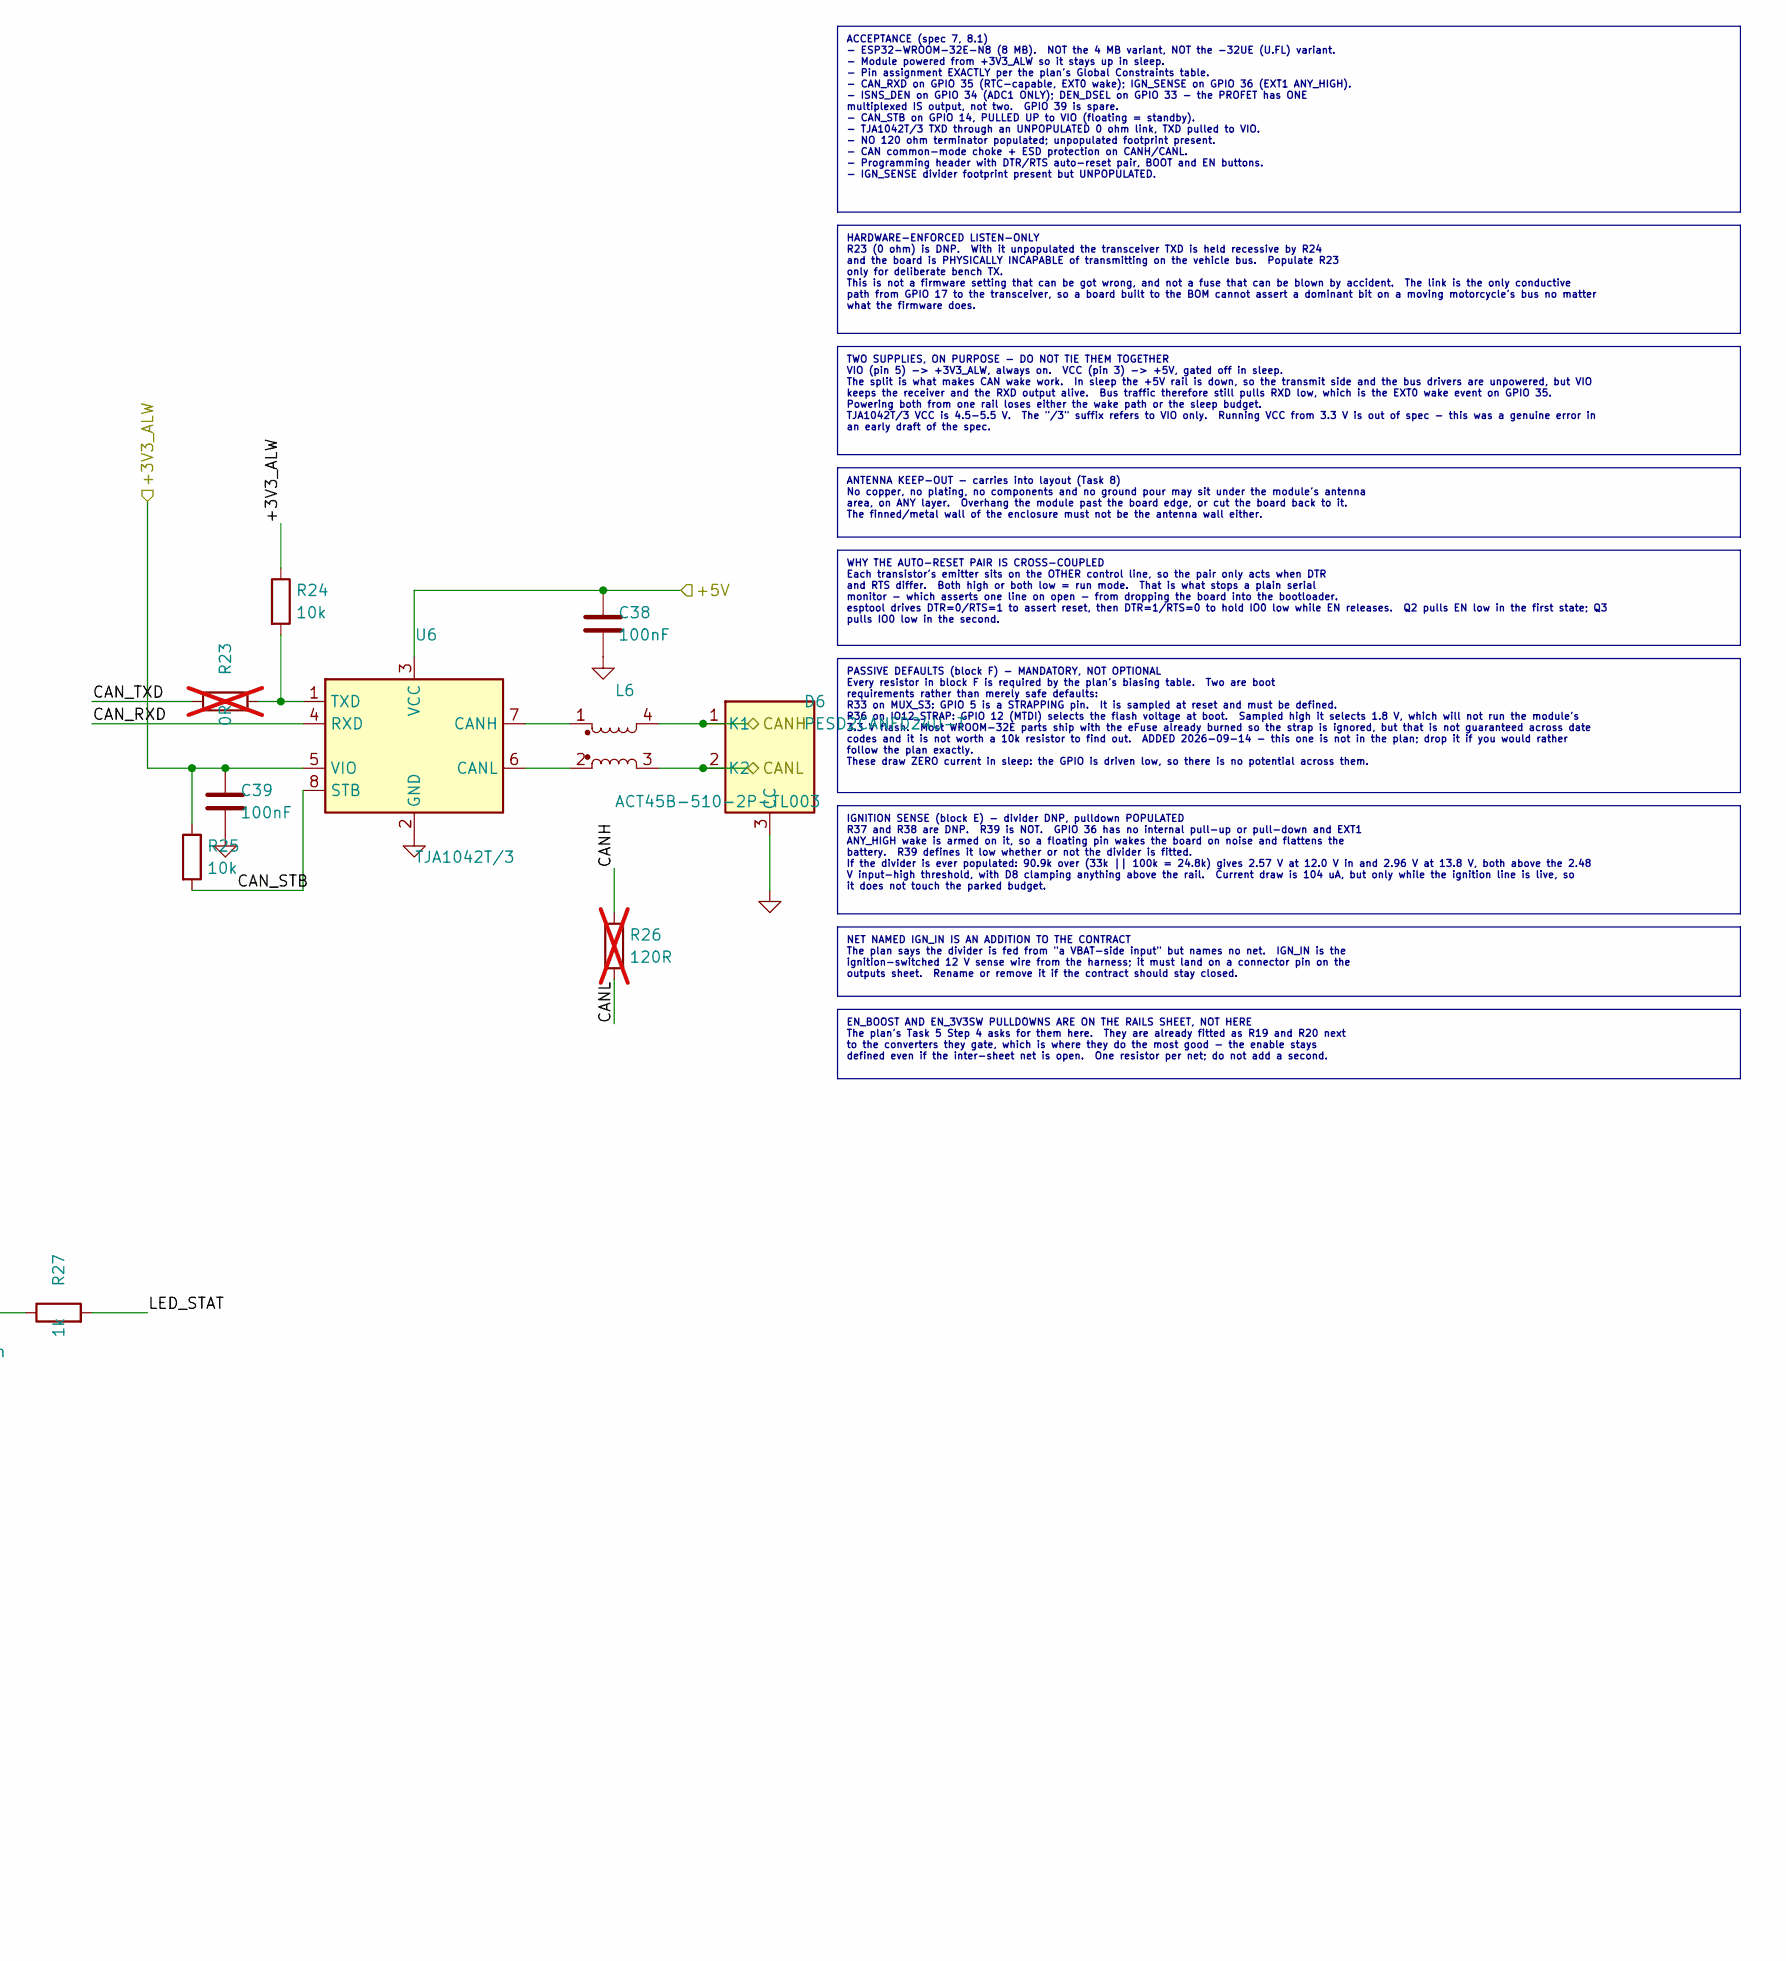
[picture p18: schematic mcu_can.kicad_sch, part in row 1, column 2]

Parts:
C35: 10uF; C_0603_1608Metric
C36, C38, C39, C40: 100nF; C_0603_1608Metric
C37: 1uF; C_0603_1608Metric
D5: green; LED_0603_1608Metric
D6: PESD2CANFD24U-T; SOT-23
D7: BAT54; D_SOD-123
J2: Prog/UART; PinHeader_1x06_P2.54mm_Vertical
L6: ACT45B-510-2P-TL003; TDK_ACT45B
Q2, Q3: MMBT3904; SOT-23
R22, R24, R25, R28, R29, R30, R31, R32, R33, R34, R35, R36: 10k; R_0603_1608Metric
R23: 0R; R_0603_1608Metric; not fitted
R26: 120R; R_0603_1608Metric; not fitted
R27: 1k; R_0603_1608Metric
R37: 90.9k; R_0603_1608Metric; not fitted
R38: 33k; R_0603_1608Metric; not fitted
R39: 100k; R_0603_1608Metric
SW1: BOOT; Panasonic_EVQPUJ_EVQPUA
SW2: EN/RESET; Panasonic_EVQPUJ_EVQPUA
U5: ESP32-WROOM-32E-N8; ESP32-WROOM-32E
U6: TJA1042T/3; SOIC-8_3.9x4.9mm_P1.27mm

Connections:
/+3V3_ALW: C35.1, C36.1, C39.1, D7.1 (K), J2.1, R22.1, R24.1, R25.1, U5.2 (VDD), U6.5 (VIO); also elsewhere on the board
/+5V: C38.1, U6.3 (VCC); also elsewhere on the board
/CANH: D6.1 (K1), L6.4, R26.1; also elsewhere on the board
/CANL: D6.2 (K2), L6.3, R26.2; also elsewhere on the board
/DEN_DSEL: R34.1, U5.9 (IO33); also elsewhere on the board
/EN_3V3SW: U5.11 (IO26); also elsewhere on the board
/EN_BOOST: U5.10 (IO25); also elsewhere on the board
/EN_DIAG: R35.1, U5.12 (IO27); also elsewhere on the board
/I2C_SCL: U5.36 (IO22); also elsewhere on the board
/I2C_SDA: U5.33 (IO21); also elsewhere on the board
/IGN_IN: R37.1; also elsewhere on the board
/ISNS_DEN: U5.6 (IO34); also elsewhere on the board
/MUX_S0: R30.1, U5.37 (IO23); also elsewhere on the board
/MUX_S1: R31.1, U5.26 (IO4); also elsewhere on the board
/MUX_S2: R32.1, U5.27 (IO16); also elsewhere on the board
/MUX_S3: R33.1, U5.29 (IO5); also elsewhere on the board
/PWM_DEN_A: U5.30 (IO18); also elsewhere on the board
/PWM_DEN_B: U5.31 (IO19); also elsewhere on the board
/RGB_ISNS: U5.8 (IO32); also elsewhere on the board
/mcu_can/BOOT_N: Q3.3 (C), SW1.1, U5.25 (IO0)
/mcu_can/CAN_RXD: U5.7 (IO35), U6.4 (RXD)
/mcu_can/CAN_STB: R25.2, U5.13 (IO14), U6.8 (STB)
/mcu_can/CAN_TXD: R23.1, U5.28 (IO17)
/mcu_can/DTR: J2.5, Q2.2 (E), R29.1
/mcu_can/EN_MCU: C37.1, Q2.3 (C), R22.2, SW2.1, U5.3 (EN)
/mcu_can/IGN_SENSE: C40.1, D7.2 (A), R37.2, R38.1, R39.1, U5.4 (SENSOR_VP)
/mcu_can/IO12_STRAP: R36.1, U5.14 (IO12)
/mcu_can/LED_STAT: R27.2, U5.16 (IO13)
/mcu_can/RTS: J2.6, Q3.2 (E), R28.1
/mcu_can/UART_RX: J2.4, U5.34 (RXD0/IO3)
/mcu_can/UART_TX: J2.3, U5.35 (TXD0/IO1)
unnamed: D5.2 (A), R27.1
unnamed: Q2.1 (B), R28.2
unnamed: Q3.1 (B), R29.2
unnamed: L6.1, U6.7 (CANH)
unnamed: L6.2, U6.6 (CANL)
unnamed: R23.2, R24.2, U6.1 (TXD)

Notes on the sheet:
PASSIVE DEFAULTS (block F) - MANDATORY, NOT OPTIONAL Every resistor in block F is required by the plan's biasing table. Two are boot requirements rather than merely safe defaults: R33 on MUX_S3: GPIO 5 is a STRAPPING pin. It is sampled at reset and must be defined. R36 on IO12_STRAP: GPIO 12 (MTDI)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
NET NAMED IGN_IN IS AN ADDITION TO THE CONTRACT The plan says the divider is fed from "a VBAT-side input" but names no net. IGN_IN is the ignition-switched 12 V sense wire from the harness; it must land on a connector pin on the outputs sheet. Rename or remove it if the contract should stay closed.
TWO SUPPLIES, ON PURPOSE - DO NOT TIE THEM TOGETHER VIO (pin 5) -> +3V3_ALW, always on. VCC (pin 3) -> +5V, gated off in sleep. The split is what makes CAN wake work. In sleep the +5V rail is down, so the transmit side and the bus drivers are unpowered, but VIO keeps the receiver and the RXD output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
IGNITION SENSE (block E) - divider DNP, pulldown POPULATED R37 and R38 are DNP. R39 is NOT. GPIO 36 has no internal pull-up or pull-down and EXT1 ANY_HIGH wake is armed on it, so a floating pin wakes the board on noise and flattens the battery. R39 defines it low whether or not the divider is fitte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
ANTENNA KEEP-OUT - carries into layout (Task 8) No copper, no plating, no components and no ground pour may sit under the module's antenna area, on ANY layer. Overhang the module past the board edge, or cut the board back to it. The finned/metal wall of the enclosure must not be the antenna wall ei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
EN_BOOST AND EN_3V3SW PULLDOWNS ARE ON THE RAILS SHEET, NOT HERE The plan's Task 5 Step 4 asks for them here. They are already fitted as R19 and R20 next to the converters they gate, which is where they do the most good - the enable stays defined even if the inter-sheet net is open. One resistor pe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
WHY THE AUTO-RESET PAIR IS CROSS-COUPLED Each transistor's emitter sits on the OTHER control line, so the pair only acts when DTR and RTS differ. Both high or both low = run mode. That is what stops a plain serial monitor - which asserts one line on open - from dropping the board into the bootloade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
ACCEPTANCE (spec 7, 8.1) - ESP32-WROOM-32E-N8 (8 MB). NOT the 4 MB variant, NOT the -32UE (U.FL) variant. - Module powered from +3V3_ALW so it stays up in sleep. - Pin assignment EXACTLY per the plan's Global Constraints table. - CAN_RXD on GPIO 35 (RTC-capable, EXT0 wake); IGN_SENSE on GPIO 36 (EX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
HARDWARE-ENFORCED LISTEN-ONLY R23 (0 ohm) is DNP. With it unpopulated the transceiver TXD is held recessive by R24 and the board is PHYSICALLY INCAPABLE of transmitting on the vehicle bus. Populate R23 only for deliberate bench TX. This is not a firmware setting that can be got wrong, and not a fus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

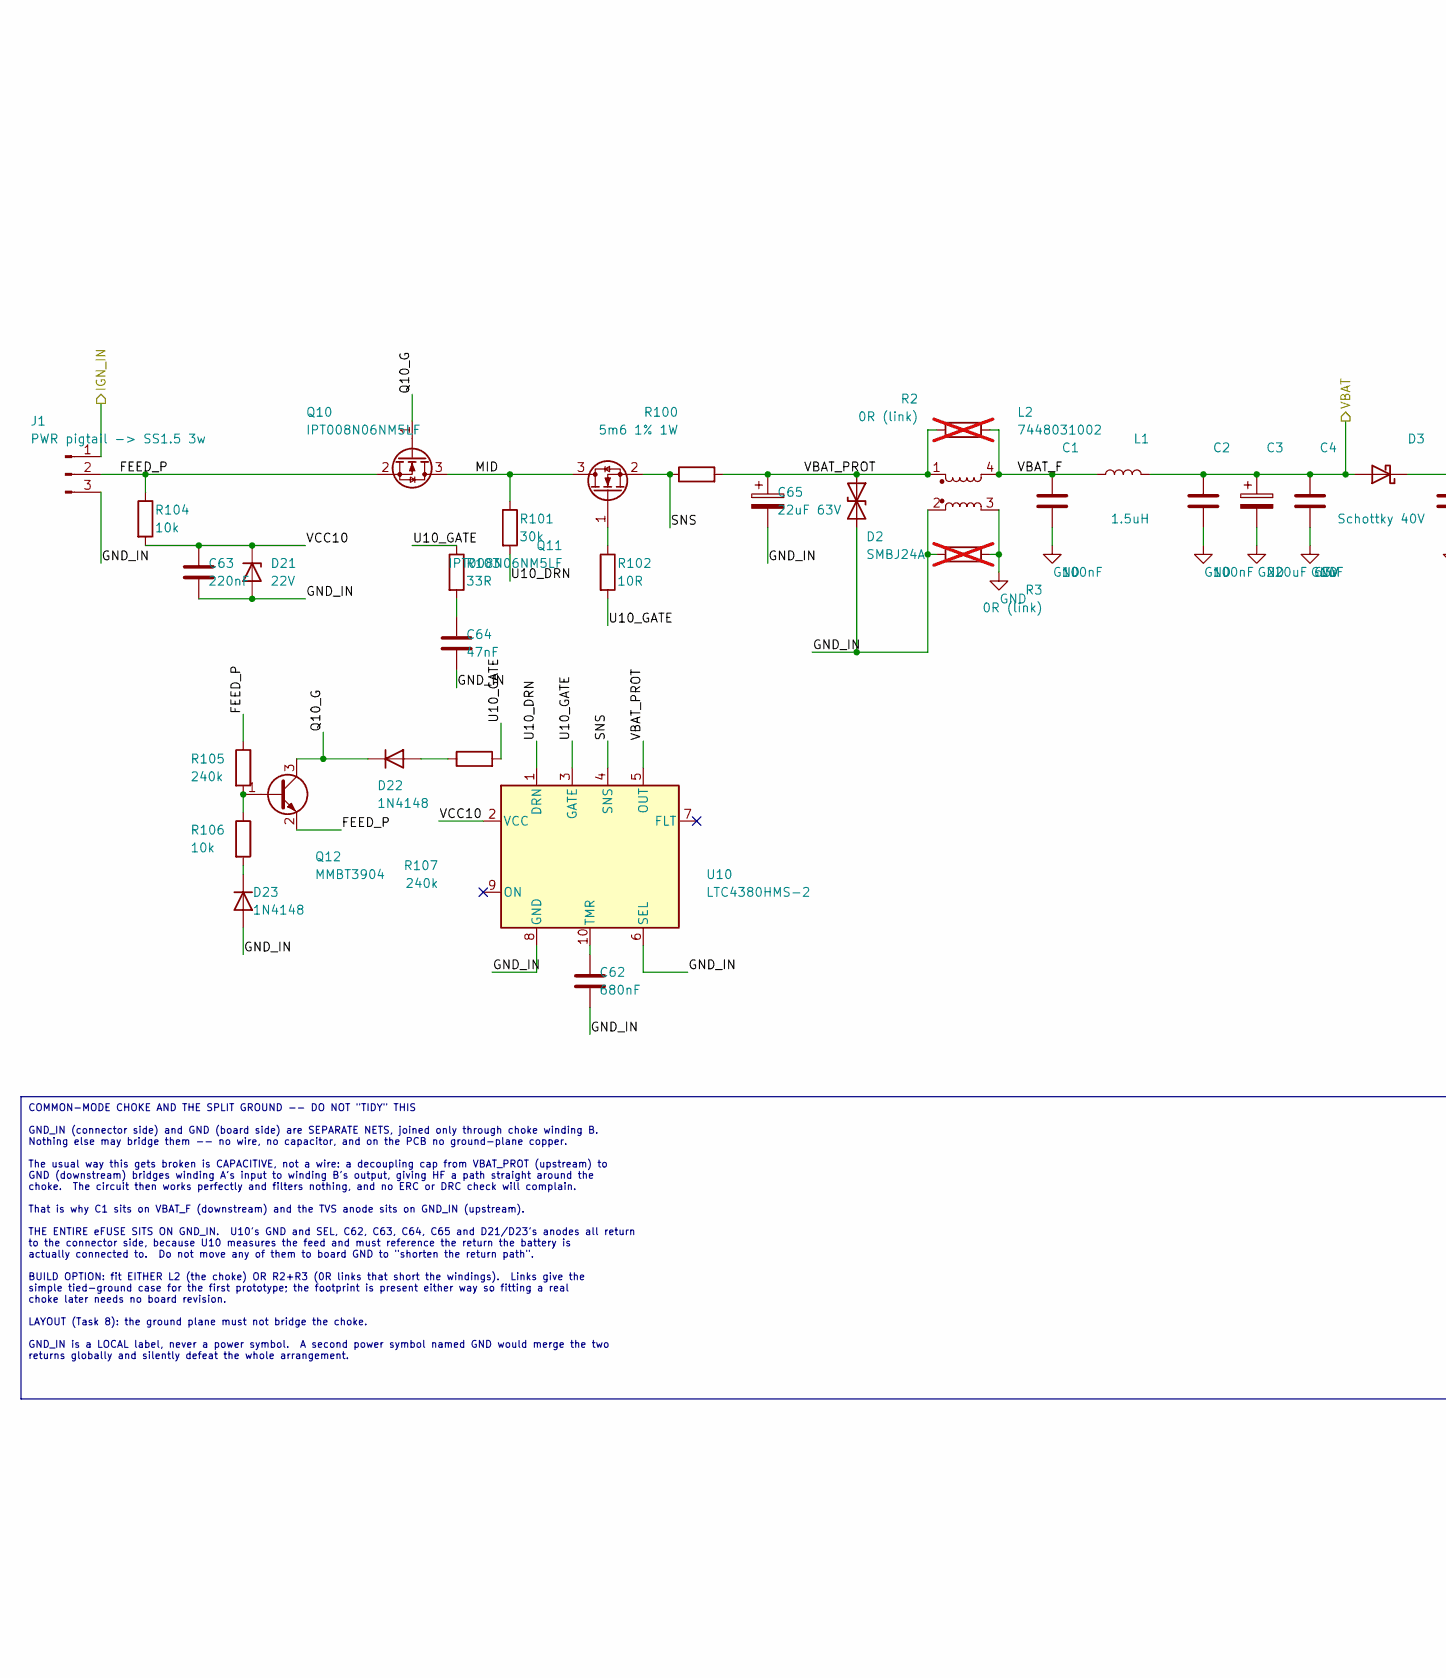
[picture p19: schematic power_input.kicad_sch, part in row 1, column 1]

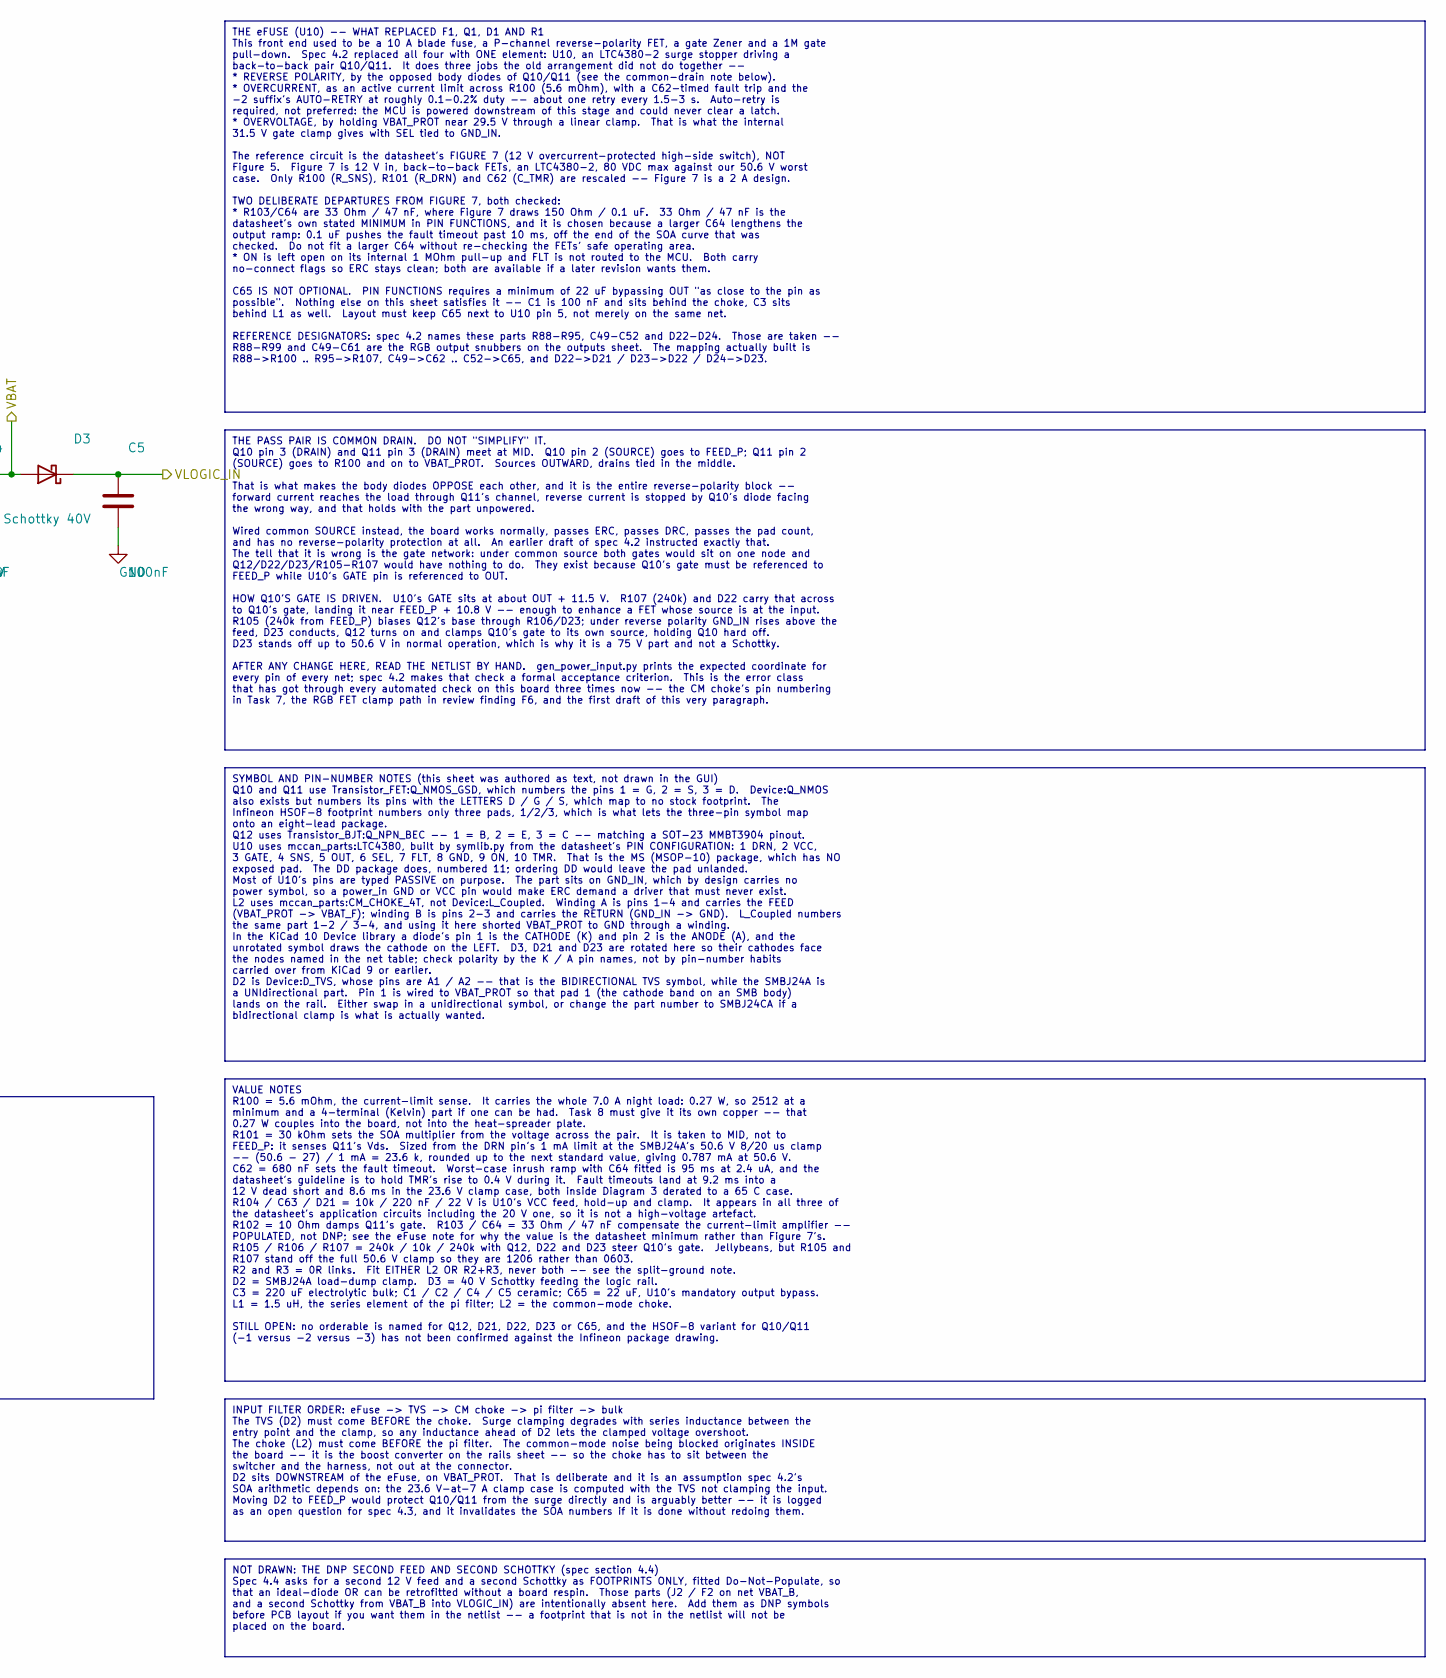
[picture p20: schematic power_input.kicad_sch, part in row 1, column 2]

Parts:
C1: 100nF; C_0603_1608Metric
C2, C5: 100nF; C_0805_2012Metric
C3: 220uF 63V; CP_Elec_10x10.5
C4: 1uF; C_1206_3216Metric
C62: 680nF; C_0603_1608Metric
C63: 220nF; C_0603_1608Metric
C64: 47nF; C_0805_2012Metric
C65: 22uF 63V; CP_Elec_6.3x7.7
D2: SMBJ24A; D_SMB
D3: Schottky 40V; D_SMA
D21: 22V; D_SOD-123
D22, D23: 1N4148; D_SOD-323
J1: PWR pigtail -> SS1.5 3w; SolderWire-1.5sqmm_1x03_P6mm_D1.7mm_OD3mm_Relief
L1: 1.5uH; L_Vishay_IHLP-4040
L2: 7448031002; Wurth_WE-CMBNC_7448031002
Q10, Q11: IPT008N06NM5LF; Infineon_PG-HSOF-8-1
Q12: MMBT3904; SOT-23
R2, R3: 0R (link); R_2512_6332Metric; not fitted
R100: 5m6 1% 1W; R_2512_6332Metric
R101: 30k; R_1206_3216Metric
R102: 10R; R_0603_1608Metric
R103: 33R; R_0603_1608Metric
R104, R106: 10k; R_0603_1608Metric
R105, R107: 240k; R_1206_3216Metric
U10: LTC4380HMS-2; MSOP-10_3x3mm_P0.5mm

Connections:
/IGN_IN: J1.1; also elsewhere on the board
/VBAT: C2.1, C3.1, C4.1, D3.2 (A), L1.2; also elsewhere on the board
/VLOGIC_IN: C5.1, D3.1 (K); also elsewhere on the board
/power_input/FEED_P: J1.2, Q10.2 (S), Q12.2 (E), R104.1, R105.1
/power_input/GND_IN: C62.2, C63.2, C64.2, C65.2, D2.2 (A2), D21.2 (A), D23.2 (A), J1.3, L2.2, R3.1, U10.6 (SEL), U10.8 (GND)
/power_input/MID: Q10.3 (D), Q11.3 (D), R101.1
/power_input/Q10_G: D22.1 (K), Q10.1 (G), Q12.3 (C)
/power_input/SNS: Q11.2 (S), R100.1, U10.4 (SNS)
/power_input/U10_DRN: R101.2, U10.1 (DRN)
/power_input/U10_GATE: R102.2, R103.1, R107.2, U10.3 (GATE)
/power_input/VBAT_F: C1.1, L1.1, L2.4, R2.2
/power_input/VBAT_PROT: C65.1, D2.1 (A1), L2.1, R2.1, R100.2, U10.5 (OUT)
/power_input/VCC10: C63.1, D21.1 (K), R104.2, U10.2 (VCC)
unnamed: C64.1, R103.2
unnamed: D22.2 (A), R107.1
unnamed: D23.1 (K), R106.2
unnamed: Q11.1 (G), R102.1
unnamed: Q12.1 (B), R105.2, R106.1
unnamed: C62.1, U10.10 (TMR)

Notes on the sheet:
VALUE NOTES R100 = 5.6 mOhm, the current-limit sense. It carries the whole 7.0 A night load: 0.27 W, so 2512 at a minimum and a 4-terminal (Kelvin) part if one can be had. Task 8 must give it its own copper -- that 0.27 W couples into the board, not into the heat-spreader plate. R101 = 30 kOhm sets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
INPUT FILTER ORDER: eFuse -> TVS -> CM choke -> pi filter -> bulk The TVS (D2) must come BEFORE the choke. Surge clamping degrades with series inductance between the entry point and the clamp, so any inductance ahead of D2 lets the clamped voltage overshoot. The choke (L2) must come BEFORE the pi f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
THE PASS PAIR IS COMMON DRAIN. DO NOT "SIMPLIFY" IT. Q10 pin 3 (DRAIN) and Q11 pin 3 (DRAIN) meet at MID. Q10 pin 2 (SOURCE) goes to FEED_P; Q11 pin 2 (SOURCE) goes to R100 and on to VBAT_PROT. Sources OUTWARD, drains tied in the middle. That is what makes the body diodes OPPOSE each other, and it 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
THE eFUSE (U10) -- WHAT REPLACED F1, Q1, D1 AND R1 This front end used to be a 10 A blade fuse, a P-channel reverse-polarity FET, a gate Zener and a 1M gate pull-down. Spec 4.2 replaced all four with ONE element: U10, an LTC4380-2 surge stopper driving a back-to-back pair Q10/Q11. It does three job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
SYMBOL AND PIN-NUMBER NOTES (this sheet was authored as text, not drawn in the GUI) Q10 and Q11 use Transistor_FET:Q_NMOS_GSD, which numbers the pins 1 = G, 2 = S, 3 = D. Device:Q_NMOS also exists but numbers its pins with the LETTERS D / G / S, which map to no stock footprint. The Infineon HSOF-8 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
COMMON-MODE CHOKE AND THE SPLIT GROUND -- DO NOT "TIDY" THIS GND_IN (connector side) and GND (board side) are SEPARATE NETS, joined only through choke winding B. Nothing else may bridge them -- no wire, no capacitor, and on the PCB no ground-plane copper. The usual way this gets broken is CAPACITIV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
NOT DRAWN: THE DNP SECOND FEED AND SECOND SCHOTTKY (spec section 4.4) Spec 4.4 asks for a second 12 V feed and a second Schottky as FOOTPRINTS ONLY, fitted Do-Not-Populate, so that an ideal-diode OR can be retrofitted without a board respin. Those parts (J2 / F2 on net VBAT_B, and a second Schottky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
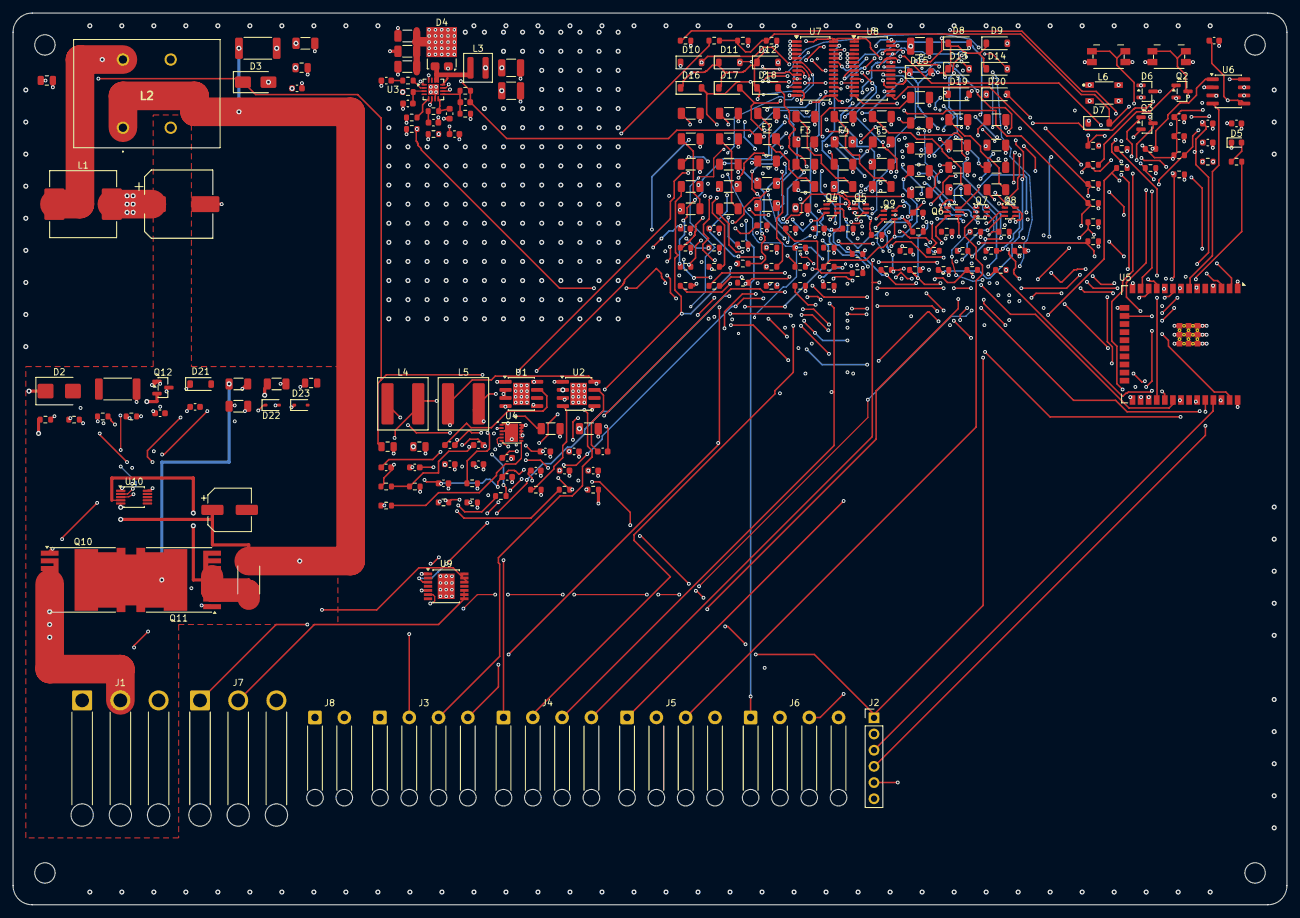
[picture p21: board mccan.kicad_pcb from above]

Board: 8 copper layers, 200.0 x 140.0 mm, 238 parts (0 on the bottom side), 153 nets.

Other parts of the board:
H1, H2, H3, H4: MountingHole; MountingHole_3.2mm_M3
Q4, Q5, Q6, Q7, Q8, Q9: NX5020UNBKS; SOT-363_SC-70-6

Their connections:
/outputs/PWM_FL_B: Q5.2; also elsewhere on the board
/outputs/PWM_FL_G: Q4.5; also elsewhere on the board
/outputs/PWM_FL_R: Q4.2; also elsewhere on the board
/outputs/PWM_FR_B: Q6.5; also elsewhere on the board
/outputs/PWM_FR_G: Q6.2; also elsewhere on the board
/outputs/PWM_FR_R: Q5.5; also elsewhere on the board
/outputs/PWM_RL_B: Q8.2; also elsewhere on the board
/outputs/PWM_RL_G: Q7.5; also elsewhere on the board
/outputs/PWM_RL_R: Q7.2; also elsewhere on the board
/outputs/PWM_RR_B: Q9.5; also elsewhere on the board
/outputs/PWM_RR_G: Q9.2; also elsewhere on the board
/outputs/PWM_RR_R: Q8.5; also elsewhere on the board
/outputs/RET_FL_R: Q4.6; also elsewhere on the board
/outputs/SENSE_FL_B: Q5.1; also elsewhere on the board
/outputs/SENSE_FL_G: Q4.4; also elsewhere on the board
/outputs/SENSE_FL_R: Q4.1; also elsewhere on the board
/outputs/SENSE_FR_B: Q6.4; also elsewhere on the board
/outputs/SENSE_FR_G: Q6.1; also elsewhere on the board
/outputs/SENSE_FR_R: Q5.4; also elsewhere on the board
/outputs/SENSE_RL_B: Q8.1; also elsewhere on the board
/outputs/SENSE_RL_G: Q7.4; also elsewhere on the board
/outputs/SENSE_RL_R: Q7.1; also elsewhere on the board
/outputs/SENSE_RR_B: Q9.4; also elsewhere on the board
/outputs/SENSE_RR_G: Q9.1; also elsewhere on the board
/outputs/SENSE_RR_R: Q8.4; also elsewhere on the board
