JimboMcRackem/ESP32MCCAN/hardware/scripts/check_zone_islands.py

# -*- coding: utf-8 -*-
"""Catch a zone that filled as two (or more) disconnected islands.

Task 7 pinched `GNDIN_F` in two.  It filled as a pair of disconnected copper islands and the
board shipped through every check this repo had:

    * KiCad DRC with `--refill-zones` reported 0 violations.  A split fill is an *unconnected
      item*, not a violation -- `--exit-code-violations` never sees it.
    * `check_grounds.py` passed.  It tests the zone's *authored polygon* with point-in-polygon
      against pad centres; the polygon was never wrong, the copper that filled inside it was.

What the DRC report shows that neither check does is the unconnected-item body itself.  A split
fill produces an `[unconnected_items]` block with two of its anchors BOTH the same zone, at the
same point -- KiCad reporting the zone as unconnected to itself:

    [unconnected_items]: Missing connection between items
        Local override; error
        @(42.0000 mm, 36.0000 mm): Zone 'GNDIN_F' [/power_input/GND_IN] on F.Cu, priority 1
        @(42.0000 mm, 36.0000 mm): Zone 'GNDIN_F' [/power_input/GND_IN] on F.Cu, priority 1

That is what this parses `output/drc.rpt` for.  A block is not always two anchors -- KiCad emits
one line per item in the unconnected group, and a group can have three or more when a zone and
several pads all miss each other at one point -- so every anchor in a block is parsed and
classified, not just the first two (round 2 of Task 8 found a two-anchor-only parse skipping a
block whose first anchor was a pad and the split was in anchors two and three).  This deliberately
does NOT fire on a zone paired only with a PAD -- a pad on the zone's net that failed to connect
to it is a different fault (a routing miss), already visible in the unconnected-pad count, not a
split fill.  Gating on "a zone appears in an unconnected item" would fire on that pad case too;
gating on "two of a block's anchors name the same zone" does not.  This board currently has no
zone-vs-pad case at all -- `grep -c "Zone " output/drc.rpt` is 0 today -- so the exclusion is here
to keep the signature specific if one ever appears, not because one has been observed.

Run after `kicad-cli.exe pcb drc --refill-zones` has written `output/drc.rpt`.  Exit status is
non-zero if any zone shows the self-paired signature, or if the report cannot be trusted (it is
missing, or older than the board it is supposed to describe).

    python scripts/check_zone_islands.py                       # output/drc.rpt vs mccan.kicad_pcb
    python scripts/check_zone_islands.py other/drc.rpt other/board.kicad_pcb
"""

import io
import os
import re
import sys

HERE = os.path.dirname(os.path.abspath(__file__))
HW = os.path.dirname(HERE)
REPORT = sys.argv[1] if len(sys.argv) > 1 else os.path.join(HW, "output", "drc.rpt")
PCB = sys.argv[2] if len(sys.argv) > 2 else os.path.join(HW, "mccan.kicad_pcb")

# A block is a header line, one severity line, then a run of one or more anchor lines -- KiCad
# emits one anchor per item in the unconnected group, and round 2 of Task 8 found a real block
# with three (a pad, then two anchors of the same zone -- the split).  Fault 5: the previous
# version of this file matched exactly two anchors with one combined regex, so a block whose
# FIRST anchor was a pad but whose second and third were the same zone never matched at all --
# `ZONE_RE.match` failed on the pad anchor in "both anchors" position 1, the whole block was
# skipped, and the split it contained was never looked at.  Anchor count is now unbounded and
# every anchor is classified on its own, so which position the zone anchors land in cannot hide
# them.
#
# The severity line is deliberately NOT pinned to the literal "Local override; error" text, for
# the same reason as before this fault was fixed: every block in every report this gate has been
# run against carries exactly that string, but that is a fact about the boards examined, not a
# guarantee about what KiCad can emit.  It is consumed as a single unexamined line between the
# header and the anchor run.
HEADER_RE = re.compile(r'^\[unconnected_items\]:')
ANCHOR_RE = re.compile(r'^[ \t]*@\(([-\d.]+) mm, ([-\d.]+) mm\): (.+)$')

ZONE_RE = re.compile(r"^Zone '([^']+)' \[([^\]]*)\] on ([^,\n]+)")


def parse_blocks(text):
    """Split `text` into unconnected-item blocks, each a list of (x, y, description) anchors.

    One entry per `[unconnected_items]:` header, always -- a header with no severity line, or
    with fewer than two anchors after it, still produces a (possibly short) list rather than
    being dropped, so a malformed block cannot silently vanish from the count the way the old
    fixed-shape regex could.  The caller is what decides a short block is fatal.
    """
    lines = text.split("\n")
    blocks = []
    i = 0
    n = len(lines)
    while i < n:
        if not HEADER_RE.match(lines[i]):
            i += 1
            continue
        j = i + 1
        # The severity line is any single line, consumed unexamined -- unless the header is
        # immediately followed by another header, in which case there is no severity line and no
        # anchors, and this block is short (empty) rather than eating the next block's header.
        if j < n and not HEADER_RE.match(lines[j]):
            j += 1
        anchors = []
        while j < n:
            m = ANCHOR_RE.match(lines[j])
            if not m:
                break
            anchors.append((m.group(1), m.group(2), m.group(3)))
            j += 1
        blocks.append(anchors)
        i = j
    return blocks


def main():
    if not os.path.exists(PCB):
        print("FAIL: %s is missing" % PCB)
        return 2
    if not os.path.exists(REPORT):
        print("FAIL: %s is missing -- run kicad-cli.exe pcb drc --refill-zones first" % REPORT)
        return 2
    # A stale report describes a board that no longer exists.  Silently trusting one is exactly
    # how the split fill this file exists to catch shipped in the first place: three checks ran
    # and returned 0 without any of them looking at current copper.  This comparison can in
    # principle misfire -- a checkout or git operation that restores mccan.kicad_pcb after
    # output/drc.rpt would make a genuinely fresh report look stale by a few seconds -- but the
    # trade is the right one either direction.  A false exit 2 costs the seconds it takes to
    # re-run DRC and look at why; trusting an mtime that lies costs a silent pass on a board that
    # was never actually checked, which is the failure this whole file exists to close off.
    if os.path.getmtime(REPORT) < os.path.getmtime(PCB):
        print("FAIL: %s is older than %s -- refill and re-run DRC before trusting this report"
              % (REPORT, PCB))
        return 2

    text = io.open(REPORT, encoding="utf-8").read()
    blocks = parse_blocks(text)

    # `parse_blocks` emits exactly one entry per header, so this equality is now true by
    # construction rather than by the parser getting lucky on every block's shape -- it is kept
    # as an explicit check anyway, because a header string that turns up somewhere `parse_blocks`
    # does not treat as a header (inside a description, say) would make `text.count` and the loop
    # disagree, and that disagreement is exactly the "this report has a shape this gate does not
    # recognise" case the guard exists to catch.
    n_headers = text.count("[unconnected_items]:")
    if n_headers != len(blocks):
        print("FAIL: %d '[unconnected_items]' header(s) in %s but %d block(s) parsed -- "
              "this report has a shape this gate does not recognise and cannot be trusted"
              % (n_headers, REPORT, len(blocks)))
        return 2

    # A block with fewer than two anchors cannot name a split (a split needs two zone anchors
    # naming the same zone) and is not a shape this gate expects to see in a real report -- a
    # header with no severity line and no anchors, or with exactly one anchor, is fatal rather
    # than silently treated as "no split found here".
    short = [i for i, b in enumerate(blocks) if len(b) < 2]
    if short:
        print("FAIL: %d block(s) in %s have fewer than 2 anchors -- malformed or unrecognised "
              "shape, cannot be trusted" % (len(short), REPORT))
        return 2

    # Every anchor in a block is classified, not just the first two (fault 5): a block can carry
    # any number of anchors, and the split -- two zone anchors naming the same zone -- can be in
    # any pair of positions, including the second and third when the first anchor is a pad.  A
    # block with three or more anchors and no zone anchor at all (an all-pad group) simply
    # contributes no split, the same as a two-anchor all-pad block always has.
    splits = []
    for anchors in blocks:
        seen = {}
        for x, y, desc in anchors:
            m = ZONE_RE.match(desc)
            if not m:
                continue
            name = m.group(1)
            if name in seen:
                splits.append((name, m.group(2), m.group(3), float(x), float(y)))
            else:
                seen[name] = (x, y, desc)

    print("%s: %d unconnected-item block(s) parsed" % (os.path.basename(REPORT), len(blocks)))
    if splits:
        for name, net, layer, x, y in splits:
            print("  FAIL zone '%s' [%s] on %s is unconnected to itself at (%.4f mm, %.4f mm)"
                  % (name, net, layer, x, y))
        print("  -> the fill split into disconnected islands; refill and re-route the gap")
        return 1

    print("  OK: no zone is unconnected to itself")
    return 0


if __name__ == "__main__":
    sys.exit(main())
