JimboMcRackem/ESP32MCCAN/hardware/scripts/gen_power_input.py

#!/usr/bin/env python3
# -*- coding: utf-8 -*-
"""Generate hardware/sheets/power_input.kicad_sch.

Repaired 2026-09-15.  This generator had drifted out of step with the committed
sheet, which had been saved from the KiCad GUI: it was missing four cosmetic
fields and did not match the GUI's element ordering.  Fixed, it now reproduces
the pre-J1 committed sheet BYTE FOR BYTE, which is what proves it faithful.
See kicanon.py for the ordering rules.
"""
import os, sys, uuid, math
import fpmap
sys.path.insert(0, os.path.dirname(os.path.abspath(__file__)))

HERE = os.path.dirname(os.path.abspath(__file__))
SCRATCH = HERE
OUT = os.path.join(HERE, "..", "sheets", "power_input.kicad_sch")

SHEET_UUID = "998d692e-4a37-4d1c-95bc-f35ab32eee34"
ROOT_UUID = "7410bb74-5653-4f1b-8c7c-ce17eb633f20"
SHEET_INST_UUID = "bb7f7a86-b153-4a57-9167-66f1a7c26371"
INST_PATH = "/%s/%s" % (ROOT_UUID, SHEET_INST_UUID)
PROJECT = "mccan"

# deterministic uuids so re-runs produce stable files
_ns = uuid.UUID("11111111-2222-3333-4444-555555555555")
def U(tag):
    return str(uuid.uuid5(_ns, tag))

libsyms = open(os.path.join(HERE, "power_input_libsyms.txt"), encoding="utf-8").read()

# ---------------------------------------------------------------- pin geometry
# library pin coordinates (lib frame, Y-up), keyed by lib_id -> {number: (x, y)}
PINS = {
    "Connector:Conn_01x02_Pin": {"1": (5.08, 0.0), "2": (5.08, -2.54)},
    # Transistor_FET:Si7141DP (used for Q13, value SQJ461EP) -- PowerPAK SO-8L: S = 1,2,3 (stacked
    # at one point), G = 4, D = 5.  Matches the SQJ461EP footprint's five pads.
    "Transistor_FET:Si7141DP": {"1": (2.54, -5.08), "2": (2.54, -5.08), "3": (2.54, -5.08),
                                "4": (-5.08, 0.0), "5": (2.54, 5.08)},
    "Device:NetTie_2": {"1": (-2.54, 0.0), "2": (2.54, 0.0)},
    "Device:Fuse":              {"1": (0.0, 3.81), "2": (0.0, -3.81)},
    # Transistor_FET:Q_PMOS_GSD -- 1 = G, 2 = S, 3 = D (numeric, maps to real footprints)
    "Transistor_FET:Q_PMOS_GSD": {"1": (-5.08, 0.0), "2": (2.54, -5.08), "3": (2.54, 5.08)},
    "Device:R":                 {"1": (0.0, 3.81), "2": (0.0, -3.81)},
    # Transistor_FET:Q_NMOS_GSD -- 1 = G, 2 = S, 3 = D.  The eFuse pass pair Q10/Q11 is
    # COMMON DRAIN: pin 3 of both meets at MID, pin 2 of Q10 goes to FEED_P and pin 2 of
    # Q11 goes to R88.  Get this backwards and the reverse-polarity block disappears while
    # ERC, DRC and the pad count all still pass.  See spec section 4.2.
    "Transistor_FET:Q_NMOS_GSD": {"1": (-5.08, 0.0), "2": (2.54, -5.08), "3": (2.54, 5.08)},
    # Transistor_BJT:Q_NPN_BEC -- 1 = B, 2 = E, 3 = C
    "Transistor_BJT:Q_NPN_BEC": {"1": (-5.08, 0.0), "2": (2.54, -5.08), "3": (2.54, 5.08)},
    # Device:D and the three diode variants below: pin 1 = CATHODE, pin 2 = ANODE.
    "Device:D":                 {"1": (-3.81, 0.0), "2": (3.81, 0.0)},
    "Device:L":                 {"1": (0.0, 3.81), "2": (0.0, -3.81)},
    "Device:C":                 {"1": (0.0, 3.81), "2": (0.0, -3.81)},
    "Device:C_Polarized":       {"1": (0.0, 3.81), "2": (0.0, -3.81)},
    "Device:D_Zener":           {"1": (-3.81, 0.0), "2": (3.81, 0.0)},
    "Device:D_TVS":             {"1": (-3.81, 0.0), "2": (3.81, 0.0)},
    "Device:D_Schottky":        {"1": (-3.81, 0.0), "2": (3.81, 0.0)},
    # mccan_parts:CM_CHOKE_4T -- winding A = 1(left)-4(right), winding B = 2(left)-3(right),
    # matching the Wurth 7448031002 datasheet.  Device:L_Coupled numbers these 1-2/3-4 and
    # using it here shorted VBAT_PROT to GND through a winding.  See symlib.py.
    "mccan_parts:CM_CHOKE_4T":  {"1": (-5.08, 2.54), "4": (5.08, 2.54),
                                 "2": (-5.08, -2.54), "3": (5.08, -2.54)},
    # mccan_parts:LTC4380 -- MSOP-10, see symlib.py for the verified pin numbering.
    "mccan_parts:LTC4380":      {"1": (-7.62, 12.7),  "3": (-2.54, 12.7),
                                 "4": (2.54, 12.7),   "5": (7.62, 12.7),
                                 "2": (-15.24, 5.08), "9": (-15.24, -5.08),
                                 "7": (15.24, 5.08),  "8": (-7.62, -12.7),
                                 "10": (0.0, -12.7),  "6": (7.62, -12.7)},
    "power:GND":                {"1": (0.0, 0.0)},
}

def place(px, py, rot, lx, ly):
    """library coord -> sheet coord for a symbol placed at (px,py) with rotation rot."""
    if rot == 0:
        return (px + lx, py - ly)
    if rot == 90:
        return (px - ly, py - lx)
    if rot == 180:
        return (px - lx, py + ly)
    if rot == 270:
        return (px + ly, py + lx)
    raise ValueError(rot)

# ---------------------------------------------------------------- components
# (ref, lib_id, x, y, rot, value, footprint, value_offset)
import importlib.util as _ilu2
_sp2 = _ilu2.spec_from_file_location("layout", os.path.join(HERE, "layout_power_input.py"))
layout = _ilu2.module_from_spec(_sp2)
_sp2.loader.exec_module(layout)
COMPS = layout.COMPS
HORIZONTAL = layout.HORIZONTAL
GNDS = layout.GNDS
WIRES = layout.WIRES
JUNCTIONS = layout.JUNCTIONS
LABELS = layout.LABELS
HLABELS = layout.HLABELS
NOCONN = getattr(layout, "NOCONN", ())

import importlib.util as _ilu
_spec = _ilu.spec_from_file_location("notes", os.path.join(HERE, "notes_power_input.py"))
notes = _ilu.module_from_spec(_spec)
_spec.loader.exec_module(notes)
TEXTBOXES = notes.TEXTBOXES
NOTE_FONT = notes.NOTE_FONT

# ---------------------------------------------------------------- emit
def f(v):
    s = "%.4f" % v
    s = s.rstrip("0").rstrip(".")
    return s if s not in ("", "-0") else "0"

L = []
def w(indent, s):
    L.append("\t" * indent + s)

w(0, "(kicad_sch")
w(1, "(version 20260306)")
w(1, '(generator "eeschema")')
w(1, '(generator_version "10.0")')
w(1, '(uuid "%s")' % SHEET_UUID)
# A3 since 2026-09-20: the LTC4380 eFuse block (section 4.2) needs the room below the
# rail that A4 does not have.  Mixed paper sizes are already normal on this project --
# outputs is A2, mcu_can and rails are A3.
w(1, '(paper "A3")')
w(1, "(title_block")
w(2, '(title "power_input")')
w(1, ")")
w(1, "(lib_symbols")
_blocks = []
for block in libsyms.split("\n(symbol "):
    block = block.strip("\n")
    if not block:
        continue
    if not block.startswith("(symbol "):
        block = "(symbol " + block
    _blocks.append(block)
# KiCad writes lib_symbols in name order
_blocks.sort(key=lambda b: b.split('"')[1])
for block in _blocks:
    block = block.strip("\n")
    if not block:
        continue
    if not block.startswith("(symbol "):
        block = "(symbol " + block
    # re-indent: first line at two tabs, keep inner relative indentation
    blines = block.split("\n")
    L.append("\t\t" + blines[0].strip())
    for bl in blines[1:]:
        L.append("\t" + bl)
w(1, ")")

# ---- text boxes
for (txt, x, y, sx, sy) in TEXTBOXES:
    esc = txt.replace("\\", "\\\\").replace('"', '\\"').replace("\n", "\\n")
    w(1, '(text_box "%s"' % esc)
    w(2, "(exclude_from_sim no)")
    w(2, "(at %s %s 0)" % (f(x), f(y)))
    w(2, "(size %s %s)" % (f(sx), f(sy)))
    w(2, "(margins 0.9525 0.9525 0.9525 0.9525)")
    w(2, "(stroke")
    w(3, "(width 0)")
    w(3, "(type default)")
    w(2, ")")
    w(2, "(fill")
    w(3, "(type none)")
    w(2, ")")
    w(2, "(effects")
    w(3, "(font")
    w(4, "(size %s %s)" % (f(NOTE_FONT), f(NOTE_FONT)))
    w(3, ")")
    w(3, "(justify left top)")
    w(2, ")")
    w(2, '(uuid "%s")' % U("tb" + txt[:40]))
    w(1, ")")

# ---- no-connect flags
# These are not decoration: without them ERC reports every deliberately unused pin.
for (x, y) in NOCONN:
    w(1, "(no_connect")
    w(2, "(at %s %s)" % (f(x), f(y)))
    w(2, '(uuid "%s")' % U("nc%s%s" % (x, y)))
    w(1, ")")

# ---- junctions
for (x, y) in JUNCTIONS:
    w(1, "(junction")
    w(2, "(at %s %s)" % (f(x), f(y)))
    w(2, "(diameter 0)")
    w(2, "(color 0 0 0 0)")
    w(2, '(uuid "%s")' % U("junc%s%s" % (x, y)))
    w(1, ")")

# ---- wires
for (a, b) in WIRES:
    w(1, "(wire")
    w(2, "(pts")
    w(3, "(xy %s %s) (xy %s %s)" % (f(a[0]), f(a[1]), f(b[0]), f(b[1])))
    w(2, ")")
    w(2, "(stroke")
    w(3, "(width 0)")
    w(3, "(type default)")
    w(2, ")")
    w(2, '(uuid "%s")' % U("wire%s%s" % (a, b)))
    w(1, ")")

# ---- local labels
for (name, x, y, rot) in LABELS:
    w(1, '(label "%s"' % name)
    w(2, "(at %s %s %d)" % (f(x), f(y), rot))
    w(2, "(effects")
    w(3, "(font")
    w(4, "(size 1.27 1.27)")
    w(3, ")")
    w(3, "(justify left bottom)")
    w(2, ")")
    w(2, '(uuid "%s")' % U("lbl%s@%s,%s" % (name, x, y)))
    w(1, ")")

# ---- hierarchical labels
for (name, x, y, rot, shape) in HLABELS:
    w(1, '(hierarchical_label "%s"' % name)
    w(2, "(shape %s)" % shape)
    w(2, "(at %s %s %d)" % (f(x), f(y), rot))
    w(2, "(effects")
    w(3, "(font")
    w(4, "(size 1.27 1.27)")
    w(3, ")")
    w(3, "(justify left)")
    w(2, ")")
    w(2, '(uuid "%s")' % U("hlbl" + name))
    w(1, ")")
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
