JimboMcRackem/ESP32MCCAN/(commit log)

2026-07-29 Add ESP32 MCCAN lighting firmware design spec
    Approved design for dynamic CAN-driven motorcycle lighting controller:
    config-driven CAN mapping + fixed behavior engine, 4 RGB corner strings +
    2 Denali channels, WiFi-AP web app with CAN discovery mode.
2026-07-29 Add core firmware implementation plan (Plan 1 of 2)
    Nine bite-sized TDD tasks: scaffold, domain types, config + Experia
    default profile, CAN evaluation, behavior engine (corner matrix + Denali
    spot latch), config JSON, channel map, ESP32 HAL + boot wiring.
2026-07-29 feat: add CAN frame cache and logical-function evaluation
2026-07-29 test: strengthen spot-latch assertion, add night-Denali test; doc switch assumption
2026-07-29 docs: switch PWM path to external PCA9685 (I2C) in plan Task 9 and spec
2026-07-29 feat: map OutputIntent to 14 PWM channels behind IPwm interface
2026-07-29 feat: add ESP32 HAL (PCA9685/TWAI/LittleFS) and boot wiring
2026-07-29 fix: propagate PCA9685 begin() failure; pin Adafruit BusIO dep
    [pwm_pca9685.cpp]
2026-08-11 feat: expose CanState frame snapshot for discovery mode
2026-08-11 feat: add pure web protocol module (config get/set, discovery, frames)
2026-08-11 feat: wire WebServerHal for live config apply, persist, and discovery
2026-08-11 fix: serve captive-portal page instead of endless redirect; log LittleFS state
    serveStatic("/") fell through to a 302->"/" catch-all, which looped
    (ERR_TOO_MANY_REDIRECTS) whenever /index.html was absent. Now the root and
    unknown paths serve index.html directly (proper captive-portal behavior), or a
    plain-text diagnostic if the LittleFS image was never flashed. Also logs LittleFS
    total/used and file presence at boot to diagnose FS-mount issues.
    [web_server.cpp]
2026-08-12 fix(webapp): cap discovery bit assignment at MAX_BITS=4
    assignBit pushed bits without limit; configFromJson silently truncates
    past FunctionMap::MAX_BITS (config_json.cpp:72), so a 5th+ bit was lost on
    save with no feedback. Now reject at capacity and on duplicates with a
    clear alert. data-only change; re-flash with -t uploadfs to apply.
2026-09-11 docs: add PCB / hardware design spec
    Fab-ready custom PCB for the ESP32 MCCAN lighting controller, resolving
    the automotive power, PWM path and connector decisions that the firmware
    spec (2026-07-29) deferred to the hardware phase.
    Key decisions:
    - 24 V constant-voltage RGB strings (fixed) -> synchronous 12->24 V boost
    - Octal smart low-side switches in parallel-input mode for RGB, dual
    PROFET high-side for Denali; SPI for diagnostics only
    - PCA9685 retained for RGB PWM; Denali PWM moved to ESP32 LEDC because the
    PCA9685 prescaler is global -> composite IPwm
    - Single 10 A Experia peripheral feed, second feed laid out unpopulated
    - CAN-activity wake from deep sleep; AP live only while th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
2026-09-11 docs: dual power feed required — Denali D4 2.0 confirmed at 40 W each
    Verified the D4 2.0 TriOptic draws 80 W / 6.6 A for the pair (four 10 W
    CREE XPL HI per pod), not the <=25 W each the budget assumed. Single 10 A
    feed totals 10.5 A and does not fit, so both feeds are now populated with
    a domain split rather than one feed plus unpopulated footprints.
    - Feed A: boost -> RGB + logic, 3.9 A, 7.5 A fuse (61% margin)
    - Feed B: Denali pair, 6.6 A, 10 A fuse (34% margin)
    - Logic on a Schottky OR of both, so the MCU survives either feed failing
    - Panel now nine penetrations; two fuse holders
    - PROFET dissipation revised to 0.11 W/channel at 3.3 A; total ~3.6 W
    - DataDim electronics in the D4 ra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
2026-09-11 docs(spec): add CAN STB pin, passive-default biasing, fix deep-sleep wake polarity
    Three gaps found while mapping the spec onto a schematic:
    - No GPIO was allocated for the TJA1042 STB pin, so the transceiver could
    not be placed in standby and CAN wake could not work. Assigned GPIO 14
    (RTC-capable).
    - Wake polarity was impossible as written: the spec armed EXT1 on both
    GPIO 35 and 36, but CAN wake is active-low and ignition sense is
    active-high, and the classic ESP32 EXT1 supports only ALL_LOW or
    ANY_HIGH (no ANY_LOW). Split to EXT0 level-0 on GPIO 35 plus EXT1
    ANY_HIGH on GPIO 36, and budgeted the ~10 uA RTC_PERIPH cost of EXT0.
    - Added a passive-default biasing requirement so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
2026-09-11 docs: add PCB / hardware implementation plan
    Eleven tasks from the 2026-09-11 PCB spec: KiCad scaffolding, part
    selection verification, four schematic sheets, schematic review, layout
    in two stages, enclosure/harness docs, and a bring-up procedure.
    Hardware has no unit-test cycle, so each task ends in a real verification
    gate instead: kicad-cli ERC/DRC with --exit-code-violations, or a written
    acceptance record committed to the repo. Acceptance criteria are written
    before the work, preserving the test-first discipline in substance.
    Task 2 gates the whole plan. It verifies every part against the spec's
    criteria, including two go/no-go items: whether open-load detection can
    resolve a 0.14 A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
2026-09-11 hw: scaffold KiCad project, four sheets, and ERC/DRC gates
    [mccan.kicad_sch, mcu_can.kicad_sch, outputs.kicad_sch, power_input.kicad_sch, rails.kicad_sch]
2026-09-11 docs(hardware): fill section 1 (octal low-side switch) verification rows
    Row 1.1 (GO/NO-GO) FAILS: open-load detection on every verified candidate is
    an OFF-state-only VDS comparison against an internal diagnostic current
    source. TLE8110ED diagnosis code 01 is defined as "Open Load in OFF-Mode";
    the ON-state code covers only overload/short/overtemperature. No load-current
    detection threshold is specified, so 0.14 A resolution is unspecified.
    Rows evaluated against Infineon TLE8110ED (the only candidate with a
    per-channel direct PWM input pin). PASS 1.2, 1.3, 1.4, 1.5, 1.7, 1.9;
    FAIL 1.1, 1.6, 1.8; UNVERIFIED 1.10 (distributor stock/lead time).
    VNI8200XP screened out as a high-side device.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
2026-09-11 docs(hardware): fill section 5 (CAN transceiver) verification rows
    Row 5.1 (GO/NO-GO) PASSES: TJA1042 Table 4 p.5 defines Standby + RXD LOW as
    "wake-up request detected", and section 7.1.2 states "When pin RXD goes LOW to
    signal a wake-up request, a transition to Normal mode will not be triggered
    until STB is forced LOW". Works on VIO alone with VCC off. Two constraints
    recorded: bus dominant time-out resets RXD HIGH after tto(dom)bus (0.3-5 ms),
    so the LOW is not latched; RXD is push-pull, not open-drain.
    All four rows PASS. 5.3 passes with no margin: ICC standby max 5 uA (/3
    version) + IIO standby max 14 uA = 19 uA against a 20 uA criterion, and only
    while TXD and STB are held HIGH throug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
2026-09-11 docs(spec): correct low-side candidate error, add mandatory 5 V rail
    Two factual corrections from Task 2b datasheet verification, both holding
    regardless of the pending architecture decision:
    - VNI8200XP was listed as a low-side switch candidate. It is a HIGH-side
    device (ST: "Octal high side smart power solid state relay") and was
    never valid for this function. Removed.
    - A 5 V rail is MANDATORY and was missing. TJA1042 VCC is 4.5-5.5 V; the
    "/3" suffix gives a VIO pin for 3.3 V logic, it does not make VCC 3.3 V.
    The earlier revision powered the transceiver from +3V3_ALW, which would
    not have worked. CAN transceivers with microamp standby and bus wake are
    essentially all 5 V pa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
2026-09-11 docs(spec): RGB stage to discrete FETs with per-channel current sense
    Row 1.1 failed category-wide, so the smart low-side switches lose their
    entire justification. Replaced with 12 discrete logic-level MOSFETs plus a
    diagnostic chain that actually works at 0.14 A: a 1 ohm shunt in each FET
    source leg, 12 sense nodes into a 16:1 analog mux, output to one ADC1 input.
    Delivers what the ICs could not -- true ON-state open-load detection, short
    detection, per-channel current telemetry -- for ~$3-6 in passives against
    $8-12 for two ICs that provided none of it. Protection rests on the
    per-string PTCs and boost current limit, which the design already had.
    Sampling is on-demand: a sense voltage on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
2026-09-11 hw: propagate discrete-FET RGB redesign into plan and README
    Spec change 99add32 rippled through the plan and the hardware README:
    - Plan gains a REVISION banner at the top so any later task reads the
    change before acting on stale text
    - Task 2 Section 1 criteria replaced: the octal-switch rows are gone,
    replaced by three part classes (MOSFET, sense resistor, 16:1 mux) with
    criteria aimed at what actually matters -- full enhancement at 3.3 V
    Vgs, and mux on-resistance/leakage not corrupting a 140 mV reading
    - Task 6 Step 3 rewritten for FETs + shunts + mux, including the
    requirement that mux inputs follow ChannelIndex order so diagnostics
    cannot blame the wrong corner
    - Task 7 c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
2026-09-11 docs(plan): add 5 V regulator verification criteria
    The 5 V rail was added to the spec but had no Task 2 criteria section. Its
    quiescent current lands directly in the sleep budget, since the rail must
    stay up in deep sleep for the transceiver to monitor the bus.
2026-09-11 docs(hardware): replace Section 1 with 1a MOSFET verification, preserve old rows in appendix
    Octal smart low-side switches are superseded by discrete MOSFET + shunt + mux
    per the 2026-09-11 redesign. Moves the old, already-verified Section 1 rows
    (evidence for row 1.1's category-wide FAIL) to an appendix instead of deleting
    them. Fills in 1a (logic-level N-MOSFET, Nexperia PMV60ENEA) against real
    datasheets; 1b and 1c remain as criteria-only stubs for the next commits.
2026-09-11 docs(hardware): fill Section 1b (sense resistor) verification rows
    Yageo RC2512FK-071RL (1 ohm, 1%, 1W/2W, +/-200ppm/C) verified against the
    Yageo RC_L series datasheet. All three rows PASS with real figures.
2026-09-11 docs(hardware): fill Section 1c (analog mux) verification rows
    TI CD74HC4067 verified against its full datasheet: channel count, 3.3V
    operating range, matching, and settling time all PASS with real figures. The
    critical rows 1c.3 (on-resistance) and 1c.4 (off-leakage) are UNVERIFIED — the
    datasheet only characterizes RON/leakage at VCC=4.5V and 6V, never at 3.3V, and
    CMOS switch RON is known to rise as VCC drops. ADG706 (ADI) is recorded as a
    promising but unconfirmed alternative (datasheet fetch blocked; only a 5V-only
    spec table was readable via a text mirror). The brief's "MAX4617 family"
    suggestion is screened out as not actually 16:1.
2026-09-11 docs(hardware): add and fill Section 4b (5V regulator) verification rows
    Section 4b did not previously exist in this file (only in the task brief's
    example). Inserted between Section 4 and Section 5, proposing TI LM5164
    (same low-IQ buck family as Section 4) configured for 5.0V output to feed the
    TJA1042's VCC. All five rows PASS against the real datasheet: 10.5uA typ sleep
    IQ (row 4b.1, dominant sleep-budget lever), 6-100V input range, 1A/1.25A
    output capability, explicit no-load stability testing, and CISPR 25 Class 5
    EMI compliance evidence for the buck-vs-LDO trade-off.
2026-09-11 docs: relax MOSFET gate-drive criterion, harden the mux requirement
    Two outcomes from Task 2c verification.
    Row 1a.2 relaxed -- my criterion was wrong, not the parts. "Fully enhanced at
    Vgs = 3.3 V" suits an amperes-level load; this channel carries 0.14 A. At a
    pessimistic 1 ohm Rds(on) that is 140 mV and 20 mW against 24 V of headroom,
    and the design deliberately inserts a 1 ohm sense resistor in the same leg, so
    a fraction of an ohm from the FET is the same order as a part chosen on
    purpose. The strip sets the current via its own ~171 ohm internal resistance,
    so 1-2 ohm of series resistance shifts it under 1 percent. Nothing here needs
    low Rds: not heat, not headroom, not current accuracy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
2026-09-12 hw: re-verify 1a.2/1a.4 (MOSFET) and 1c (mux) against revised 3.3V criteria
    - 1a.2/1a.4: PMV60ENEA and PMV30ENEA both fail revised VGS(th)-max<=2.0V
    criterion (max 2.5V in both datasheets). Switched recommendation to
    Infineon IRLZ44NPbF (VGS(th) max 2.0V exactly); traced Fig.1 output
    characteristics via calibrated pixel measurement to confirm Id>=0.5A
    at Vgs=3.3V/Vds<=0.5V (reads ~13-20A, large margin). 1a.4 now PASSes
    with real derived RDS(on) bound (~21mW vs 50mW ceiling).
    - 1c: CD74HC4067 excluded per new hard requirement. ADG706 (the brief's
    suggested target) re-verified directly against its own datasheet and
    found to FAIL 1c.2 - its specifications table has only a 5V colum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
2026-09-12 hw: verify section 2 (BTS7008-2EPA dual PROFET+2 high-side switch)
    All 7 rows verified against Infineon BTS7008-2EPA datasheet Rev 1.21
    (2024-07-29). PASS on current (7.5A nominal vs 3.3A), sense ratio
    (documented at 2.8A/5.5A bracketing 3.3A), 3.3V logic compatibility
    (explicit datasheet statement + threshold table), PWM timing (210us
    worst-case transition vs 6.67ms period at 150Hz), protections, and
    sleep current (0.6uA vs 20uA ceiling). Row 2.6 (RDS(on) power) PASSes
    at 25C typical (196mW) but FAILS at 150C worst-case max (349mW vs
    250mW ceiling) - flagged as a real thermal-margin question for the
    Task 3 layout pass, not a datasheet gap.
2026-09-12 hw: verify section 3 (LM5122-Q1 synchronous boost controller)
    Verified against TI LM5122-Q1 datasheet SNVSAW9 (June 2017). PASS on
    input range (4.5-65V vs 40-60V needed), synchronous/external-FET
    topology, and enable-via-UVLO (0V/3.3V logic cleanly straddles the
    0.4V/1.2V thresholds, no level shifter needed). FAIL on row 3.4:
    no spread-spectrum/dither feature exists anywhere in the datasheet
    text (checked all 50 pages). Row 3.5 PASSes on typical shutdown
    current (9uA) but not guaranteed max (17uA) - noted that the
    upstream P-FET disconnect (row 6.1) satisfies the criterion's "or
    gated externally" alternate regardless. Row 3.2's >=94% efficiency
    number and row 3.6's FET dissipation are both U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
2026-09-12 hw: verify section 4 (LM5164 buck for 3.3V rail)
    Same physical IC already verified in Section 4b for the 5V rail
    (TI LM5164, SNVSAU4D). All four rows carry over the same datasheet
    evidence (10.5/25uA sleep IQ, 1/1.25A load current, 6-100V input
    range, documented no-load stability) since only the feedback divider
    changes between the 3.3V and 5V configurations. Confirms the design
    simplification of using one qualified part for both low-power rails.
2026-09-12 hw: verify section 6 (discretes: P-FET, TVS, PTC, Schottky, inductor)
    - 6.1 P-FET (Vishay SQJ415EP, 40V PowerPAK SO-8L): FAILS both
    sub-criteria - RDS(on) 11.5/14.0 mOhm typ/max exceeds the 10 mOhm
    ceiling, and native VGS rating (+-20V) is short of the 24V
    transient requirement. Closest candidate found within effort cap;
    flagged for further search or parallel-FET/zener mitigation.
    - 6.2 TVS (SMBJ24A): PASS, sourced from corroborated distributor
    parametric data after 3 primary-PDF fetch attempts failed
    (Bourns/Littelfuse 403, ST timeout) - flagged for a human to
    verify against an opened manufacturer PDF.
    - 6.3 PTC (Littelfuse 1206L050/24WR): PASS with boundary note (trip
    spec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
2026-09-12 hw: complete sleep-budget roll-up with honest uncertainty flagging
    Known/verified contributors (ESP32+EXT0 10uA, CAN 19uA max, buck x2
    21/50uA typ/max, PROFET 0.6uA max) sum to ~51-81uA - comfortably
    under the 200uA target on their own.
    Flags the two open contributors plainly rather than averaging them
    away: the 12x RGB-channel FET OFF-state leakage has no verified
    figure at this design's actual 24V rail (only a 25uA-max-at-55V
    number exists, a likely-inflated proxy that gives a 300uA pessimistic
    upper bound across 12 channels), and the P-FET gate-divider leakage
    depends on a Task 3/4 resistor value not yet chosen. Pessimistic
    total (~405uA) stays under the 500uA ceiling but would exceed th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
2026-09-12 hw: complete final BOM decision table
    One named manufacturer part number per function, with package, unit
    price and stock, sourced from live Digi-Key page fetches where
    possible (RGB FET, mux, PROFET, boost controller, buck, PTC) and
    flagged as search-summary sourced where a live page fetch could not
    be completed within the effort cap (sense resistor, CAN transceiver,
    TVS, Schottky, boost inductor).
    P-FET (row 6.1) is left explicitly unfilled rather than naming a
    part that fails its own criteria - SQJ415EP was the closest
    candidate but exceeds the 10 mOhm RDS(on) target and falls short of
    the 24V VGS requirement.
    Flags a real open question on the mux: ADG726BSUZ's Digi-Key listing
    describe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
2026-09-12 docs(plan): withdraw arbitrary Vgs(th) gate, add package and leakage criteria
    Ruling 15. The Vgs(th) max <= 2.0 V gate was itself an arbitrary proxy and it
    drove a bad selection: it rejected SOT-23 candidates in favour of an IRLZ44N
    in TO-220, a 55 V / 47 A through-hole power brick, to switch 0.14 A.
    - 1a.2 now asks directly for evidence of >=0.5 A conduction at Vgs <= 3.3 V,
    with no Vgs(th) threshold imposed
    - 1a.7 added: small SMD only, power packages excluded
    - 1a.8 added: off-state leakage <=2 uA per device at 24 V. This is what blew
    the sleep budget; the power FET's 25 uA x 12 gave a ~405 uA bound, while a
    SOT-23 part is typically ~1 uA. The package fix repairs the budget too.
    -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
2026-09-12 hw: fix round 1, finding 1 - revert MOSFET to PMV60ENEA (SOT23)
    Ruling 15 withdrew the Vgs(th)<=2.0V gate as an arbitrary proxy that
    wrongly rejected SOT-23 parts in favor of a TO-220 power brick for a
    0.14A load. Re-verified PMV60ENEA (primary) and PMV30ENEA (equal
    alternate) against the revised 1a.2 (direct evidence of >=0.5A at
    <=3.3V, no threshold) plus new 1a.7 (small SMD, TO-220 excluded) and
    1a.8 (Idss<=2uA at 24V). Both SOT-23 parts pass every row - 1a.2 read
    qualitatively from Fig.6 ("well above 0.5A") per the coordinator's
    guidance against false precision from pixel-measuring a rendered
    graph; 1a.8 passes via a physically-justified upper bound (the
    datasheet's own 1uA-max-at-40V fi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
2026-09-12 hw: fix round 1, finding 2 - recompute sleep budget with PMV60ENEA leakage
    12x PMV60ENEA leakage bounded at <=1uA max each (from the datasheet's
    own 40V IDSS figure, a valid upper bound for our lower 24V operating
    point) gives 12uA total instead of the previous ~300uA pessimistic
    estimate from the withdrawn IRLZ44N. New total: ~63-117uA, a
    confirmed PASS against both the 200uA target and 500uA ceiling. Also
    updated the BOM RGB-FET row to PMV60ENEA.
2026-09-12 hw: fix round 1, finding 3 - P-FET passes with Zener clamp + relaxed 20mOhm
    SQJ415EP re-judged with the spec-4.2 gate-resistor+Zener clamp in
    circuit (gate never sees the full rail, so the native +-20V VGS
    rating is adequate) and the relaxed 20mOhm RDS(on) ceiling (realistic
    VGS=-10V drive gives 11.5/14.0mOhm typ/max, under the new ceiling
    with margin). Computed and reported dissipation at both feeds: Feed A
    (3.9A) 0.175/0.213W typ/max, Feed B (6.6A) 0.501/0.610W typ/max -
    both well inside the part's 45W package rating, ~43C worst-case
    temperature rise via RthJA=70C/W. Filled the P-FET BOM line
    (SQJ415EP-T1_GE3, 19,148 in stock at Digi-Key, live fetch).
2026-09-12 hw: fix round 1, finding 4 - row 3.4 passes via LM5122-Q1's SYNCIN pin
    The relaxed criterion accepts an external SYNC/dither input or a
    documented EMC mitigation plan in place of native spread-spectrum.
    LM5122-Q1 has a genuine, documented SYNCIN/RT pin (datasheet p.4/7)
    that accepts an external synchronization clock up to 1MHz - this
    satisfies the relaxed wording directly. No on-chip spread-spectrum
    generator exists (unchanged finding), but that's no longer required.
2026-09-12 hw: fix round 1, finding 5 - restore ADG706 as mux, real 3V table found
    Previous FAIL verdict for ADG706 rested on an incomplete radiolocman
    mirror preview. Fetched the complete genuine ADG706/ADG707 primary
    datasheet (Rev A, 2002, via a Farnell PDF mirror, parsed page-by-page
    with PyMuPDF - 12 real pages including three full spec tables). It
    DOES carry a dedicated "SPECIFICATIONS (VDD=3V+-10%)" table on page 3
    with real numbers: RON 6/11-12 Ohm typ/max, leakage <=1.5nA max,
    match 0.4/1.2 Ohm, tTRANSITION 45/75ns - all read directly, all rows
    now PASS. Pin configuration and truth table confirm single 16:1, 4
    address lines (A0-A3), 28-lead TSSOP, orderable as ADG706BRU/ADG706BRUZ.
    Replaces th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
2026-09-12 docs: revise thermal budget to 4.3 W on real datasheet figures
    Task 2's verified figures replace my estimates. The P-FET line rose from an
    estimated 0.30 W to 0.82 W worst case (20 mOhm ceiling at Feed B's 6.6 A:
    0.61 W, plus 0.21 W on Feed A), and the sense resistors contribute 0.24 W.
    Total ~4.3 W, still well inside what the aluminium heat-spreader plate moves.
2026-09-12 hw(docs): staged bring-up procedure with pass criteria and measurement tables
2026-09-12 hw(docs): quiescent rows carry prediction, requirement and ceiling
    A bring-up row needs all three numbers, because they do different jobs:
    87-117 uA is what the datasheet roll-up predicts this board draws, <200 uA is
    the design requirement, and >500 uA is where the parking strategy stops
    working. Collapsing them misleads both ways -- a 150 uA board reads FAIL
    against the prediction alone and sends someone hunting a defect that is not
    there, while against the requirement alone a 190 uA board looks healthy when
    some part is drawing double its datasheet figure.
    Stage 3 now states all three plus the per-contributor breakdown, and notes
    that 117-200 uA passes but warrants investigation.
    Stage 9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
2026-09-12 hw(docs): enclosure, heat-spreader plate, panel layout and harness spec
    Written by the controller rather than a subagent: dispatch was blocked by a
    platform session quota. NEITHER DOCUMENT HAS HAD AN INDEPENDENT REVIEW PASS.
    enclosure.md opens with a problem rather than a part number, because the
    thermal design does not close:
    - At the spec's 4.3 W, natural convection needs ~215 cm2 of dissipating area
    for the stated 25 K rise. A plausible 100x80 mm plate is 80 cm2, which puts
    the inside at ~107 C at 40 C ambient -- above the ESP32's 85 C limit. The
    spec's "65 C at 40 C ambient" silently assumed ~215 cm2 that was never
    checked against a real plate size.
    - Spec 9.3 also contradicts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
2026-09-12 hw: resolve thermal design — finned plate, metal-to-metal, rubber at frame
    User decision. Closes the open problem Task 10 surfaced and resolves spec
    9.3's self-contradiction.
    The numbers that forced it: at 4.3 W, natural convection needs ~215 cm2 of
    effective area for the stated 25 K rise. A flat 100x80 mm plate is 80 cm2 ->
    67 K -> ~107 C internal at 40 C ambient, above the ESP32's 85 C maximum. The
    spec's earlier "65 C at 40 C ambient" silently assumed roughly three times the
    area a flat plate of that footprint provides.
    Fins multiply effective area 3-5x for the same footprint. Requirements are now
    stated as area rather than a named profile: >=215 cm2 hard, >=300 cm2 target
    (~58 C, ~27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
2026-09-12 hw(docs): clarify finned-wall sizing is by footprint, and keep it off the antenna wall
    Two clarifications to the enclosure selection criteria:
    - The wall opening is sized by the plate's FOOTPRINT (>=80 cm2), not by the
    >=215 cm2 effective area -- the fins provide that outside the box. Stating
    it the old way would have driven an oversized enclosure.
    - The finned wall and the antenna wall must be different walls, ideally
    opposite: the plate is metal and would shadow the ESP32's onboard antenna if
    they shared a face. Consistent with Task 8, which already places the antenna
    edge away from the plate.
2026-09-12 hw: add datasheets folder with a traceability index
    Collected the datasheets the verification agents downloaded into
    hardware/datasheets/ so every PASS/FAIL verdict in part-selection.md can be
    traced to the document it was read from.
    The index records which parts were chosen, which were rejected and why. The
    rejected ones are kept deliberately: TLE8110ED and TLE75008 are the evidence
    for the largest design decision in the project -- that ON-state open-load
    detection does not exist in the multichannel smart low-side switch category --
    and PMV30ENEA matters because the chosen PMV60ENEA is backordered.
    The PDFs and PNGs are GITIGNORED, not published. They are third-party
    copyrighted documents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
2026-09-12 fix: all 5 Critical and 16 Important findings from the project review
    Plus new load information from the owner that changes the thermal case.
    CRITICAL
    - C1 PROFET pin allocation was unbuildable. The BTS7008-2EPA has ONE
    multiplexed IS output selected by DSEL, which appeared in no pin table, net
    contract or bias table, while two ADC inputs were reserved. Channel B sense
    could never have worked. DEN_DSEL -> GPIO 33, ISNS_DEN -> GPIO 34, GPIO 39
    released. Fixed in all three pin tables plus Task 5/6/9 text.
    - C2 IGN_SENSE floated on a wake source. GPIO 34-39 have no internal pulls and
    the divider is DNP, so EXT1 ANY_HIGH was armed on a high-impedance node: the
    board would wake on no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
2026-09-12 feat: revert to a single 12 V feed, drop the second connector and fuse
    Owner decision, enabled by the operating-mode information in spec 2.4: the
    loads never coincide, so the 10.5 A arithmetic sum is an envelope no steady
    state occupies.
    daytime 3.9 A (39% of the 10 A feed) -- corners white, Denali off
    night 7.8 A (78% -- the governing case) -- Denali on, front DRLs off
    transient 10.5 A (105%, seconds) -- flash-to-pass in daylight
    The transient is harmless: an ATO blade fuse at 105% effectively never opens,
    needing roughly 135% for minutes, and a 10 A contact carries 10.5 A briefly
    without distress.
    One 10 A fuse replaces the 7.5 A / 10 A pair. 10 A is the only value that
    cle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
2026-09-12 fix: re-review round 2 — all 4 Criticals and the residual dual-feed text
    The re-review's diagnosis of my method was right and is the real lesson: I had
    fixed per-finding rather than per-document, so corrected figures sat two
    paragraphs above the stale ones they replaced. Spec 9.1 and 9.4 are now
    REWRITTEN WHOLESALE rather than patched.
    CRITICAL 1 - spec 9.1's ASCII panel still drew PWR A + PWR B + a 7.5 A fuse,
    eleven penetrations, immediately above prose saying nine. A panel drilled from
    it would have been scrap and a 7.5 A fuse opens on the first night ride at
    7.8 A. Section rewritten with a nine-row penetration table matching
    enclosure.md.
    CRITICAL 2 - plan Task 3 still PRODUCED VBAT_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
2026-09-12 fix(hardware): PTC row 6.3 confirmed FAIL family-wide, no 1206L substitute
    Opened hardware/datasheets/Littelfuse_1206L_PTC_series.pdf and actually
    applied the temperature-derating table (p.2) this pass. 1206L050/24 holds
    ~0.31 A at 65 degC (interpolated between the datasheet's 60C/70C columns)
    against the 0.42 A sustained daytime load per string -- a real shortfall,
    not just at the previous rough 0.25-0.30 A estimate.
    Checked every 1206L part number rated Vmax >= 24 V against the family
    table: 1206L050/24 is already the highest-hold-current member that clears
    24 V. Every higher-current 1206L variant drops to <= 16 V. The family
    cannot meet the requirement at 24 V regardless of which part is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
2026-09-12 fix(hardware): TVS row 6.2 stays UNVERIFIED, both local "datasheet" files are wrong
    Actually opened both hardware/datasheets/SMBJ24A_TVS.pdf and
    SMBJ_series_TVS.pdf this pass instead of trusting the filenames.
    Neither is an SMBJ-series TVS electrical datasheet:
    - SMBJ24A_TVS.pdf is a Diodes Incorporated wafer-fab-diameter PCN
    (PCN-2524, Oct 2021) that only lists "SMBJ24A-13-F" in a table of
    affected part numbers, with zero electrical characteristics.
    - SMBJ_series_TVS.pdf is a Powerex POW-R-BLOK CD42/CD47 dual SCR/diode
    module datasheet (40A/1800V phase-control module) -- an unrelated
    part family entirely.
    Made 4 further attempts at a genuine primary datasheet this session
    (Mouser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
2026-09-12 fix(hardware): resolve MOSFET sourcing position, PMV30ENEA second source
    Row 1a.6 (stock) re-checked live against Digi-Key this pass:
    PMV60ENEAR is 0 in stock with 3,000 units expected 18-Jan-2027 and a
    30-week manufacturer lead time (more precise than the previous
    "backorder to Jan 2027"). TTI's previously-reported ~9,000-unit figure
    remains distributor-search-sourced and still unconfirmed firsthand.
    Added a formal second-source qualification table for PMV30ENEA against
    this task's specific criteria (Vds>=40V, Id>=1A, Id>=0.5A at Vgs<=3.3V,
    Idss<=2uA at 24V, SOT-23 package). The one criterion answerable from a
    file actually in this repo -- the Fig. 6 output-characteristics curve --
    was ind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
2026-09-12 fix(datasheets): retract the false "easy win" claim about the TVS PDF
    I claimed SMBJ24A_TVS.pdf was a genuine 268 KB SMBJ24A datasheet and that
    opening it would close row 6.2. That was wrong, and I made it from the file
    size and a valid PDF header without reading the contents -- exactly the kind of
    unverified assertion this record exists to prevent.
    On actually opening them: SMBJ24A_TVS.pdf is a Diodes Inc. wafer-fab
    process-change notice with no electrical specifications, and
    SMBJ_series_TVS.pdf is an unrelated Powerex SCR/diode module datasheet.
    Row 6.2 stays UNVERIFIED. Nine fetch attempts across two sessions have failed
    with 403s and timeouts, so closing it needs a human with a browser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
2026-09-12 fix(datasheets): correct the PTC and second-source rows
    The PTC row still said PASS; it now FAILS family-wide, and this PDF is the
    evidence -- its own p.2 derating table puts the best 24 V-rated 1206L part at
    0.31 A at 65 degC against a 0.42 A sustained load.
    The PMV30ENEA row claimed it was useful because the PMV60ENEA is backordered.
    It qualifies technically but is ALSO backordered at Digi-Key and unavailable at
    Mouser, so it does not relieve the sourcing problem.
2026-09-12 fix: round-3 review — EN_DIAG bias, settle time, broken tables, plan drift
    Round 3 confirmed most of the chain now holds (pin tables, net names, feed
    currents, sleep total, plate areas all verified arithmetically). It found one
    new defect that would have been board rework, one real firmware constraint, and
    a coherent class of drift.
    NEW, would have been board rework -- EN_DIAG had no passive default in any of
    the three biasing tables. The PROFET reaches its 0.6 uA Sleep mode only when
    ALL of INn/DEN/DSEL are low, and GPIO 27 is not RTC-capable, so it floats in
    deep sleep. The 8.2 budget's PROFET line silently depended on a pin nothing
    held low, and bring-up Stage 1 checked every other ena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
2026-09-12 feat(hw): draft power_input sheet -- fused, reverse-protected, filtered 12V input
    Single 12 V feed -> 10 A fuse -> P-FET reverse-polarity block -> Zener/TVS clamp
    -> pi filter -> VBAT, with a Schottky to VLOGIC_IN. Authored as text; every
    lib_symbols entry extracted verbatim from the stock KiCad 10 libraries.
    P-FET orientation is deliberate and is the opposite of the plan's Task 3 prose:
    DRAIN faces the fused side, SOURCE faces the load (VBAT_PROT). A P-channel body
    diode conducts drain->source, so this orientation is self-starting (the body
    diode pulls VBAT_PROT up, R1 holds the gate near GND, Vgs ~= -11.4 V) and blocks
    the reverse path. Wired the other way, reverse polarity passes straigh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
    [power_input.kicad_sch]
2026-09-13 fix(hw): give each sheet symbol its project/page instance block
    The root schematic's four sheet symbols had NO (instances) block at all --
    not a malformed one, as first reported. KiCad 7+ expects every sheet symbol to
    declare its project and page:
    (instances (project "mccan" (path "/" (page "N"))))
    Without it, sheet_instances carried only the root's own (path "/" (page "1"))
    and the four children had no page assignment, which is why running
    "kicad-cli sch upgrade" rewrote the file and reordered the sheets: KiCad was
    regenerating what was missing.
    Pages are assigned in DESIGN-FLOW order rather than canvas position:
    power_input 2, rails 3, mcu_can 4, outputs 5. The canvas layout already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
    [mccan.kicad_sch]
2026-09-13 docs(spec): CM choke ordering and the GND_IN/GND split rule
    Answers where the common-mode choke belongs and records the consequence that
    gets broken in practice.
    Ordering: connector -> fuse -> reverse FET -> TVS -> CM choke -> pi filter ->
    bulk. Each position is forced, not preferential:
    - Reverse FET before the TVS is MANDATORY. The SMBJ24A is unidirectional, so in
    reverse polarity it is just a forward-biased diode; ahead of the FET a
    reversed battery drives enormous current through it and destroys it.
    - TVS before the choke, because surge clamping degrades with series inductance
    between the entry point and the clamp, and a choke is deliberately inductive.
    - Choke before the pi filt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
2026-09-13 feat(hw): add the CM choke to power_input and split the ground net
    Order is fuse -> reverse-polarity FET -> TVS -> CM choke -> pi filter -> bulk.
    The TVS precedes the choke because surge clamping degrades with series inductance
    between the entry point and the clamp; the choke precedes the pi filter because
    the common-mode noise being blocked originates inside the board (the boost
    converter), so the choke belongs between the switcher and the harness.
    New parts:
    L2 Device:L_Coupled, "CM choke" -- pins 1/2 = winding A (feed),
    pins 3/4 = winding B (return)
    R2 0R link across winding A
    R3 0R link across winding B
    Fit EITHER L2 OR R2+R3. The links give the simple tied-ground case fo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
    [power_input.kicad_sch]
2026-09-13 fix(hw): align power_input child page number with the root (1 -> 2)
    Task 1's scaffold wrote page 1 into power_input's own sheet_instances while
    giving rails/mcu_can/outputs 3/4/5. The root's per-sheet instances blocks
    (added in d829e26) assign power_input page 2, so the child disagreed with the
    root while the other three agreed.
    Cosmetic -- the root is authoritative and kicad-cli sch upgrade reported no
    change either way -- but a mismatch in page numbering is the kind of thing that
    produces confusing printouts and invites a 'fix' later.
    [power_input.kicad_sch]
2026-09-13 chore(hw): adopt KiCad's canonical files after first GUI open
    You opened the project in KiCad and it rewrote the hand-authored files into its
    own canonical form. Verified equivalent before committing: the power_input
    netlist is UNCHANGED net-for-net -- all nine nets identical, and GND_IN and GND
    are still genuinely separate with an empty intersection. Nothing was lost in a
    3106-line reformat.
    CORRECTION TO MY EARLIER CHANGE (d829e26). I added per-sheet (instances) blocks
    to the root schematic and concluded they were canonical because
    "kicad-cli sch upgrade" round-tripped them byte-identically. The GUI disagrees:
    on open, KiCad stripped all four blocks and kept only the root's own
    (sheet_ins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
    [mccan.kicad_sch, mcu_can.kicad_sch, outputs.kicad_sch, power_input.kicad_sch, rails.kicad_sch]
2026-09-13 hw: add LM5122QMHX_NOPB as a project-local symbol library
    You downloaded the SamacSys part, but it landed in a form KiCad could not use
    for this project, for two reasons:
    1. LEGACY FORMAT. The file was "EESchema-LIBRARY Version 2.3" (.lib), the
    KiCad 5 format, not a modern .kicad_sym.
    2. NOT REGISTERED, AND THE REGISTERED ONE IS A DIFFERENT FILE. Your global
    sym-lib-table points "SamacSys_Parts" at
    C:/KiCad Libraries/SamacSys_Parts.kicad_sym, whereas the download went to
    OneDrive/Documents/SamacSys_PCB_Library/KiCad/. The registered library does
    not contain LM5122, so the symbol would not have appeared in the picker.
    Converted with "kicad-cli sym upgrade" and committed to th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
2026-09-13 hw(parts): derive boost power-stage requirements from this design's equations
    Row 3.6's FETs were unselected and the inductor peak current was a scaled
    estimate borrowed from the LM5122 datasheet's 108 W worked example. Both are
    now computed from this design: Vin 12 V, Vout 24 V, D = 0.50, Iin 5.43 A,
    inductor peak 6.25 A, 3.84 A RMS per FET at the 60 W design point.
    That supersedes the 7.5 A scaled figure and CLOSES row 6.5's caveat: the
    candidate XAL7070-682ME has 2.0x Isat margin, not the 1.7x claimed against a
    borrowed number.
    FET requirements, both positions, same part number for both: Vds >= 40 V,
    Id >= 10 A, Rds(on) <= 20 mOhm AT Vgs = 7.5 V, Qg <= 20 nC, thermal-pad
    package. The ga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
2026-09-13 feat(spec): RGB load is ~4x smaller than assumed -- amend the design
    The strips are BTF-LIGHTING COB RGB, 24 V, IP66, ~6 cm per corner (12 cm if 6
    proves too dim). The design assumed 20 W/m x 0.5 m = 10 W per corner. On a
    conservative 20 W/m x 12 cm basis a corner draws 2.4 W and all four 9.6 W,
    against 40 W budgeted. Every downstream figure moves.
    THE ONE THAT WAS A DEFECT -- the sense shunt is resized 1 ohm -> 10 ohm. The
    chain was sized for 140 mA per channel; the real current is 10-33 mA, which
    across 1 ohm is 10-33 mV, down among ADC offset and noise where "open" and
    "working" are indistinguishable. The diagnostics would have appeared to work
    and silently mis-classified. At 10 ohm the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
2026-09-13 hw: add LM51571-Q1 symbol and WQFN-16 footprint to the project libraries
    Converted the Ultra Librarian download from KiCad v6 (version 20211014, CRLF,
    space-indented) to the current format with kicad-cli sym upgrade, then merged
    the symbol into the project-local library. The footprint RTE0016K (WQFN-16,
    3x3 mm) goes into a new project-local hardware/footprints/mccan.pretty,
    registered via hardware/fp-lib-table with ${KIPRJMOD} so the path is relative.
    Same reasoning as the LM5122 symbol: once the design depends on downloaded
    library parts it stops being reproducible from stock libraries alone, so they
    travel with the repo rather than living on one machine.
    Pins: PGND(1,16) VCC(2) BIAS(3) P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
2026-09-13 feat: replace the boost with LM51571-Q1, verified from a local datasheet
    First part on this project verified without fetching anything -- the datasheet
    is in hardware/datasheets/lm51571-q1.pdf.
    The RGB load falling from 40 W to ~8 W made a controller-plus-external-FETs
    topology the wrong shape. Every criterion improved:
    switch 2 external FETs -> integrated 50 V / 4.33 A (5.4x margin)
    input rating needed checking -> 2.9-45 V op, 50 V abs, transient to 50 V
    shutdown IQ 9 typ / 17 max uA -> <= 2.6 uA
    spread spec. none (relaxed) -> dual random, built in
    qualification -Q1 -> AEC-Q100 grade 1
    package controller + 2 FETs -> WQFN-16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
2026-09-13 docs: finish propagating the RGB load and boost swap
    Mechanical follow-through across every remaining document.
    part-selection: shunt rows 1b.1-1b.3 to 10 ohm (the >=1 W / 2512 requirement
    withdrawn -- 7 mW normally, and a shorted channel is limited to ~0.5 A by the
    boost until the PTC opens); row 6.3 REVERSED from a hard family-wide FAIL to
    PASS, since the real 0.08 A per string against 0.31 A hold at 65 degC is a 3.9x
    margin; BOM rows for the sense resistor, PTC, LM51571-Q1, the new Schottky
    rectifier, and the external FETs marked NOT REQUIRED.
    plan Global Constraints: per-channel 0.14 A -> 26.7 mA, per string 0.42 A ->
    80 mA, feed 3.9/7.8 -> 1.0/7.0 A, dissipation 4.5 W -> 1.9 W with NI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
2026-09-13 hw(parts): every remaining part selected, all from local datasheets
    First round on this project where every figure came from a document on disk
    rather than a blocked fetch. Eleven functions now have a named, verified part.
    TWO SELECTIONS FIXED SPECIFIC DEFECTS:
    SQJ461EP replaces SQJ415EP. With the TVS clamp now MEASURED at 38.9 V rather
    than estimated, the 415EP's 40 V rating left 1.1 V (2.8%) of margin on the part
    that sees every transient the vehicle produces. The 461EP's 60 V gives 21.1 V
    (54%). Same PowerPAK SO-8L footprint, same family, so the layout is unchanged;
    dissipation moves only 0.61 -> 0.78 W.
    NX5020UNBKS is specified AT the gate voltage actually used. Every earlier
    candidat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
2026-09-13 hw(parts): adopt DML3017LDC for the switched 3.3 V rail
    Verified from the local datasheet. EN is ACTIVE-HIGH WITH AN INTERNAL PULLDOWN,
    which is the whole point: a bare P-channel high-side switch inverts the logic
    (source at +3V3_ALW, so GPIO low turns it ON), meaning the mandatory pulldown
    on EN_3V3SW would have made floating = RAIL ON -- the opposite of the
    passive-default rule the biasing table exists to enforce. The discrete design
    needed an N-FET inverter purely to correct that. This part does not have the
    trap, and its internal pulldown holds the safe state even if the external
    resistor lifts.
    ISTBY 0.1 uA typ / 1 uA max against an 85-100 uA sleep budget. The 150 uA
    dynamic figure app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
2026-09-14 hw(rails): finish the rails sheet and fix four defects found on review
    The drafting agent's topology was sound but it stopped before finishing, and
    verification against the primary datasheets turned up four real problems.
    Constant-on-time loop had no ripple to work with. The LM5164 needs >= 20 mV of
    ripple AT FB (datasheet 6.2); an all-ceramic output stage with a feedforward cap
    delivered ~3 mV, a 6.5x shortfall. Replaced with the datasheet's Type-3
    injection network on both rails, sized from equations 24-26 and checked against
    the >= 12 mV at minimum VIN criterion. Chosen over adding series ESR because
    the ADC sense chain runs off these rails.
    Both enables were missing their mandatory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
    [mccan.kicad_sch, rails.kicad_sch]
2026-09-14 hw(sch): ESP32-WROOM-32E-N8, TJA1042 listen-only, prog header (Task 5)
    The mcu_can sheet, with every net verified from the exported netlist rather than
    from the drawing. All 24 GPIO assignments match the plan's Global Constraints
    table pin for pin.
    Listen-only is structural, not a setting. The netlist shows GPIO 17 reaching
    only R23, and the transceiver TXD reaching only R23 and its pull-up, so the DNP
    0 ohm link is the single conductive path and a board built to the BOM cannot
    assert a dominant bit on the vehicle bus.
    The transceiver's two supplies are deliberately split: VIO on +3V3_ALW keeps the
    receiver alive so bus traffic still pulls RXD low for EXT0 wake, while VCC on the
    switched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
    [mccan.kicad_sch, mcu_can.kicad_sch]
2026-09-14 spec: correct the supply premise - the Experia feed is ignition-switched
    Section 8.2 read "Permanently battery-connected, so quiescent draw is a
    first-class requirement." The user confirms that is not true of the reference
    bike: the Experia's peripheral connector supplies the unit when the bike is on
    and nothing when it is off. Parked, the board is UNPOWERED, not asleep, so the
    85-100 uA budget never applied to it.
    Rather than strip the sleep hardware out, the board is now documented as a
    superset serving two topologies: A, switched feed (the Experia), and B, permanent
    battery feed plus an ignition-sense wire on IGN_IN. Under A the sleep path
    simply never executes and the switched rails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
2026-09-14 hw: J1 to 3-way, IGN_IN on cavity 1 for the battery-feed topology
    The Experia's peripheral outlet closes all 12 V at shut-off, so the shipped build
    (topology A) needs no ignition signal at all. This provisions the third cavity
    so a battery-fed installation (topology B) is a harness change plus populating
    R37/R38, rather than a new panel: Superseal 1.5 2-way and 3-way are different
    cutouts, so it could not have been retrofitted.
    The third cavity went ABOVE the existing two, not below. GND_IN drops vertically
    from pin 2 at x=31.75 down to y=101.6, so a pin placed below would have landed on
    that wire and shorted IGN_IN to ground. Placing it above left every existing
    wire, junction and net o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
    [mccan.kicad_sch, mcu_can.kicad_sch, power_input.kicad_sch]
2026-09-14 hw(scripts): repair the power_input generator, canonicalise all of them
    power_input was the one sheet with no working generator. Diagnosed rather than
    rewritten, and the cause turned out to be entirely cosmetic: the committed sheet
    had been saved from the KiCad GUI, and the generator predated that form. The
    whole 258-line delta was four fields it never emitted -
    (show_name no) x110 = 5 properties x 22 symbols
    (do_not_autoplace no) x110
    (body_style 1) x22
    (in_pos_files yes) x22
    less a sheet_instances/embedded_fonts block a child sheet does not carry
    110 + 110 + 22 + 22 - 6 = 258, exactly. Plus two orderings the GUI imposes:
    top-level elements grouped by t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
    [mccan.kicad_sch, mcu_can.kicad_sch, power_input.kicad_sch, rails.kicad_sch]
2026-09-15 hw(sch): outputs sheet - schematic capture complete, ERC clean (Task 6)
    PCA9685, 12 RGB switching channels with sense shunts, the 16:1 mux and its
    sense-path protection, the dual PROFET, four PTCs and the six panel connectors.
    164 symbols. This completes schematic capture.
    The gate the plan sets for this task is met: kicad-cli sch erc --severity-all
    --exit-code-violations returns exit=0 with 0 errors and 0 warnings across all
    five sheets. Every unconnected pin is either connected or no-connect flagged.
    ChannelIndex order verified from the netlist rather than the drawing, because
    getting it wrong silently scrambles colours and corners against firmware that is
    already written: LED0->PWM_FL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
    [mccan.kicad_sch, outputs.kicad_sch]
2026-09-15 hw(sch): PROFET verified against the real datasheet, Task 8 unblocked
    The Infineon BTS7008-2EPA datasheet (Rev. 1.21, 2024-07-29) arrived, so U9's
    placeholder pinout could finally be checked. It was wrong in every position.
    Table 2 p.6: VS is the EXPOSED PAD -- there is no side supply pin at all -- and
    each output is three pins (8-10 OUT1, 12-14 OUT0) that note 1 requires to be
    tied together and to carry the full channel current. Pins 7 and 11 are not
    bonded. Six pins that did not exist in the placeholder exist in the part.
    R81 is sized: kILIS = 5400 at 2.8 A, so the Denali's 3.3 A gives 611 uA at IS,
    and 2.2k puts that at 1.34 V -- mid-scale for ADC1 at 11 dB, full scale at
    6.0 A, floor a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
    [outputs.kicad_sch]
2026-09-18 hw(sch): Task 7 schematic review - three defects found and fixed
    Every spec requirement traced to a sheet and refdes, read back from the
    exported netlist rather than the drawing. 29 of 31 rows PASS; two carried
    forward. Full write-up in hardware/docs/schematic-review.md.
    F1 - Q1 carried the superseded SQJ415EP. That part was replaced by the
    SQJ461EP on 2026-09-13 precisely because it is a 40 V device and the
    SMBJ24A clamps at 38.9 V - 2.8% margin on the one part that sees every
    vehicle transient. The replacement reached part-selection.md and the spec
    but never the schematic, so a BOM built from it would have ordered the
    wrong FET. Also closes the open gate-drive question: D1/R1 put Vgs at
    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
    [power_input.kicad_sch, rails.kicad_sch]
2026-09-18 hw(docs): F5 resolved, row 6.2 closed from a datasheet already in the repo
    F5 — the owner's ruling: amend the spec rather than build the second feed's
    DNP footprints. Spec 4.4 rewritten (now "Single feed") and 2.2 updated; both
    state the board carries no second-feed provision and that restoring the
    domain split needs a respin. The domain-split material is kept as design
    rationale, marked as such. The plan repeated the old requirement in a dozen
    places, so it now carries an AMENDMENTS block listing every stale row, and
    Task 3 Steps 3-5 are formally withdrawn. The schematic is unchanged - it was
    already correct; the documents were behind. F5 no longer gates Task 8.
    Row 6.2 (the input TVS) i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
2026-09-18 hw(parts): five of six supplied datasheets land parts; L2 is the last blocker
    L1 - Vishay IHLP-4040DZ-01. Recommend the 1.5 uH part: DCR 5.80 mOhm max,
    Isat 27.5 A, 0.28 W at 7.0 A, inside F4's 8 mOhm budget. The 2.2 uH part is
    9.00 mOhm max and misses it by 12.5%, and the filtering difference is
    negligible - with C3 = 220 uF the corner moves 7.2 -> 8.8 kHz, still ~66 dB
    at 400 kHz. Caveat recorded: this is the COMMERCIAL series, no AEC-Q200
    anywhere in it, so order the automotive IHLP variant for a vehicle.
    L6 - TDK ACT45B-510-2P-TL003, 51 uH, matching the placeholder exactly.
    AEC-Q200, -40 to +150 C, CAN-BUS named as the application. NEEDED.md had
    suggested ACT45B-101-2P, which is the 100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
2026-09-18 hw(parts): L2 chosen - Bourns PM3700-10-RC - and F4 closes at 21.80 mOhm
    PM3700-10-RC is the only part in its series rated for the 7.0 A night load:
    0.2 mH min, DCR 0.008 Ohm max per winding, Irms 7.0 A, leakage 1.6 uH.
    Reading it needed the same care as the SMBJ table - pdftotext interleaves the
    dimension drawing with the parametric table and staggers the columns by two
    rows. The ordinal alignment was pinned from an invariant inside the document:
    the part-marking column is the EIA 3-digit inductance code and it matches the
    inductance column 8 for 8 (201 = 200 uH ... 203 = 20 mH). The Features line
    "Current rating up to 7 A" independently confirms the 7.0 A entry belongs to
    the first, lowes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
2026-09-18 hw(parts): Wurth WE-CMBNC 7448031002 is the better L2 - F4 gains real margin
    The nanocrystalline WE-CMBNC beats both ferrite candidates on every
    electrical axis and is the only AEC-Q200 part of the three: 2 mH (vs 0.2 mH),
    10 A rated, DCR 6.3 mOhm max, 2100 V AC insulation, AEC-Q200 Grade 1, -55 to
    +125 C. Nanocrystalline permeability is roughly 10x ferrite, so the same
    inductance needs far fewer turns - which is why it delivers ten times the
    common-mode inductance at three-quarters the resistance. That is a different
    technology, not a better ferrite.
    F4 gains margin for the first time. With L1 at 1.5 uH the sum falls from
    21.80 to 18.40 mOhm against the 22 mOhm ceiling - 16.4% margin inste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
2026-09-18 hw(sch): L2 = Wurth WE-CMBNC 7448031002, L1 = 1.5 uH - decision applied to the schematic
    Owner's call: the Wurth over the two ferrite candidates. It is the only
    AEC-Q200 Grade 1 part of the three and the only one that leaves the thermal
    budget real margin - 18.40 mOhm against F4's 22 mOhm ceiling (16.4%) versus
    21.80 mOhm (0.9%) for either ferrite, 0.90 W instead of 1.07 W, night total
    ~2.70 W against the plate's ~2.9 W.
    Applied to the DESIGN, not just the prose: layout_power_input.py now sets
    L2 = 7448031002 and L1 = 1.5uH, replacing the "CM choke" and "10uH"
    placeholders. This is exactly what finding F1 caught going wrong the other
    way - the SQJ461EP was chosen on 2026-09-13, recorded in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
    [power_input.kicad_sch]
2026-09-18 hw(sch): sweep every selected part into the schematic; D6+D7 become one PESD2CANFD24U-T
    Closes the gap the Task 7 review's finding F1 was about: parts chosen in
    prose had not reached the generators, which is exactly how the superseded
    SQJ415EP survived five days in the schematic.
    STRUCTURAL - the CAN ESD pair is now one part. D6 and D7 were two placeholder
    "24V bidir" discretes; the Nexperia PESD2CANFD24U-T is a single SOT23 holding
    both bidirectional elements (K1/K2/CC). New verified symbol in symlib.py built
    from Table 2 of the datasheet, added to gen_mcu_can's lib_symbols, and
    Device:D_TVS dropped from that sheet since D6/D7 were its only users.
    The two protected pins land exactly on th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
    [Wurth_WE-CMBNC_7448031002.stp, mcu_can.kicad_sch, outputs.kicad_sch, power_input.kicad_sch, rails.kicad_sch]
2026-09-18 hw(docs): correct the Wurth choke's height - ~24 mm, not ~17 mm
    I read 17.0 mm off the scrambled dimension drawing as the height when
    reporting the L2 comparison. It is a board-plane dimension. The vendor
    footprint and STEP model settle it: body 23.0 x 17.0 mm in the board plane
    (courtyard 25.0 x 19.65), 20.3 mm tall in the STEP with 6.0 mm of pin below
    and a 3.0 mm min standoff - consistent with the datasheet's '24,0 max.'
    So the part stands ~23-24 mm above the PCB against 11.5 mm for the Bourns and
    12.7 mm for the Coilcraft, about double rather than the marginal difference I
    reported when the choice was being made. Board-plane area is fine - 391 mm2
    against the Bourns' 384 - so the cost i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
2026-09-18 hw(pcb): Task 8 step 0 - footprints assigned, 209 of 219 verified
    Nothing in the project had a footprint except the PROFET's. Assignment now
    lives in one auditable place, scripts/fpmap.py, which the four sheet
    generators call when emitting each symbol's Footprint property. No generator
    chooses a footprint of its own any more.
    Three rules, and the reasoning is in the file rather than in a commit nobody
    will read again: signal passives are 0603; a passive gets a bigger package
    only for a stated reason; and nothing gets a footprint that has not been
    checked to exist.
    The reasons that drove a larger package:
    - R2/R3, the 0R links bypassing the input choke windings, are 2512. They are
    DNP, bu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
    [mcu_can.kicad_sch, outputs.kicad_sch, power_input.kicad_sch, rails.kicad_sch]
2026-09-18 plan: correct Task 8 Step 3 - night governs at ~2.70 W, and there are no boost FETs
    Step 3 reads '~3.8 W in daytime - 3.50 W boost + 0.30 W P-FET' and names
    'boost high-side and low-side FETs' in the thermal group. All of that predates
    the 2026-09-13 rewrite of spec 9.4.
    Current: NIGHT governs at ~2.70 W, not daytime at 3.8 W. The boost term fell
    from 3.50 W to 0.83 W daytime / 0.20 W night when the RGB load turned out to
    be ~4x smaller. There are no external boost FETs at all - the LM51571-Q1
    integrates the switch, which part-selection already records as VOID. And
    L1 + L2 dissipate 0.90 W of the 2.70 W while going unmentioned, because L2 did
    not exist when the plan was written.
    The group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
2026-09-19 hw(sch): CM chokes were wired to KiCad's pin numbering, not the parts'
    Both common-mode chokes used Device:L_Coupled, which numbers its pins
    winding A = 1-2, winding B = 3-4. Every real four-terminal CM choke numbers
    them winding A = 1-4, winding B = 2-3. Both parts in this design are real
    ones, so both were wired across the wrong pairs.
    L2 was the serious one. As drawn, winding 1-4 tied VBAT_PROT to board GND
    and winding 2-3 tied VBAT_F to GND_IN -- two dead shorts across the supply
    through 6.3 mOhm windings. First power-up would have cleared the 10 A fuse
    with the P-FET and the choke carrying the fault.
    L6 transposed CANH and CANL between the transceiver and the connector, so the
    boa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
    [mcu_can.kicad_sch, outputs.kicad_sch, power_input.kicad_sch]
2026-09-19 hw: F1 becomes a board-mount eFuse; panel becomes glands; spec 4.1 figures were stale
    F1: panel-mount blade holder -> board-mounted eFuse, per the owner's decision.
    Board-mount, resettable, no consumable, one fewer penetration.
    A polyfuse cannot do this job, and the numbers are worth keeping: PTC hold
    derates to 0.62x by 65 C (this project's own 1206L data), so holding 7.0 A in
    a ~65 C box needs ~11.3 A at 23 C, which trips at ~22 A -- over twice the
    connector's 10 A rating, the one thing 4.1 says a fuse must not exceed.
    STALE FIGURES FOUND AND CORRECTED. Spec 4.1 carried 7.8 A night / 10.5 A
    flash-to-pass and reasoned from a "105% overload". Sections 2.2 and 2.4 have
    read 7.0 A / 7.8 A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
    [fpmap.py]
2026-09-19 hw: spec 9.4 was missing L1 and L2; TPS1686 does not fit the plate
    Spec 9.4 totalled night at ~1.8 W, the plan at ~2.70 W. Not a contradiction:
    the difference is EXACTLY L1 + L2 (0.90 W), which 9.4's table omitted. That
    is Task 7 finding F4 -- both sit in the main feed path carrying the full
    7.0 A, and between them they are a third of the night budget, including a
    term equal to the P-FET's. The plan was corrected for it (9fa0fea); the spec
    never was. 1.8 + 0.90 = 2.70. 9.4 now carries both rows, and its plate table
    is rescaled: 150 cm2 gives ~23 K -> 63 C, so the flat plate still works but
    150 cm2 is now the floor rather than the comfortable choice.
    With 2.70 W as the base, the TPS1686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
2026-09-19 hw(docs): assess LTC4380 and LM5069 for F1 - route C is the only one that meets 9.4
    The owner supplied both as external-FET alternatives to the TPS1686. They are
    not the same kind of part and the difference decides the row.
    The LM5069 does not block reverse polarity, so Q1 (SQJ461EP, 16 mOhm, 0.78 W)
    stays in the path and a sense resistor adds 0.30 W on top. Give that route a
    FET with literally zero resistance and it still lands at ~66 C against a 65 C
    target. No FET selection can rescue it on the present 150 cm2 plate.
    The LTC4380 drives back-to-back N-FETs, so it does reverse polarity and
    overcurrent through one conduction path - it REPLACES Q1 instead of adding to
    it. Two 3 mOhm FETs pl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
2026-09-19 hw(docs): NVMFD5877NL rejected as the LTC4380 pass FET - 31 mOhm against a 7.5 mOhm ceiling
    Right part in every respect but the one that matters. 60 V, AEC-Q101, dual in
    one Dual SO8FL (exactly the back-to-back shape), and it carries the Forward
    Biased SOA curve the route is gated on - Figure 11, with dc/10ms/1ms lines.
    But back-to-back puts two R_DS(on) in series. At 31 mOhm typ per side that is
    62 mOhm and 3.04 W at 7.0 A, taking the night budget to 5.23 W and the board to
    ~85 C against a 65 C target. The ceiling is 7.5 mOhm each. It also fails at
    package level: ~1.5 W per FET against a 1.6 W theta-JA rating at 100 C, and a
    free-air I_D of 5-6 A that is below the 7.0 A night load on its o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
2026-09-19 hw(docs): close route C items 2 and 3; F6 - the RGB FETs DO see the TVS clamp
    Item 2, boost at a 27 V clamped input: PASS with margin. LM51571-Q1 is 1.5-45 V
    recommended and 50 V abs max on BIAS and SW; LM5164 is 6-100 V. Both read from
    datasheets already in the folder.
    Item 3 turned up a defect. Correction 2 closes with 'Unaffected: the RGB
    MOSFETs ... sit on the +24 V boost output, not on VBAT, so they do not see the
    TVS clamp' and calls row 1a.1's dependency one 'that does not exist'. It does
    exist. Spec section 6 documents the conduction path in terms - VBAT -> L3 -> D4
    -> +24V - and it is unconditional, so the rail follows VBAT during a clamp
    event. The RGB FETs are low-side (gen_outpu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
2026-09-19 plan: sweep stale feed currents in 11 places, pin the ESP32 antenna keep-out
    Two jobs.
    1. The plan quoted 7.8 A night / 3.9 A day / 10.5 A transient in eleven places.
    Spec 2.2 has read 1.2 / 7.0 / 7.8 since 2026-09-13 and says in terms that
    10.5 A was 'the arithmetic sum ... an envelope that no steady state
    occupies'. Sizing was conservative rather than unsafe everywhere - the stale
    figures were all higher - but two sites were load-bearing: Task 8 Step 1
    writes its figure ONTO THE BOARD as a text layer, and the closing line
    certified the plan 'consistent throughout' while it was not, which is the
    most misleading kind of stale line because it invites the reader not to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
2026-09-19 hw(docs): L6 - the whole ACT45B series shares one package, so a -220 model is the -510
    The owner re-downloaded cmf_automotive_signal_act45b_en.pdf believing it was
    the -510 sheet specifically. It is byte-identical to the copy held since
    2026-09-18 (same MD5) and is the series datasheet - it covers -110, -220, -510
    and -101 in one document, and is what the -510 was selected from.
    The mismatch flagged earlier was in the library/3D files, not the datasheet:
    Downloads holds ACT45B-220 and ACT45B-101 .stp/.zip, neither of them -510. That
    turns out not to matter geometrically. The datasheet carries a single SHAPE &
    DIMENSIONS (4.5 x 3.2 mm) and a single RECOMMENDED LAND PATTERN for the whole
    seri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
2026-09-19 hw(docs): LTC4380 needs no footprint download - stock MSOP-10 fits; restore two eaten part numbers
    The MS package is a plain JEDEC MSOP-10 with NO exposed pad: 3.00 x 3.00 mm
    body, 4.90 mm lead span, 0.50 BSC pitch (LTC DWG 05-08-1661 Rev F). Only the DD
    (DFN) package has a pad, and there it is explicitly optional. So stock
    Package_SO:MSOP-10_3x3mm_P0.5mm is correct - checked pad by pad against the
    drawing, including that pad 1 lands top-left and pad 10 top-right to match the
    datasheet TOP VIEW pinout.
    KiCad's land is more generous than ADI's minimum (5.70 mm outer span, 1.5 mm
    pads, against 5.10 min and 0.889) because it follows IPC-7351 nominal rather
    than the vendor floor. That is the pr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
2026-09-19 hw(docs): FET search brief in NEEDED.md; antenna entry partly resolved; drop two duplicate PDFs
    NEEDED.md said 'Blocking - nothing', which was true when written. The owner's
    decision to make F1 board-mounted and resettable reopened the list, so it now
    carries the one item actually blocking route C: two 60 V N-channel MOSFETs.
    Written as a search brief rather than a spec, because the binding constraint is
    one parametric search cannot express. A 60 V part at <= 5 mOhm is a commodity -
    dozens exist. What decides it is linear-mode SOA, since the trench technology
    that gets R_DS(on) low is the same technology that makes linear SOA bad. So the
    brief gives the filter values, then the check that ha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
2026-09-19 hw: pass FET selected - IPT008N06NM5LF; Espressif antenna rule obtained, 15 mm is an enclosure problem
    Two blockers closed by the two documents the owner supplied.
    FET: Infineon IPT008N06NM5LF, OptiMOS 5 LinearFET. Its feature list opens
    'Ideal for hot-swap and e-fuse applications' and 'Wide safe operating area
    SOA' - the check that rejected the NVMFD5877NL is what this part is designed
    around. 0.67 mOhm typ / 0.8 mOhm max at VGS=10V against a 5 mOhm target,
    VGS +-20 V, 48 A on the theta-JA line (the NVMFD gave 5-6 A there and failed),
    and Diagram 3 carries a DC line as well as 10 ms. Read off that curve, the
    10 ms line at 12 V is ~50 A against a 7 A need - about 7x, still ~5x after
    deratin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
2026-09-19 spec: rewrite 4.2 - reverse polarity and overcurrent merge into one pass element
    Q1 (SQJ461EP P-FET) and the blade fuse are both deleted. In their place U10
    (LTC4380HMS-2), Q10 and Q11 (IPT008N06NM5LF back-to-back), R88 (5.6 mOhm
    sense), R89 (R_DRN), R90 (10 Ohm gate damping), C49 (C_TMR) and C50.
    The section now states the topology explicitly and says why, because this is
    the class of error that has got through twice on this board already - the
    CM-choke pin numbering in Task 7 and the RGB-FET clamp path in F6. COMMON
    SOURCE, drains outward: both body diodes point inward to the mid-node, Q11's
    blocks VBAT_PROT -> MID and that is the reverse-polarity block. Common-drain
    also blocks reverse b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
2026-09-19 spec 4.2: work out the TMR design - R_DRN = 30k, C_TMR = 220nF, both directions checked
    Done by the datasheet's own Design Example procedure (Applications Information
    pp. 17-18), with the working shown, because these two values fail in opposite
    directions: too short nuisance-trips on inrush, too long violates the FETs' SOA.
    R89 from the DRN pin's 1 mA limit at peak input: (50.6 - 27)/1mA = 23.6k, taking
    4.3's 8/20 us worst case rather than the 38.9 V 10/1000 us figure. 30k chosen -
    next standard value up, the same direction of margin the datasheet itself takes.
    The useful finding is that inrush is gate-slew limited and the FETs soft-start
    it for free. Two IPT008N06NM5LF in parallel are 370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
2026-09-19 spec 4.2: CORRECTION - the auxiliary gate network is not optional; Figure 7 is the reference
    I read the Applications Information as instructed and my earlier simplification
    was wrong. The draft omitted Figure 5's Q3/D3/D4/R4/R5/R6 network on the
    reasoning that it existed to survive a 250 V surge we do not have. The evidence
    says otherwise, and it is in which application circuits carry it:
    Figure 5, 250 V transient, back-to-back -> network present
    Figure 7, 80 VDC max, back-to-back -> network present
    Figure 8, 20 VDC max, SINGLE FET -> network absent
    Figure 7 carries it at only 80 V, so it cannot be surge-specific. What separates
    the figures that have it from the one th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
2026-09-19 spec 4.2: CORRECTION - the pass pair is COMMON DRAIN, not common source. I had it backwards.
    While laying out the schematic I zoomed into Figure 7's pass devices to get the
    orientation right before wiring, and found the section I wrote yesterday
    specifies the wrong arrangement.
    It said COMMON SOURCE, drains outward; told the reader common-drain 'puts the
    two sources at different potentials, so one gate pin cannot drive both'; and
    instructed them not to 'simplify' it that way. That is wrong in the most
    dangerous available direction - a confident instruction to build the arrangement
    that does NOT block reverse current, in a section whose own preamble says this
    is the error class ERC cannot ca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
2026-09-20 hw(sch): spec 4.2 built - LTC4380 eFuse replaces F1/Q1/D1/R1
    The input stage's fuse, P-FET, gate Zener and gate pull-down are gone. In
    their place: U10 (LTC4380-2) driving a back-to-back pass pair Q10/Q11 across
    R100, doing reverse polarity, current limit and overvoltage clamp in one
    conduction path. Night falls 2.70 W -> 2.31 W.
    Built from the datasheet's Figure 7, not Figure 5 - only R_SNS, R_DRN and
    C_TMR are rescaled. Two deliberate departures, both noted on the sheet:
    R103/C64 are the PIN FUNCTIONS minimum (33R/47nF) rather than Figure 7's
    drawn 150R/0.1uF, because a larger C64 pushes the fault timeout past the SOA
    curve that was checked; and ON/FLT are left open under no-connect flags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
2026-09-20 hw(pcb): 4-layer stackup, thermal group on plate edge, antenna keep-out, power pours
    Task 8. The board is generated by scripts/gen_pcb.py from scripts/layout_pcb.py,
    the same way the sheets are - mccan.kicad_pcb is an artefact, never hand-edited.
    140 x 100 mm outline, M3 5 mm in from each corner.
    4 layers: F.Cu signal / In1.Cu GND / In2.Cu power / B.Cu bare, for the gap pad.
    73 thermal vias (0.5 / 0.25) filling the five genuine exposed paddles, and
    163 GND stitching vias - a 5 mm perimeter ring plus a 3 mm fill at the boost.
    U5's antenna overhangs the right edge with its keep-out clear of copper.
    Two checkers exist because the defect class here is geometry that passes every
    autom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
2026-09-20 hw(pcb): 1 oz outer / 2 oz inner copper, and the plate becomes the base
    Two decisions the user took on 2026-09-20, both of which had been raised as
    blocking conflicts at the end of Task 8.
    COPPER: spec 10 asked for 2 oz outer, which cannot be built. 2 oz etching will
    not hold U10's 0.15 mm land pattern or reliably the 0.20 mm the QFN/VSON parts
    need, and outer copper is where every land pattern lives. Weights inverted.
    The current path GAINS from this rather than losing. The 7.0 A feed never ran
    on an outer layer - it runs on the In2.Cu polygon, which was 1 oz and therefore
    under-specified: IPC-2221 wants 11.5 mm of internal width at 1 oz, against
    5.75 mm at 2 oz. That also settles a c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
2026-09-20 hw(pcb): a ground via for every SMD ground pad
    Task 9 groundwork, before any routing: 140 ground pads had no path to the
    plane at all, and they were 245 of the 469 unconnected items - a quarter of the
    ratsnest that was never routing work in the first place.
    GND is poured on In1.Cu and B.Cu. It is NOT poured on F.Cu, where the parts
    are: the only F.Cu pour is the GND_IN island, a different net. So every SMD
    ground pad sat on a layer where its own net has no copper. The 15 through-hole
    ground pads were always fine and three exposed paddles are filled by
    thermal_vias(); the other 140 had nothing.
    gen_pcb.gnd_drops() now puts a 0.6 / 0.3 via BESIDE each one with a stub to
    reach it - beside,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
2026-09-20 hw(pcb): In2.Cu becomes one VBAT plane, and D4 gets copper to land on
    D4's 30 thermal vias were dangling. Its tab is the boost catch diode's
    cathode -- the +24V node itself -- and D4 sits inside TIM-A, so that array is
    both the diode's heat path to the gap pad and its lowest-impedance current
    path. Both were severed: the vias passed through the VBAT half of the In2.Cu
    plane (notched), landed on B.Cu GND (notched), and connected to nothing.
    The In2.Cu split at x = 105 was wrong in both directions, not merely short of
    a lobe for D4. Seven of the eleven +24V pads are LEFT of it (D4, C61, C20,
    C21, C22, R12) and two of the fifteen VBAT pads are RIGHT of it (C45, C46):
    the nets interleave acr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
2026-09-20 hw(pcb): put the boost's own components next to the boost
    U3's entire support network was ~35 mm away, in the `rails` region. Not because anyone put
    it there, but because nobody put it anywhere: layout_pcb.BLOCK pinned only U3, L3, D4 and
    C61 to the `boost` region, so every passive fell through to SHEET_REGION and followed its
    schematic sheet, which is `rails`. The region's own comment already said what was meant --
    "U3, L3, D4, C61 and their passives" -- and the passives were simply never listed.
    What that produced: COMP 35 mm from pin 8, SS 33 mm from pin 10, the FB divider 37 mm from
    pin 9, VCC and BIAS with no local bypass at all, and both the input capacitors (C18/C19) and
    the output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
2026-09-20 hw(pcb): Task 9 step 1 - route the boost power stage
    Adds a route mechanism and uses it for the commutation loop.
    layout_pcb.ROUTES is (net, layer, width, [points]) and ROUTE_VIAS is (net, x, y, size,
    drill); gen_pcb.routes() emits them and checks two things that are easy to get wrong by hand
    and invisible afterwards: that every polyline END lands on copper of its own net, and that
    nothing sits closer to a foreign pad than the wider of the two net classes allows. Both
    tests work on COPPER OVERLAP, not on centrelines, because that is what KiCad's connectivity
    actually uses -- a 0.75 mm track whose centreline runs between two 0.25 mm QFN pads still
    connects to both, and requiring the centrel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
2026-09-20 hw(pcb): a grid autorouter for the signal nets
    Routes every net that is not GND and not in the FEED, POWER or CAN classes,
    with A* over a 0.1 mm two-layer grid: 159 connections, 2321 segments, 255 vias.
    Nets are attempted shortest-span first so the tight ones get the channels
    before the loose ones fill them, and each net is grown one component at a
    time, nearest piece first.
    Three geometry rules earn their place, each fixing a class of violation that
    passes clearance but fails connection width:
    - A* finishes on whatever cell of the target pad it reached first and then
    wanders inside it, so the segment crossing the pad boundary usually leaves
    through a corner and the overlap is a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
2026-09-21 hw(docs): correct the J2 pinout in enclosure.md
    The conformal-coating masking table listed J2 as (3V3, GND, TXD0, RXD0,
    EN, IO0). Pins 5 and 6 are DTR and RTS; they reach EN_MCU and BOOT_N
    only through the cross-coupled auto-reset pair Q2/Q3, as schematic-review
    7.4 and the netlist in part-selection both record.
    The error was worth fixing rather than leaving: an adapter cable built
    from that table would wire DTR and RTS straight to EN and IO0, which is
    the naive arrangement Q2/Q3 exist to replace and which resets the board
    on every serial connect.
2026-09-21 docs(plan): implementation plan for test mode and brightness
    Eight TDD tasks. Task 2 is the only one that touches several files at
    once: the Config type change breaks config_json.cpp and
    behavior_engine.cpp compilation, so they travel together and every
    task's deliverable stays independently testable.
    Corrects the spec's stated migration tolerance. Verified numerically
    before writing: the six shipped defaults migrate exactly, a
    single-channel ramp within 1 count, but an arbitrary non-neutral
    triple can land 2 out because hue normalisation rounds as well as the
    gamma round trip. Worst case (162,121,0) -> (161,119,0). A test
    written to the spec's flat +/-1 would have failed.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
2026-09-21 hw(pcb): resolve D4 and U4, give GND_IN its own island, stop leaving stubs
    Four things that had all been blocking a clean board, plus the pass of routing
    they unblocked.
    D4 is a TO-277A, whose third pad is the cathode tab. Device:D_Schottky has no
    pin 3, so schematic parity reported the tab as a net with no corresponding pin
    however the pad was aliased -- aliasing pads is not a fix for a symbol that is
    missing a pin. mccan_parts:D_SCHOTTKY_TAB is that symbol with a hidden pin 3
    stacked on the cathode, which is what the part actually is.
    U4 was BLOCKED since Task 8 step 0 on an apparent pin-1 disagreement between two
    figures of DS46371. There is no disagreement: the Suggested Pad Layout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
2026-09-21 hw(pcb): hand the signal bundle to KiCadRoutingTools, and keep the board generated
    The built-in grid A* in gen_pcb.py routes the power stage, the fan-out lanes and
    every hand route, and it is the only router that knows this design -- the GND_IN
    island, the thermal via arrays, the 142 ground drops, the antenna keep-out. What
    it does badly is the last fifth of the signal bundle. On a full pass it settles
    at 85 of 139 nets, and the 53 failures are not spread evenly: 27 of them are the
    RGB output bundle, and the log shows the same nets torn out and re-laid over and
    over (RET_RR_G was ripped at 105 and again at 106). That is thrashing, not
    convergence -- a global net-ordering problem a greedy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
2026-09-21 hw(pcb): the external router's copper, frozen in, and the gate that let it through
    Task 9's signal bundle now comes from KiCadRoutingTools rather than gen_pcb's own
    A*, and the route -> freeze -> emit chain runs end to end for the first time.
    KiCad DRC on the result: 0 errors (was 1), 105 unconnected items (was 179),
    0 schematic parity issues. The clearance error at U4 pad 2 is gone, and so are
    all 68 silkscreen warnings. Of the 105 that remain, 53 are on nets this router
    was never given -- the power feeds and the CAN pair, which are steps 2 and 3 --
    and 52 are its own shortfall over 38 nets.
    The run before this one exited 0 and handed back 2177 tracks at 0.0889 mm against
    a 0.25 mm requ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
2026-09-21 hw(pcb): every via gets a 0.15 mm annular ring, and the router stops grading itself
    Two things came out of checking this board against PCBWay's published process,
    and they turned out to be the same problem seen from two ends.
    PCBWay's floor is a 0.15 mm annular ring, and they state it for exactly this
    board's case -- "for pads with vias in the middle", which is what all 73 thermal
    vias are. At 0.50/0.25 the ring was 0.125 mm and under it. THERM_VIA goes to
    0.55, which buys the ring rather than the copper; the cost is eight vias,
    because the bigger via insets the array further (D4 6x5 -> 5x5, U9 3x5 -> 3x4).
    D4 keeps 25 and U9 keeps 12, and the array stopped being the thermal bottleneck
    we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
2026-09-21 hw(pcb): six layers, 1 oz throughout, and the feed width finally gets measured
    F.Cu and B.Cu alone did not close this board. The external router settled at
    about 100 of 139 signal nets, and the failures were not clustered -- one pad
    here and one pad there across forty nets, which is what running out of layer
    looks like rather than what a bad net order looks like.
    Five layers was what got asked for. Six is what got built, because a five-layer
    board is laminated out of a six-layer stack with one copper layer left unused:
    it costs the same money and warps more, being asymmetric. Six buys two routing
    layers for that money and puts a reference plane next to every signal layer.
    F.Cu sig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
2026-09-21 hw(pcb): fold in the four-layer routing pass -- 122 of 139 signal nets, on less copper
    The two-layer result was 4606 segments and 817 vias for about 100 nets. This is
    3629 segments and 568 vias for 122. Fewer of both, for more connectivity, which
    is the shape you expect when the problem was never the router: F.Cu and B.Cu
    alone did not have the channels, and In2.Cu and In4.Cu now carry 760 and 630
    segments between them.
    KiCad's numbers move the same way:
    violations 61 -> 22 (53 dangling vias -> 10, 7 narrow joints -> 12)
    unconnected 108 -> 72
    parity 0 -> 0
    And the 72 are not 72 router failures. 51 of them are nets the router was never
    given -- FEED, POWER a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
2026-09-21 hw(docs): the fab drawing gets its order notes, and the boost stops having FETs
    Three things the board has to be ORDERED with, none of which is a default, and
    none of which was written down anywhere a fab house would see it:
    1. Via-in-pad on U1.9, U2.9, U3.17, U9.15 and D4.3 has to be plugged and capped.
    The drawing already said IPC-4761 type IV or VI; what it did not say is that
    the default finish is TENTED, which is a mask skin over an open barrel and
    wicks paste out of the joint exactly as if nothing had been asked for.
    2. No solder mask dam at U10. Its leads leave 0.15 mm, and a dam that thin does
    not survive the mask process -- a half-formed sliver is worse than no dam.
    3.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
2026-09-21 hw(pcb): measure what the narrow-connection warnings actually are
    Twelve connection_width warnings on the routed board, and Task 9 step 6 asks for
    zero. They are two unrelated things wearing the same label:
    2 are real. A router via landed off the corner of Q10 and Q11's gate pads
    instead of into them, so the two coppers overlap by 0.08 mm. That is what
    this rule exists to catch and it wants fixing in the routing.
    10 are necks inside the GND_BOT and VBAT_IN3 pours, 0.01 to 0.19 mm, where the
    fill squeezes between two antipads. More vias, more antipads, more necks --
    which is why the count went UP, 7 to 12, on a run that improved everything
    else.
    The obvious lever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
2026-09-21 hw(docs): harness.md stops protecting the feed with a fuse that was deleted
    F1 became a board-mounted eFuse on 2026-09-20 and the blade fuse holder came off
    the enclosure with it -- nine penetrations became eight. harness.md did not
    notice. Its §4 still told the builder the feed had "a 10 A panel-mounted fuse",
    and its §6 accepted-risk note reasoned from that fuse's position.
    What actually changes, and what does not:
    - §4 now names F1 -- U10 with Q10/Q11 and the R100 sense resistor, limiting at
    9-10 A -- and says plainly that there is no panel fuse and no holder.
    - The load percentages stay, but they are against the OUTLET's 10 A rating now,
    not against a fuse. The old "78% susta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
2026-09-21 hw(docs): the rip-up experiment, and why it is not the lever
    The 21 signal connections route.py could not close on the six-layer board have an
    obvious next move -- grant it authority to rip the nets its own failure histories
    name as blockers -- and it does not work. Recorded here with the numbers so it
    does not get tried a third time.
    62 distinct blocker nets were named. Filtered against unrouted.kicad_pcb, exactly
    one was this repo's copper (/rails/SW_BOOST, the hand-routed boost stage), so the
    other 61 went to --rip-existing-nets explicitly, which also bypasses route.py's own
    _RIP_ESCALATION_CAP of 12.
    Every guard held. SW_BOOST was ripped once and logged "original copper restored";
    f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
2026-09-22 hw(pcb): the CAN pair by hand, the rest by router, and fab notes
    Three things, and the middle one is the reason the other two were worth doing
    now.
    CANH/CANL are hand-routed, because the router is excluded from them by name and
    always was. The pair leaves the box on a long unshielded harness, so it is
    routed for immunity and not for speed: at 500 kbit/s the 110 mm from the
    transceiver to J8 is 0.7 ns of flight against a 50 ns edge, stub lengths do not
    matter, and a few millimetres of skew is 20 ps. What matters is that the pair
    stays together, stays over solid ground, and never runs beside anything that
    switches. In2.Cu gives all three -- 0.2 mm under an unbroken In1.Cu, no splits
    anywhe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
2026-09-22 hw(pcb): hand-route U3's VCC, MODE and SS, and let drops see hand routes
    Three nets leave U3's right edge inside a 1.0 mm band and only one 0.5 mm via
    fits there. The external router gave that spot to MODE and then had nowhere to
    put SS: it dropped a via inside C25 pad 1, gave up, and left the net with no
    copper. U3 VCC failed the same way, for a different reason -- pin 2's only
    escape is a 0.35 mm channel west of the pin, and pin 1's ground drop had taken
    it.
    MODE now dives at x 76.80, clear of the band, which frees the y 32.25 lane for
    SS; both run down In2.Cu and surface BESIDE their far pad rather than in it.
    Two mechanisms were missing and are added here:
    * layout_pcb.FROZEN_DROP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
2026-09-22 hw(pcb): hand-route EN_BOOST from U3 pin 6 to R20
    U3's enable pin had no way out on F.Cu: the RT staircase boxes it in to the
    west, pin 7's ground drop sat in the mouth of the only channel to the south,
    and the R14 / C23 pad gaps below are 0.85 and 0.65 mm -- too narrow for a via
    and only just wide enough for a track.
    The route runs straight down that pair of gaps at 0.20 mm, the board floor and
    far more than a static enable needs, which leaves 0.325 and 0.225 mm a side.
    Pin 7's ground drop relocates by itself now that gnd_drops() reads the hand
    routes; it ends up sharing the paddle's via field.
    KiCad DRC: 18 violations, 22 unconnected (was 18 / 23), 0 parity.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
2026-09-23 docs(spec): re-layout the board at 200x140 mm on 8 layers
    The 6-layer board reached 0 DRC errors and still is not worth fabricating:
    12 reference designators have no silkscreen at all, the outputs block sits
    at 59 % courtyard fill, and four commits of hand-routing went into nets that
    carry no electrical requirement. All three are density.
    Doubles the area to 280 cm2, which also clears the gland-row defect in
    enclosure.md 2 (seven glands need 143 mm of wall). Eight layers as
    sig/GND/sig/GND/power/sig/GND/sig -- four routing layers, and every signal
    layer gets a plane, which the 6-layer stack did not give B.Cu. CAN moves to
    In2.Cu as a buried stripline, so segregation is structural rather tha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
2026-09-23 docs(plan): implementation plan for the 200x140 mm, 8-layer re-layout
    Twelve tasks: archive the two retired boards behind tags, tear out the copper the
    move invalidates, build a density gate and validate it against the board it
    describes, re-outline with channels and budgets, go to eight layers, make an
    unprintable designator a build failure, hand-route feed/CAN/boost, hand the rest to
    the router, regenerate the fab package and the docs, and extract the method as a
    skill.
    Writing it turned up two errors in the approved spec, both corrected here and
    scheduled for correction in the spec at Task 3 step 4:
    - The congested region is input at 75.8 %, not outputs at 59 %. The 59 % described
    the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
2026-09-23 chore: ignore .superpowers/ execution scratch
    Ledgers, task briefs and review packages for subagent-driven plan execution.
    Scratch, not source -- the git history is the durable record.
2026-09-23 docs(plan): correct task 3's negative test to the measured figure
    It expected 'outputs at 59.x%' on a board where outputs measures 37.3%. Now uses
    input at 75.8% against the 0.45 budget it will really carry in task 4, and says
    plainly that task 3 is meant to end red.
2026-09-23 hw(pcb): the six-layer board as it stood, before the re-layout
    Committed unreviewed and unregenerated, purely so the 200x140 re-layout has
    something to tag. This is the tip of the six-layer work: the four-layer routing
    pass, the plane-width measurement, the hand-routed CAN pair and U3 escapes, and
    the untracked helper scripts (check_courtyards, find_escape, show_room) and
    PCBWay production package that were never committed.
2026-09-23 hw(pcb): archive the four- and six-layer boards
    A tag holds the scripts that produced a board, which is the part that matters
    since nothing here is hand-edited. The directory holds the board file itself, so
    reading a retired board does not mean checking out a retired tree.
2026-09-23 hw(pcb): note the archived DRC reports are stale
    Both git show calls in Step 3 succeeded, so the brief's "note it in the README
    if the show failed" fallback never fired -- but the reports it recovered are
    byte-identical, both last written at 7c4bf0d before the four-to-six-layer
    transition. Neither describes the board it now sits beside; the v2-6layer
    board in particular has no DRC report of its own. Recoverable is not the same
    as accurate, so the archive says so.
2026-09-23 hw(pcb): tear out the old copper, which the re-layout invalidates
    Every hand route named absolute coordinates against a placement that is about to
    change, and routes_signal.json named coordinates AND In4.Cu, which is about to stop
    being a signal layer. None of it could have survived the move. The reasoning in the
    old route comments is about the circuit rather than the coordinates and carries over;
    it is at tag board/v2-6layer.
2026-09-23 docs(plan): task 2's git add named a path git rm had already removed
    git validates every pathspec before staging any of them, so listing the deleted
    routes_signal.json alongside the two real paths made the command fail with exit 128
    and stage nothing at all -- not the harmless no-op it was assumed to be.
2026-09-23 hw(pcb): measure region fill, and fail the build when it is too high
    The 59 % recorded for the outputs block was written by hand about a region that was
    widened in the same commit. Measured, that block is at 37 % and the congested one is
    input at 76 % -- so the number was not wrong when written, it just stopped being about
    anything. Density is the root cause behind the six-layer board's silk, routing and
    hand-routing problems, and it needs a measurement rather than a comment.
    Run before anything is re-proportioned, so the 'after' has a 'before' to mean
    something against.
    Measured, --report, on the current 140 x 100 board (231 placed parts, U5 off-board):
    region region parts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
2026-09-23 hw(pcb): fail loudly on a BUDGET key that names no region, and label the area column
    Review of the check_density.py gate found two problems, both live risks against Task 4,
    which rewrites both REGIONS and BUDGET wholesale:
    A BUDGET key absent from REGIONS was silently ignored -- no row, no warning, no effect
    on the exit code. That is exactly the silently-stale-number failure this gate exists to
    catch in the first place: a budget naming a region that no longer exists is a budget
    nobody is enforcing. It now fails with a named error before the table prints.
    The table's second numeric column was headed "parts" but holds summed courtyard area in
    mm2, not a count. Renamed both numeric headers to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
2026-09-23 hw(pcb): 200 x 140 mm, with routing channels and enforced fill budgets
    Doubling the area halves the fill on its own, but it does not change the packer --
    it just gives it more room to pack the same way. So the region model gains two
    things it never had: 6 mm part-free channels between neighbours, which is a routing
    budget that can be reasoned about rather than whatever gaps the packer left, and a
    declared fill budget per region that check_density.py fails the build over.
    input, the worst region on the old board, goes 75.8 % -> 38.8 %; outputs 37.3 % -> 17.1 %;
    the wire-exit field 62.9 % -> 33.9 %. The comment claiming outputs was at 59 % described a
    region that had been widened in the same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
2026-09-23 hw(pcb): eight layers -- three ground planes and a split power layer
    Fixes a defect the six-layer stack carried: B.Cu was a signal layer whose only
    neighbour was another signal layer, so bottom-side traces had no adjacent reference
    plane. A GND pour on the same layer is not a plane beneath them. Now every signal
    layer has a solid GND plane on at least one face and In2.Cu has one on both, which
    is where the CAN pair goes -- segregation by construction rather than by a rule
    nothing enforces.
    In4.Cu is split so the logic rails stop being 2.0 mm tracks. The islands are
    computed from where their pads are, not drawn: the old board's hand-chosen vertical
    split put seven of eleven +24V pads on the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
2026-09-23 docs(plan): task 5's rail_island compared a net code against a net name
    pads_board returns net CODES, so the plan's `pd[2] != net` test could never match and
    rail_island returned an empty island -- which would have left VBAT filling the whole of
    In4.Cu unsplit, quietly defeating the split power plane the task exists to build. The
    implementer caught it and resolved through NETNAME; the plan now says so too.
2026-09-23 hw(pcb): In4.Cu is a solid VBAT plane; the rail islands orphaned pads
    spec 3.2 split In4.Cu four ways because +24V, +5V and VLOGIC_IN are POWER-class
    2.0 mm tracks and a zone costs no routing effort. Measured on this placement it
    does not work. rail_island() is a bounding box over every pad of a net, and all
    three nets span the board: /+24V's eleven pads run x 83.38..174.58, so its island
    is 98.4 x 20.0 mm and swallows five /VBAT pads -- C18.1, C19.1, C45.1, L3.1 and
    R16.1, the boost input caps and the boost inductor. Every rail also holds pads of
    the other two. All three sat at priority 1, so which net owned the contested copper
    was order-dependent, and under any ordering the loser's pads g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
2026-09-23 hw(pcb): the plane-width gate refuses to measure a shared layer
    check_plane_width rasterises the plane's OUTLINE polygon and subtracts via and
    pad barrels. It has never done polygon arithmetic against other zones, so a
    second zone on the same layer -- which KiCad carves out of this one when it has
    the higher priority -- is copper the raster still counts.
    That matters because the design doc leaned on this gate to guard the In4.Cu
    split: "check_plane_width.py measures it and fails the build". It could not.
    Run against the split board it prints 106.50 mm and exits 0, the same number it
    prints for a solid plane, because the three rail islands were never in the sum.
    Rather than teach it polygon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
2026-09-23 hw(pcb): the stackup table still called In4.Cu split
    Three lines above the block that was rewritten to say In4.Cu carries VBAT alone,
    the ASCII stackup summary still read "In4.Cu POWER, split: VBAT | +24V | +5V |
    VLOGIC_IN". It is the first thing anyone reads in that file.
    zones() also kept comps, pos and padnet in its signature; rail_island() was the
    only thing that used them. Dropped, with the call site.
    The zones() docstring now records that check_plane_width refuses a shared layer
    rather than measuring one -- the reason the split had no working gate.
    Generated board is byte-identical (md5 f9f504b8...); all six gates exit 0.
2026-09-24 hw(pcb): a designator with nowhere to go fails the build
    silk_refs() used to try the library position, then four sides, then shrink to the
    board minimum, then demote to F.Fab. That ladder turns a placement failure into a
    board that cannot be read on the bench, silently -- twelve parts on the six-layer
    board had no reference designator at all.
    Both fallbacks are gone. If a designator cannot be printed legibly at full size next
    to its own part, that is the placer's problem and the build stops.
    Turning it on named 17 parts, so the placer had to answer them:
    GUT, the gutter between auto-flowed courtyards, goes 0.4 -> 1.2 mm. 0.4 was the
    six-layer board's value, chosen when area was scarce; on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
2026-09-24 hw(pcb): the silk diagonals were never used; only the reach mattered
    Review caught that the previous commit's story was wrong. It claimed U3's
    designator had no side to take and that the four diagonal candidates rescued it.
    U3 actually lands on the plain LEFT side at d = 2.95 -- local (at -6.355 0) on a
    footprint at (86, 32), exactly the axis midpoint. Diagonals are tried after sides
    at the same push, so they were never reached.
    Ablated to check rather than argue: with all four diagonals deleted the generated
    board is byte-identical and the silk line is the same 54 left alone, 7 moved. They
    were load-bearing for nothing. Deleted.
    What is load-bearing is the reach. The ladder stopped at 1.4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
2026-09-24 hw(pcb): the 7 A feed, poured through the left band
    One direction only -- J1 up through the eFuse, up through L2 and the pi filter, out
    of the top of input. Nothing doubles back. Poured rather than tracked: the FEED
    class's 3.5 mm is a 20 K-rise floor for hops of a few mm, and every real run here is
    >= 4.5 mm or is on the In4.Cu plane.
2026-09-24 docs(plan): the unconnected-net check in Tasks 7 and 8 could never fail
    `grep -i "unconnected" output/drc.rpt | grep -iE "<nets>"` returns 0 for every board
    ever generated. KiCad's report puts the net names two to three lines below the
    `[unconnected_items]` header and never on it, so the second grep has nothing to match.
    Task 7 was verified with it -- by its implementer and by me -- and a split GND_IN zone
    fill walked straight through.
    `grep -n -A3 "\[unconnected_items\]"` finds it immediately.
2026-09-24 hw(pcb): the feed's narrow stretch was 7.5 mm, and a riser split a pour
    Two fixes from the Task 7 review, both verified by ablation rather than argument.
    The VBAT_F trunk carried the full 7.0 A over 7.5 mm at 3.5 mm under a comment claiming
    "the last 3 mm". The end-cap conflict it was dodging is real -- turning at x=31.0 leaves
    0.0085 mm to the VBAT link's cap against a 0.3 mm floor -- but the answer was to move the
    turn, not thin the copper. At x=30.5 the same 4.5 mm track clears by 0.5085 mm and the
    trunk is 4.5 mm end to end. VBAT_F never reaches a plane (In4.Cu is /VBAT, a different
    net), so every millimetre of it is the only copper there is.
    GNDIN_F was filling as two islands and DRC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
2026-09-24 hw(pcb): a split zone fill reported 0 DRC violations; add a gate for it
    Task 7 pinched GNDIN_F into two disconnected copper islands. KiCad DRC with
    --refill-zones said 0 violations, because a split fill is an unconnected item,
    not a violation. check_grounds.py passed too: it tests the zone's authored
    polygon against pad centres, and the polygon was never wrong -- the copper
    that filled inside it was. Neither check is structurally able to see this
    fault.
    The report body can: a split fill shows up as an [unconnected_items] block
    whose two anchors are the same zone paired with itself. check_zone_islands.py
    parses output/drc.rpt for exactly that signature -- not "a zone appears in an
    unconnecte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
2026-09-24 docs(plan): run the zone-island gate wherever hand copper meets a pour
    Task 7 split a ground pour in two with a hand route and DRC reported 0
    violations. check_zone_islands.py is the gate for that; Tasks 8, 9 and 10 all
    lay copper past the same pours, so it runs in all three rather than only after
    the router's freeze.
    It parses the report DRC writes, so it is placed after the kicad-cli call, not
    in the gate list that precedes it.
2026-09-24 docs(plan): J8 to J1 is 36.55 mm, measured, not ~35
    Task 8's segregation argument leans on the connector spacing being too small to
    be the thing that separates CAN from the feed. The figure was an estimate; the
    gland row is J1 30.85, J7 49.35, J8 67.40, so it is 36.55 mm. The argument is
    unchanged -- what separates them is the ground plane between the layers.
2026-09-24 docs(plan): Task 8's twelve CAN pads, measured, with two rulings
    The plan asked for a matched, evenly spaced pair without saying where the pads
    are. They are worth writing down: the haul from J8 in the gland row to D6 in the
    top-right corner is about 163 mm, and the cluster's physical order west to east
    (L6, D6, R26, U6) is not its electrical order (D6, R26, L6, U6), so the pair
    doubles back twice inside 24 mm.
    Ruled: route it as placed. The doubling back costs ~50 mm on a 160 mm run and
    CAN at this rate does not care; moving L6 re-opens a placement Task 6 closed and
    re-flows its neighbours through the courtyard gutter.
    Ruled: spacing is constant along the haul, not at the pads -- J8's pit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
2026-09-24 docs(plan): In2.Cu is empty, and the CAN corridor is open
    Measured before dispatching Task 8: In2.Cu carries no segments and no zone, so
    the pair has the layer to itself. The straight line from J8 to D6 is 160.9 mm
    and only 15 of the board's 509 via barrels come within 5 mm of it.
2026-09-24 hw(pcb): the zone-island gate cited an entry that does not exist
    The docstring offered U4.4 as a live example of the zone-vs-pad case the gate
    deliberately does not fire on. There is no such entry: drc.rpt contains no zone
    at all today, and 'no room for a drop' is a gen_pcb.py build warning that has
    never been in the report. The exclusion is real and stays documented; the
    example is gone and the absence is now stated and checkable.
    The block regex no longer hardcodes the severity line, and a header it cannot
    parse now fails loudly instead of dropping out of the count -- a gate that
    returns 0 without looking is the fault this file exists to catch.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
2026-09-24 hw(pcb): the header-count guard is one-directional, and now says so
    It catches a block that parses short -- the case that can hide a split fill and
    report clean. It does not catch a block carrying an extra anchor line: that
    still parses from its first two, the counts still agree, and the extra line is
    dropped silently. Verified by injecting one.
    The comment called the short-block case 'the one failure mode this file cannot
    tolerate', which reads as complete coverage. The asymmetry is the right trade --
    an extra anchor can only under-report, and the gate still exits non-zero -- but
    the file should not claim more than it does.
2026-09-24 docs(plan): R26 is a DNP shunt, not a link in the CAN chain
    Task 8 described the run as J8 -> D6 -> R26 -> L6 -> U6. gen_mcu_can.py:345-351
    wires R26 as a DNP 120R terminator shunted across the CANH and CANL labels, and
    w(L6["4"], D6["1"]) / w(L6["3"], D6["2"]) wire D6 straight to L6. The
    continuous copper is D6<->L6; R26's pads are stubs off it.
    Routing the literal chain does not close on one layer: D6's and L6's pad pairs sit
    north/south of each other while R26's sit west/east, a 90-degree mismatch. The
    first implementer found this and was right to depart from the text.
    Also records that all four pads on each long net are one net, so the haul's
    landing pad is a free choice.
    Co-Authored-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
2026-09-24 docs(plan): Task 9's boost geometry, measured, with what is already there
    Task 8 cost a fix round because its brief described geometry in prose and the
    implementer derived coordinates that crossed. Task 9 gets the pad extents up front,
    plus the four widths and stops that fall out of them -- the same relationships the
    six-layer board reasoned to, since the block was re-placed rather than redesigned.
    Also records the copper already in that window, because gen_pcb checks hand routes
    against vias as well as pads and refuses to write the board when one is short. The
    sharp one: a GND via at (86.250, 34.225) leaves only 0.10 mm beside the natural COMP
    lane out of U3.8.
    Rules that FB_24V taps +24V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
2026-09-24 hw(pcb): check_geometry described the six-layer stackup
    The code was right and is unchanged: ROUTING_LAYERS is gen_pcb.SIGNAL_LAYERS, read at
    import, so the gate has been failing tracks on In4.Cu all along. Its docstring was not.
    It said "In1.Cu is the GND plane and In3.Cu the VBAT plane ... In2.Cu and In4.Cu are
    signal layers and are fine", which describes the board before Task 5. On this board In3.Cu
    is GND, In6.Cu is GND, and In4.Cu is the solid VBAT plane -- so the sentence told a reader
    that the one plane this stackup was rebuilt around is a legal place to cut a slot.
    The gate prints its live list, and it reads: routing layers B.Cu F.Cu In2.Cu In5.Cu.
    A second comment said grading aga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
2026-09-24 hw(pcb): CAN as a buried stripline on In2.Cu
    Between the In1.Cu and In3.Cu ground planes, so segregation from the feed and the
    switch node is structural -- the pair is physically enclosed in copper -- rather than
    a keep-away rule nothing enforces. There is a ground plane between the
    pair and every aggressor on the board, which matters more than connector spacing: J8 is
    third in the gland row and 36.55 mm from J1, and that order is fixed by the enclosure.
    Four nets, not two -- the choke splits each side, and Net-(U6-CANH/L) is the half that
    reaches the transceiver.
    Fix round 1 found three faults in the previous attempt (never regenerated, so its
    "verified" comments cited a run that had not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
2026-09-24 hw(pcb): fix round 2 -- gnd-drop gate, CAN netclass, stale comments
    Seven faults from task-8-fix-2-brief.md, fixed in the mandated order:
    1. check_zone_islands.py's parse_blocks() only classified the first two
    anchors of an unconnected-item block, silently missing a same-zone
    split reported as a 3rd+ anchor (e.g. zone,pad,zone). Rewritten to a
    line-based parser that classifies every anchor in a block.
    2. gnd_drops()'s via_ok() modeled a candidate ground-drop via as a circle
    while check_track_crossings() -- the gate that actually fails the
    build -- models the same via as a box, a discrepancy of up to
    r*(sqrt(2)-1) = 0.1243mm on a diagonal approach. via_ok() now uses the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
2026-09-24 docs(plan): correct the R26 citation and the pin-12 width claim
    Two false assertions in the plan text, both found while verifying Task 8's
    fix round 2.
    gen_mcu_can.py:345-351 was wrong at both ends: 345 wires D6 pin 3 to ground
    and 351 is blank. The R26 evidence is 341-350 -- 341-344 show L6.4 -> D6.1
    direct, which is what makes "R26 is not a link in that chain" true, and
    347-350 are the DNP shunt itself.
    "0.30 mm is the widest track that does" was simply false: 0.34 mm clears
    pin 11 by 0.205 mm and passes. 0.30 mm stays the prescription, now with the
    reason stated -- margin, not limit. 0.35 mm is the first width to fail, and
    it fails on a floating-point last bit (0.19999999999999929), whi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
2026-09-25 hw(pcb): fix round 3 (1/2) -- CAN vias to the CAN netclass size
    All twelve CAN ROUTE_VIAS entries were 0.8/0.4 (the FEED-class size)
    instead of the CAN netclass's own 0.6/0.3 (NETCLASSES declares
    ("CAN", 0.3, 0.2, 0.6, 0.3, ...)). gen_pcb.py takes via size/drill
    straight from the ROUTE_VIAS tuple and never consults the netclass,
    so the class's own via figures were inert for every hand via on this
    net. Resize all twelve to 0.6/0.3; this also buys 0.10 mm of extra
    clearance on each side versus the old 0.8 mm vias.
    gen_pcb.py exits 0 with no new clearance errors and the same single
    U4.4 ground-drop warning as baseline. Full gate suite (density,
    courtyards, geometry, grounds, vias, plane_width,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
2026-09-25 hw(pcb): fix round 3 (2/2) -- route the CAN haul as a true matched pair
    The J8->L6 long haul (CANH/CANL) was not a matched differential pair:
    CANH wove through 10 interior bends dodging 0.6 mm GND drop vias that
    actually move out of the way on their own (gnd_drops() runs after
    hand routes and calls via_ok() to refuse any drop that clashes with
    hand copper), while CANL ran almost straight with 2 bends. Measured
    centre-to-centre spacing ranged 1.027-4.600 mm.
    Re-routed both tracks from a shared centreline (J8.1 (67.400,130.590)
    -> L6.4 (193.575,31.300), 160.557 mm at 38.2 deg), each offset +-0.325
    mm perpendicular to it for an exact constant 0.650 mm centre-to-
    centre, fanning to pad pitch on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
2026-09-25 hw(pcb): correct six false claims in the CAN haul comment
    The round-3 re-review found two contradictions in the new J8->L6 comment
    block. Measuring the block's every assertion against the artifact found
    six, of which the review named two:
    * "eight 0.55 mm /VBAT thermal vias at x 87.1..88.9, y 109.5..111.6 ...
    offset 1.647..3.854" -- it is a 3x4 grid of TWELVE, y 108.425..111.575,
    offsets 1.647..5.236. This one is mine: it entered in the fix-round-3
    brief's corridor scan and was copied faithfully into the comment.
    * "the closest one clears by 0.597 mm" -- 0.597 is the margin left over
    after subtracting a *FEED* clearance of 0.300, but this is a CAN-class
    net and its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
2026-09-25 hw(pcb): the boost switch node, by hand and tight
    The LM51571 integrates its switch, so there are no gate loops and this is the only
    fast edge on the board; the boost is non-synchronous, so D4 is inside the
    commutation loop. Loop area is a geometric property no router optimises for -- it
    will hand back an electrically correct switch node that rings, and the failure shows
    up on the bench rather than in any gate. Hence by hand.
    The return half is deliberately not routed: In1.Cu is solid GND one 0.1 mm prepreg
    below F.Cu, so the return mirrors the outbound path beneath it, which is smaller than
    any trace. COMP and FB_24V are kept off SW; FB_24V taps the far end of the output cap
    by reading thr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
2026-09-25 hw(pcb): correct four clearance figures and C24's pad labels
    The copper is unchanged and byte-identical; every fault here is in the prose.
    Four figures understated the actual clearance: the COMP jog past the (86.25,
    34.225) GND via reads 0.350 mm, not 0.261 mm (0.261 reproduces under no metric
    at all -- a bounding-box gap gives 0.125 and the true copper gap gives 0.350);
    the COMP final leg clears C24's GND pad by 0.849 mm, not 0.575; the SS return
    via by 0.475 mm, not 0.45; the SS final run by 0.650 mm, not 0.625. The FB hop
    past pin 8 reads 0.523 mm as copper, not the 0.484 mm a bounding box gives.
    C24's pads were named the wrong way round in three places. On the board C24.1
    is Net-(U3-CO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
2026-09-25 hw(pcb): +24V is POWER-class, and the pin-12 tie clears D4.1 by 0.550 mm
    Two comment defects the Task 9 review found that 26aa850 missed. Copper unchanged
    and byte-identical; both are prose.
    The clearance preamble claimed SW_BOOST, +24V, Net-(U3-COMP), FB_24V and
    Net-(U3-SS) "all match no NETCLASSES entry, so all five sit on the 0.20 mm board
    default". +24V does match one: it is in POWER (NETCLASSES, this file) at 0.30 mm,
    and the very next sentence of the same block already treated a +24V pad as
    POWER-class -- the block contradicted itself. The generator's gate reads the real
    netclass, so every figure was computed at the correct floor regardless; only the
    prose was wrong. It now says which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
2026-09-25 docs(plan): correct the plate area and Task 10's success bar
    Two numbers in this plan were wrong, both found by pre-flighting Tasks 10 and 11
    against the artifacts rather than reading the plan back to itself.
    The heat-spreader plate is stated as going "from ~137 cm2 ... to ~272 cm2". Measured
    from Edge.Cuts the outline is four straight sides and four 3 mm corner arcs: 200 x 140
    less 0.08 cm2 of corner is 279.92 cm2. This board also has no antenna notch, so the
    140 x 100 outline's 3.1 cm2 deduction does not carry over -- which is why the figure is
    280 and not 277. 272 is derivable from nothing. Task 11 would have written it into
    enclosure.md section 1, where the thermal table maps plate area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
2026-09-25 hw(pcb): the router's copper, on four layers with room to use them
    122 of 139 signal nets, against 122 on the six-layer board. Graded by
    check_geometry.py before a single segment was admitted -- the tool will go below the
    sizes you give it and exit 0, so its own graders being content means nothing.
    KiCadRoutingTools closed 17-net worth of the internal router's channel starvation on
    the first pass; freeze_routes.py dropped 2 sub-10um nubs (5um each, well under the
    0.01mm floor) that check_geometry.py correctly refused to admit raw. No copper the
    repo decided by hand was lost -- freeze_routes.py's additive diff confirmed it.
    DRC: 0 errors, 0 schematic parity, 19 unconnected (18 distinct nets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
2026-09-25 hw(gen): measure hand routes after the router's copper exists, not before
    check_track_crossings() sat between gnd_drops() and the frozen/autoroute
    branch, so "every other piece of copper on its layer" meant the 141 ground
    drops and the other hand routes and nothing else. The router's 4692 segments
    and 857 vias are created after it and were invisible to it -- the docstring's
    claim that "the autorouter's output is compared against" was not true of the
    code. Harmless while ROUTES came first and the router worked around it; not
    harmless now that routes_signal.json is frozen and will not move for a hand
    route.
    Moved the call below the branch and corrected the docstring. The constraint
    the old co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
2026-09-25 hw(gen): a via is a disc, not its bounding square
    The three via-vs-copper clearance sites modelled a via by its bounding box.
    _seg_rect_gap's docstring argues a box is the conservative side to err on,
    and for a pad it is -- a pad has an orientation and a shape the box encloses.
    A via has neither. It is round, always, so its bounding square is not a
    cautious approximation, it is the wrong shape, over-reporting an off-axis
    intrusion by exactly (sqrt(2)-1)*s/2 = 0.124 mm on a 0.6 mm via.
    That is the whole of the 12 findings Step 6.0 raised once the frozen router
    copper became visible to check_track_crossings. All 12 clear under the disc;
    KiCad's DRC found 0 violations on the same copper throug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
2026-09-25 hw(tools): the freeze picks the board these two plan against
    find_escape.py and show_room.py both told the reader to sweep
    output/router/unrouted.kicad_pcb, on the reasoning that gen_pcb lays ROUTES
    before it autoroutes, so autorouted copper is copper that will be re-laid
    around a new hand route rather than an obstacle to it.
    That reasoning died when Task 10 froze the router's output into
    scripts/routes_signal.json. Frozen copper is data: frozen_routes() emits all
    4692 segments and 857 vias verbatim and re-routes for nothing, so every one of
    them is an obstacle a new ROUTES entry genuinely has to miss. Sweeping the
    unrouted board under a freeze hands back lanes that are already full, and
    ge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
2026-09-25 hw(pcb): close five of the seventeen open nets by hand
    Net-(U3-MODE), Net-(U3-VCC), Net-(U4-SR), /EN_BOOST and the ground at U4
    pin 6. Four of the five were sealed into pockets by copper that is ours
    to move, so three pieces move:
    - Net-(U3-SS)'s duck-under via goes 0.100 mm east. The gate between
    U3 pin 12's pad corner and that via measured 0.884 mm where a 0.20 mm
    centreline needs 0.900; east makes it 0.957 and pin 11 (MODE) can
    leave its pad.
    - Net-(U3-VCC) claims U3 pin 1's ground drop site. gnd_drops runs
    after ROUTES and re-places it, which the run confirms.
    - U4 pin 6's ground becomes a hand dogleg out of the pocket entirely.
    All 67 of its legal straight-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
2026-09-26 hw(pcb): close U10_GATE and PWM_FL_R by hand
    Two more of the thirteen open nets, unconnected pads 15 -> 13.
    /power_input/U10_GATE, U10 pin 3 to R103 pad 1: F.Cu -> In5.Cu -> F.Cu,
    14.5 mm, two 0.6/0.3 vias, worst slack +0.041 mm on the 0.200 mm Default
    clearance. The polyline starts 0.300 mm east of pin 3's pad centre -- still
    inside the pad, which spans x 36.15..37.65 -- because a leg from the centre
    itself meets the end cap of the /power_input/SNS run at (36.900, 96.500) at
    exactly 0.200 mm. Zero slack, measured.
    /outputs/PWM_FL_R, U7 pin 6 to Q4 pad 2: F.Cu -> B.Cu -> F.Cu -> B.Cu ->
    F.Cu, 53.8 mm and four vias for a 23 mm gap, worst slack +0.021 mm. The
    detour is not a preference.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
2026-09-26 hw(gen): close the ground-drop-via-vs-router-copper hole
    check_track_crossings is segment-subject: a via is only ever compared
    against, never the thing walked. gnd_drops() places its vias checked
    only against hand routes, because the router has not run yet -- a drop
    via landing on router copper was invisible to every gate that existed.
    Add check_drop_via_crossings, same primitive (_seg_disc_gap) with the
    loop reversed: for each via gnd_drops() actually placed (VIA_LOG[glo:ghi]),
    against every track on another net. Called after the frozen/autoroute
    branch, same as check_track_crossings, for the same reason.
    The comparison is `gap < need - 1e-6`, not `gap < need`: the five
    tightest drop-via-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
2026-09-26 hw(tools): show_inner's via-box comment describes a model gen_pcb dropped
    330b8f3 ("a via is a disc, not its bounding square") moved gen_pcb.routes()
    off bounding-square vias onto _seg_disc_gap. This tool's docstring still
    told the reader the square was what routes() measured against and spent
    three sentences on why the square mattered -- both false since that
    commit. Rewrite the block to say what routes() actually does now, and
    note that the box this tool still prints for a via (unchanged, still a
    cheap visual) is a looser shape than the disc check that decides.
2026-09-26 hw(tools): tally via-in-pad in check_vias.py so it cannot go stale
    fabrication.md #14 item 1 hand-counted 65 vias on five named thermal
    paddles with no way to notice the other population -- vias this repo
    places deliberately at a pad centre on the feed chain, and vias the
    router drops off-centre wherever it changes layer inside a pad. Add an
    independently-computed via-in-pad tally (exact roundrect/circle pad
    geometry, gen_pcb's balanced-paren parser, Y-down transform) so the
    number is recomputed from the board on every run. Reports the count;
    fails only if it cannot be computed, not on a fixed magic number.
2026-09-26 hw(docs): fabrication.md tells the fab about all the via-in-pad, not a third of it
    Section 14 item 1, the text pasted verbatim into a vendor order, named
    five thermal paddles and 65 vias -- correct as far as it went, but the
    board has 194 vias over 132 pads whose centre lands inside a copper pad
    (scripts/check_vias.py, added this session, recomputes it). Left as
    written, a fabricator plugs and caps five paddles and leaves the other
    127 pads tented, where solder wicks down the barrel during reflow.
    Rewrite the instruction by rule -- every via inside a pad gets plugged
    and capped -- with the five paddles still called out as the largest
    concentration, and the count named as a cross-check agains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
2026-09-26 hw(tools): check_vias graded 0.50 mm route vias by the thermal-via rule
    A via under 0.6 mm was read as thermal, and a thermal via is a fault unless
    it sits inside its own paddle. Step 6.3's signal vias are 0.50 mm -- the
    board's minimum diameter, forced on them by clearance, not chosen -- so the
    checker reported every one of them as a missing paddle.
    ROUTE_VIAS says which vias are hand routes, so the classifier reads it
    instead of guessing from diameter, and only for the sub-0.6 ones: at 0.6 and
    above the GND/non-GND split already grades a hand via correctly and is left
    alone. The rescued vias join the power/route population, where the rule that
    applies is "a landing in another net's pad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
2026-09-26 hw(pcb): close PWM_FL_G, PWM_FL_R and PWM_FR_R, and stop hand vias landing on router drills
    Three more of U7's PCA9685 outputs routed by hand against the frozen router
    copper. Unconnected pads 13 -> 11; 0 DRC violations, 0 footprint errors.
    /outputs/PWM_FL_G U7.7 -> R41.1, 9 runs on F.Cu/B.Cu/In2.Cu, 7 vias 0.50/0.20
    /outputs/PWM_FL_R U7.6 -> R40.1, 6 runs on F.Cu/B.Cu/In2.Cu, 4 vias 0.50/0.20
    /outputs/PWM_FR_R U7.9 -> R43.1, 8 runs on F.Cu/B.Cu/In5.Cu, 7 vias 0.60/0.30
    The committed PWM_FL_R is replaced rather than kept. U7 pins 6 and 7 are
    0.650 mm apart and escape through the same pocket; with the old route in place
    pin 7's pocket had 221 reachable cells and no legal via site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
2026-09-26 hw(docs): fabrication.md's drill and via-in-pad tallies were all three stale
    Measured on the board as generated:
    via-in-pad 194 -> 192 (scripts/check_vias.py prints it)
    0.20 mm drills 47 -> 78 (66 vias plus 12 thermal through-pads)
    0.15 mm ring vias 35 -> 66 (scripts/check_geometry.py prints it)
    The 0.20 mm line said 47 holes where the board has 78, and it counted only
    vias -- twelve of the holes are 0.60/0.20 thermal through-pads inside
    footprints, which the fab drills to the same 0.20 mm and the same 8:1 aspect
    ratio. Both replacements name the script that recomputes them, so the next
    change to the copper shows up here as a diff rather than as a stale number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
2026-09-26 docs(plan): fold Task 10's rulings into Tasks 11 and 12
    Task 10 reversed or superseded several things this plan asserted, and the
    corrections were living in the ledger where Tasks 11 and 12's implementers
    would never see them. Written into the plan text instead:
    - In4.Cu is a solid /VBAT plane. Step 1's clause "In4.Cu is split with
    check_plane_width.py as the gate" was false in both halves: the split was
    implemented and reversed (a per-net bounding box is not an island once that
    net's pads span the board), and the checker now refuses to measure a layer
    the plane shares rather than print a number it cannot stand behind.
    - The spec needs the same correction in three plac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
2026-09-26 hw(tools): the clearance float-tie allowance was on one of six comparisons
    check_drop_via_crossings compares `gap < need - 1e-6` and explains why: the
    router targets the 0.200 mm clearance floor exactly rather than a margin over
    it, so the tightest gaps on this board are arithmetic ties, and a strict `<`
    decides them on the last bit of a double. check_via_holes had the same
    allowance. The other five comparisons did not -- both in
    check_track_crossings (track vs track, track vs via) and all three in
    routes() (segment vs pad, segment vs via, ROUTE_VIAS vs placed via) -- and
    those are precisely the paths the hand routes are graded on.
    The board has an exact tie on that path: /power_input/SNS a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
2026-09-26 hw(pcb): FROZEN_DROP stays empty, and Step 6.4 records what it would have cost
    Step 6 argued the nine remaining open signal nets are unclosable but its
    instrument is gone, so the two widest pockets were re-measured with
    show_room.py's obstacle model. The finding is not the one Step 6 recorded:
    each pocket IS sealed by one identifiable net's frozen router copper rather
    than by geometry, so FROZEN_DROP is the right lever -- but every sealing net
    is one the board currently has closed, and re-authoring it by hand costs more
    copper than the closure gains. No net is dropped and no copper changes.
    /outputs/PWM_RL_G at Q7.5: pocket 2762 cells (6.91 mm2), no legal 0.50/0.20
    via site anywhere in it,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
2026-09-26 docs(plan): the Global Constraints still described the board Task 5 reversed
    Every task implicitly inherits this section, and Tasks 11 and 12 read it as
    authority -- Task 11 writes fabrication.md from it and Task 12 turns it into a
    reusable skill. Four things in it were wrong or unmeasurable:
    - "In4.Cu POWER split" was reversed in Task 5 and the reversal never reached
    the constraints. In4.Cu is a solid /VBAT plane. A per-net bounding box is
    not an island once that net's pads span the board, so the box encloses
    foreign pads and the split shorts what it was meant to separate. Recorded
    with the check_plane_width.py consequence: it now refuses to measure a
    layer the plane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
2026-09-26 hw(gen): routes() printed ERROR and wrote the board anyway
    `grep -c "sys.exit" scripts/gen_pcb.py` returned 0: there was no exit path in
    the file. routes() ended with
    print(" ERROR: %d route end(s) land on no copper of their own net:")
    print(" ERROR: %d route clearance(s) short:")
    and then built the copper, returned it, and let main() write the board and the
    process exit 0. So every "gen_pcb rc=0" recorded on this branch -- including in
    three task reports -- verified nothing about route anchorage or route clearance.
    A reviewer demonstrated a ROUTE_VIAS entry overlapping pad R88.2 at
    `0.000 < 0.200` that still wrote a board and returned 0. Reproduced, and it now
    refuses:
    P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
2026-09-26 hw(tools): the DRC gate ran --severity-error over 29 rules set to warning
    `--severity-error` discards every finding whose rule is `warning`, and KiCad's
    stock project file leaves 29 of its 62 rules at warning or ignore. Nothing in
    this repo had ever set them. So on the committed board the gate reported
    `Found 0 violations` while `--severity-all` reported 28: 15 connection_width and
    13 via_dangling. Every "DRC: 0 errors" recorded on this branch was measured
    through that filter.
    gen_netclasses.py already writes mccan.kicad_pro, so rule_severities is written
    there rather than hand-edited, and seven rules go to error:
    connection_width 15 hidden findings, against the board's own 0.2000 mm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
2026-09-26 hw(pcb): three router-to-pad junctions etch as hairlines, not connections
    With connection_width promoted out of `warning`, KiCad reports three necks on
    F.Cu against the board's own 0.2000 mm min_connection:
    0.0589 mm R101.2 /power_input/U10_DRN (56.8425, 78.2300)
    0.0790 mm Q10.1 /power_input/Q10_G (26.2000, 104.1000)
    0.1346 mm Q12.1 Net-(Q12-B) (42.6000, 77.8000)
    Same geometry in all three: the router leaves the pad on a 45 degree diagonal at
    0.25 mm and crosses the pad outline near its ROUNDED CORNER, so the copper the
    track and the pad have in common tapers to a sliver instead of meeting across a
    full 0.25 mm. This is the defect class gen_netclasses.py:88-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
2026-09-26 hw(tools): the ground-plane pour necks get the scoped exception the repo prescribed
    gen_netclasses.py:88-107 analysed this defect class on the retired six-layer
    board and prescribed the resolution: "a scoped exception in mccan.kicad_dru for
    those two pours only, written once the routing is final -- not a global
    relaxation, which would also stop this rule catching the Q10/Q11 kind." The
    routing is final and the exception was never written. Written here.
    The comment it comes from was stale in every particular, so it is re-measured on
    the eight-layer board rather than inherited. It named GND_BOT and VBAT_IN3;
    neither carries a neck now. It cited check_plane_width.py "at 71 mm"; the figure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
2026-09-26 hw(pcb): four dangling vias were copper nothing could ever connect to
    Group C of Task 10 fix round 1: what the thirteen [via_dangling] items are, and
    which of them are copper rather than a routing gap. Four were removable; nine
    are not, and this says why for each.
    Removed, as hand copper (layout_pcb.ROUTE_VIAS):
    ("+24V", 91.825, 32.200) at R12.1 and ("+24V", 91.775, 34.000) at C61.1.
    Their comment said they "drop straight to the +24V pour" so FB_24V's divider
    could read the pour instead of being hauled round on F.Cu. There is no such
    pour on this board. /+24V owns one zone -- 24V_D4 on B.Cu, x 84.400..90.200,
    y 21.700..27.400 -- and In4.Cu, which the six-layer stackup would ha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
2026-09-26 hw(tools): four comments described copper the board does not have
    Step 4 of Task 10 fix round 1, plus two more of the same defect found while
    measuring it. No copper changes: mccan.kicad_pcb's md5 is identical before and
    after (6c4f884ff624c5b9d3bc484f7bb2613e), so there is no clearance to report
    beyond the figures the comments now carry.
    1. layout_pcb.py, Step 6.4's PWM_RR_B paragraph: "all 7 fail the 0.30 mm
    hole-to-hole floor against that same frozen drill (best -0.100 mm)". The
    authority named is show_pocket.py, and show_pocket.py prints -0.200 mm, at
    (158.800, 51.700) against the 0.20 mm drill at (158.500, 51.700). Corrected
    to the number the tool prints, with the site a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
2026-09-26 hw(gen): the float-tie epsilon was a thousand KiCad grid units, not one
    Step 5 of Task 10 fix round 1. `gap < need - 1e-6` at thirteen comparisons in
    gen_pcb.py becomes `gap < need - TIE` with TIE = 1e-9, and the comment that
    justified the old value is corrected.
    That comment said one nanometre is "three orders below anything a fab can hold
    and below the grid KiCad itself writes". Both halves were confused. 1e-6 mm is
    one MICROmetre, and KiCad stores board geometry in integer nanometres, so the
    old epsilon was 1000 of the smallest distance KiCad can represent -- a blind
    spot exactly 1000 representable violation steps wide, in which a gap genuinely
    1 nm short passes gen_pcb and is an erro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
2026-09-26 hw(tools): the plane-neck waiver was argued from a premise this board refutes
    fe984b9 gave GND_IN1/GND_IN3/GND_IN6 a scoped connection_width exception and
    justified it with "a neck between two antipads is not a series path: the plane
    is a sheet and current spreads around the constriction". That premise needs
    the check to report pinches, and on this board it does not. Scanning In1.Cu's
    antipad field directly -- every foreign full-barrel via, reach = radius +
    max(zone 0.3, netclass clearance), different-net pairs whose antipads do not
    already overlap -- finds 74 gaps narrower than the 0.1558 mm narrowest neck
    KiCad reports, seven of them at exactly 0.0000 mm. KiCad reports none of the
    74; i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
2026-09-26 hw(tools): the documented DRC gate ran one severity, and five figures were wrong
    Fix round 2's small items, all documentation and one hoist. No copper changes:
    mccan.kicad_pcb md5 6c4f884ff624c5b9d3bc484f7bb2613e before and after, and DRC
    is 9 violations at --severity-error and 9 at --severity-all both before and
    after -- all via_dangling, 11 unconnected pads, 0 footprint errors.
    README.md's documented gate (N7). It ran `--severity-error` only, while
    gen_netclasses.py's new comment says to run both. They agree today only because
    the generated .kicad_pro promotes the seven rules that can fail this board; a
    KiCad upgrade adding a rule that defaults to `warning` would make the documented
    ga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
2026-09-26 hw(docs): fabrication.md catches up on layer count and the feed plane
    Header status, the one-screen summary and the stackup section now describe the
    board that exists: 8 layers, In4.Cu the solid /VBAT plane (In3.Cu is GND),
    CAN's In2.Cu stripline referenced by two grounds. Verified this session:
    - DRC re-run (kicad-cli pcb drc --severity-error --schematic-parity
    --refill-zones): 9 violations (all via_dangling), 11 unconnected items,
    board md5 unchanged. 11 = 9 signal nets (two of them U9's own pins) + 1 GND
    pad, per output/drc.rpt and hardware/README.md.
    - Stackup dielectrics read verbatim from mccan.kicad_pcb's (stackup ...) block.
    - python scripts/check_plane_width.py: /VBAT on In4.C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
2026-09-26 hw(docs): fabrication.md's board outline and antenna keep-out match the board
    Section 3 was still the 140x100mm board's numbers. Re-measured this session
    directly against mccan.kicad_pcb: outline x 20-220, y 20-160 (200x140mm, 3mm
    corner arcs); mounting holes H1-H4 at (25,25),(215,25),(25,155),(215,155) read
    off the footprints, not derived from MOUNT_INSET; U5's antenna keep-out zone
    polygon at x 213.56-234.75, y 48-96 (60mm right of where it used to be).
    Also recorded honestly: no rectangle marks this keep-out on Cmts.User today --
    only a stray text note near the top edge with the wrong (datasheet-element,
    not keep-out) dimensions. Drawing that region touches layout_pcb.py, which is
    copper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
2026-09-26 hw(docs): fabrication.md's netclass table and land-pattern gaps get honest
    Section 4: removed the "Default" netclass row (0.25mm track was simply wrong
    -- mccan.kicad_pro's built-in Default class is 0.20mm, matching this board's
    own min_track_width/min_clearance floor; there is no separately-authored
    Default class). Verified FEED/POWER/CAN track/clearance/via/drill against
    net_settings.classes in mccan.kicad_pro this session. Fixed the "through-path
    belongs on In3.Cu" sentence -- the feed plane is In4.Cu; In3.Cu is GND.
    Section 6: the three pad-to-pad gaps (U1/U2 0.200mm, U10 0.150mm) are
    confirmed against mccan.kicad_dru, which is footprint-derived and unaffected
    by routing. The three trac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
2026-09-26 hw(docs): fabrication.md's drill schedule and via-in-pad arithmetic re-derived
    Section 5 was the six-layer board's router run (968 vias/614 router, 47 holes
    at 0.20mm). Re-derived this session directly from mccan.kicad_pcb (every via
    and thru_hole/np_thru_hole pad, tallied by size, since this task did not
    generate a fabrication package -- no Excellon file was available as input):
    1401 vias total (65 @0.50/0.20, 65 @0.55/0.25, 968 @0.60/0.30, 303 @0.80/0.40),
    855 frozen from the router + 546 hand-authored per check_vias.py's own count.
    Binding 0.20mm-drill hole count is 77 (65 vias + 12 of U5's footprint pads),
    not 47/66/78. Relief-hole count for the J-connectors is 18, not 20 -- measured
    dir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
2026-09-26 hw(docs): fabrication.md's impedance reasoning and copper-pour table for 8 layers
    Section 11: CAN is now a stripline on In2.Cu between two GND planes (In1.Cu
    above at 0.2mm, In3.Cu below at 0.2454mm -- read from mccan.kicad_pcb's
    stackup and confirmed CAN's own segments sit on In2.Cu this session), not the
    six-layer board's single-sided reference. Conclusion (no controlled impedance)
    is unchanged; dropped the specific "70 ohm not 120 ohm" figure, which was
    computed for the old geometry and was not re-derived for a true stripline --
    the timing argument doesn't depend on the exact number either way.
    Section 12: seven zones, not five -- In1/In3/In6/B.Cu GND, In4.Cu /VBAT,
    B.Cu /+24V, F.Cu GND_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
2026-09-26 hw(docs): fabrication.md package status, open items and via-treatment row
    Section 15: honestly states the fabrication package was not generated by this
    documentation-only pass (generating gerbers/drill/CPL/BOM is not a doc change)
    and that it wouldn't be orderable yet regardless, given the 11 open pads.
    Section 16: reordered with the two blocking items first (11 unconnected pads;
    no package yet), updated the 47/35-hole figures to the re-derived 77/65, added
    open items for the missing Cmts.User antenna-keepout marking and the
    unverified §6 track-to-pad gaps.
    Section 1: the via-treatment row said only the five thermal paddles get
    plugged and capped, which stopped matching the board once Tas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
2026-09-26 hw(docs): enclosure.md's layer-count row catches up to 8 layers
    Its open-items table still said "6 layers, 1 oz on all six" and named In3.Cu
    as the feed plane, both stale after the 200x140mm re-layout (now 8 layers,
    1 oz on all eight, feed on In4.Cu -- see fabrication.md Sec 2, re-measured
    this session: check_plane_width.py's worst cut is 104.90mm/9.2x, not the old
    71mm/6.1x). Kept the resolved-item's reasoning about even layer counts and 2oz
    inner etch, which still holds; only the count, layer name and figure changed.
    This is the one line of enclosure.md in this task's scope; the rest of that
    document's 140x100mm re-layout is a separate task.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
2026-09-27 docs(spec): reconcile electrical + re-layout specs with the frozen 8-layer board
    Task 11 Step 1/2. Both spec docs still described the 6-layer, 140x100mm
    board and the /VBAT split that was tried and reversed on In4.Cu. Every
    figure below was re-verified this session against mccan.kicad_pcb or its
    companion scripts, not copied from another document:
    - 2026-09-11 design spec S9.1: gland row re-derived as a single 200mm-wall
    row (158mm used of 200mm available, computed from typical M12/M16 gland
    hex-across-flats + spanner clearance, not asserted); S9.3 box-family
    check against the grown 200x140mm footprint (Hammond/Fibox still reach
    it, Bopla's commonly-catalogued Euromas family does no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
2026-09-27 hw(docs): enclosure.md catches up to the 200x140mm board (notch, areas, box family)
    Task 11 Step 3. enclosure.md still described the 140x100mm board's notch
    coordinates and areas. Re-derived this session directly from
    mccan.kicad_pcb and re-verified independently of any other document:
    - Board outline is no longer notched (only the heat-spreader plate is);
    board area 279.92cm2 from Edge.Cuts (200x140mm plus four 3mm corner
    arcs), notch removes 3.09cm2 (U5 keepout x213.56-234.75 overlapping the
    board over y48-96, i.e. 6.44 x 48mm), plate area 276.8cm2.
    - Notch coordinates shifted +60mm in x with the re-layout (x153.56-160.00
    -> x213.56-220.00); antenna clearances (21.2mm, 17.3mm) con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
2026-09-27 hw(docs): routing-tool.md catches up to the eight-layer router run
    Task 11 Step 4. This doc still cited the six-layer SIGNAL_LAYERS list and
    the retired In3.Cu VBAT-plane figures, and undercounted the zones
    gen_pcb.py emits. Verified this session:
    - SIGNAL_LAYERS corrected from the six-layer F.Cu/In2.Cu/In4.Cu/B.Cu to
    the current F.Cu/In2.Cu/In5.Cu/B.Cu; plane-layer list corrected to
    In1.Cu/In3.Cu/In4.Cu/In6.Cu (three GND + the /VBAT feed on In4.Cu),
    cross-checked against check_geometry.py's own layer report which shows
    routing only on the four signal layers.
    - check_plane_width.py mention updated to In4.Cu's measured 104.90mm/9.2x
    (python scripts/check_plane_width.py, this sessio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
2026-09-27 docs(plan): mark old plan's Tasks 8-9 superseded by the 8-layer re-layout
    Task 11 Step 6. Tasks 8 and 9 of the 2026-09-11 plan describe laying out
    and routing the 6-layer, 140x100mm board -- a real, working intermediate
    stage, but not what plan3-pcb-hardware carries today. Added a "SUPERSEDED
    2026-09-27" note at the head of each task pointing to the 2026-09-23
    re-layout spec and its own plan (Tasks 1-9 there, with this branch's
    Task 11 generating the fabrication package), without altering or deleting
    either task's original body -- they remain a record of how the 6-layer
    board was built.
2026-09-27 hw: generate fabrication package (not for fab), fabrication.md catches up
    Task 11 Step 7 + the remaining part of Step 5. Generated gerbers, drill
    files, BOM, CPL and PDFs from mccan.kicad_pcb (md5
    6c4f884ff624c5b9d3bc484f7bb2613e, confirmed unchanged before and after
    every export command in this commit, and by empty
    `git diff --stat mccan.kicad_pcb`) via kicad-cli 10.0.2:
    kicad-cli pcb export gerbers --check-zones \
    -l F.Cu,In1.Cu,In2.Cu,In3.Cu,In4.Cu,In5.Cu,In6.Cu,B.Cu,F.Paste,B.Paste,\
    F.Silkscreen,B.Silkscreen,F.Mask,B.Mask,Edge.Cuts -o output/gerbers/ mccan.kicad_pcb
    kicad-cli pcb export drill --format excellon --excellon-separate-th \
    --generate-map --generate-report --repo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
2026-09-27 hw(skill): extract the pcb-layout-routing skill from the 8-layer re-layout
    Task 12 of the 8-layer re-layout plan: pull the reusable, tool- and method-level
    lessons out of Tasks 1-11 into a repo-tracked Claude Code skill at
    .claude/skills/pcb-layout-routing/, so the next board (or the next person's clone
    of this repo) does not relearn them from scratch. Covers placement density and
    silk as a hard gate, stackup symmetry and the rejected per-net-bounding-box plane
    split, what to hand-route vs. route, KiCadRoutingTools' specific traps, and what
    DRC does not catch (ground-split counting, sub-floor copper, split zone fills,
    the exit-code-vs-report-body trap) plus the stale-fact sweep discipline.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
2026-09-27 hw(gates): arm the two checks that printed ERROR and gated nothing
    Both were demonstrated by the final reviewer and re-demonstrated here.
    gen_pcb.place(): the three placement ERRORs (hand-placement overlap,
    courtyard off the board, hand placement in a channel) printed and
    continued; main() raised only on `unplaced`, so the board was written
    and the process exited 0. They now accumulate and raise SystemExit
    before the auto-flow runs, matching the pattern routes() established at
    50ad766 -- counts named, "<board> not written" stated, and the raise
    placed where main() has not yet opened BOARD, so the previous board
    survives. No opt-out list: the current board triggers none of the three.
    Veri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
2026-09-27 hw(gates): check_plane_width can now see footprint-nested keep-outs
    G.find_all is one level deep by design (gen_pcb.py:123), so
    find_all(doc, "zone") returned the seven top-level pours and missed the
    eighth: the stock ESP32-WROOM-32E footprint's antenna keep-out, nested
    inside the U5 footprint block, copperpour not_allowed, layer list
    covering all 32 copper layers including In4.Cu. The check therefore
    rastered the /VBAT plane as though that rectangle were solid copper and
    printed a number 44 % high -- the exact failure mode its own rivals()
    docstring says it should refuse rather than fake.
    Three defects, all fixed:
    1. zone_layers() reads the WHOLE layer list. The old code compared only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
2026-09-27 hw(board): four fab-facing defects, in one regeneration
    Board md5 6c4f884ff624c5b9d3bc484f7bb2613e -> dac4c6343ed72c8398c3aa681aa0009b.
    mccan.kicad_pcb was regenerated by scripts/gen_pcb.py, not edited.
    1. The gap-pad total on Cmts.User said "~1360 mm2". TIM_PADS gives
    TIM-A 76..110 x 23..82 = 34 x 59 = 2006 mm2 and TIM-B 81..95 x
    104..116 = 14 x 12 = 168 mm2, total 2174 mm2 -- and the generator's
    own labels two millimetres away on the same layer already printed
    2006 and 168 correctly, so the board contradicted itself. 1360 is
    1190 + 168, the figure from before TIM-A's bottom edge was re-derived
    from y 58 to y 82. The total is now DERIVED: layout_pcb.TIM_AREA
    sums TI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
2026-10-17 docs(spec): redesign for bought E-marked lighting modules
    Indicators must be E-marked to be road-legal in Europe, which rules out the
    self-built RGB COB assemblies the previous design drove. Bought modules take a
    steady switched 12V per function, so the controller becomes a 12V load switch
    rather than an LED driver.
    Deletes the 24V boost domain, 12 discrete FETs, 12 sense shunts, the 16:1 mux,
    the PCA9685, the +3V3_SW domain, all colour handling, and the machined thermal
    base plate. Adds 12 on/off high-side outputs: 10 signal (125 mA) plus 2 Oxford
    4K aux pods (2.17 A). No PWM remains anywhere in the design.
    Keeps hardware/scripts/, the six gates and the routing pipeline, plus the CAN
    inpu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
2026-10-17 docs(plan): firmware output model plan, and correct the spec's branch bases
    The spec claimed main was an ancestor of plan3-pcb-hardware. Measured: they
    diverged at 730beb8, and main is ~1140 lines ahead on the firmware because the
    test-mode-and-brightness work was cherry-picked there and never reached the PCB
    branch. So the firmware half branches off main and the board half off
    plan3-pcb-hardware; both still land on main by cherry-pick.
    The plan covers the firmware only, in 8 tasks. The board needs the Oxford kit in
    hand (spec 9.1) before its part selection can be written.
    Writing it surfaced one spec requirement with no implementation anywhere:
    CanState carries no timestamp, so a quiet bu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
2026-10-17 docs(spec): signal modules are 2835 SMD, which splits the inrush criterion
    2835 means discrete mid-power emitters, so a 12V module is normally
    resistor-ballasted rather than converter-fed. Inrush capability is therefore
    only a requirement for the dual-channel part driving the Oxford pods; the quad
    parts carrying the ten signal outputs can be selected on steady-state 125 mA
    and protection alone. Recorded as an expectation to confirm, not a measurement.
2026-10-18 chore(gen_pcb): fail generation when two layers plot to one gerber name
    1f1ff87 fixed the three GND planes collapsing into one mccan-GND.gbr, but
    nothing stopped the next hand-written LAYERS table repeating a name. The
    check runs at import, compares each layer's effective plot name (user name,
    else canonical) case-insensitively, and names both layers on a clash.
2026-10-18 docs: bring the current redesign spec and the phase-A board plan onto the PCB branch
2026-10-18 fix(scripts): symlib and gen_rails resolve paths from their own file
    Both hard-coded D:\Projects\ESP32MCCAN\hardware, so run from a worktree
    they read and wrote the main checkout instead of their own tree. Every other
    generator already derives HW from __file__.
2026-10-18 hw(parts): select TPS4H160-Q1 (version B) for the signal outputs; quadpins.py holds its pin table
    Graded against SLVSCV8E: all ten criteria pass. The plan's 50.6 V feed criterion
    was corrected first -- VBAT sits behind the LTC4380-2's 31.5 V gate clamp. Application
    values (4.7k/47k inputs, 4.02k current limit at 0.5 A, 1.8k sense for 3.0 V full scale,
    THER latch via gated +5V) are derived in quadpins.py with page references. The plan
    gains a 4.7k series resistor on each shared diagnostic line, per TI 7.3.7.5.
2026-10-18 hw(gates): check_netlist.py encodes the phase-A board's electrical intent
2026-10-18 hw(gates): check_netlist fix round 1 (clamp on SNS_x, always-on collision check, AUX single resistor, exact values)
2026-10-18 hw(lib): quad high-side switch symbol and phase-A footprint assignments
2026-10-18 hw(power): feed B for AUX_R, and delete the ignition sense
2026-10-18 hw(rails): delete the 24 V boost and the switched 3V3 domain
2026-10-18 hw(outputs): ten signal channels on three quad smart high-side switches
    Replace the plan3 RGB/PWM stage (PCA9685, ADG706, NX5020 channels and
    shunts, DNP snubbers, BTS7008, PTCs, J6, J7) with U11-U13 TPS4H160B-Q1
    per D1: 4.7k series + 47k pull-down on every IN, CS -> 1.8k + 4.7k ->
    SNS_x with the BAT54 clamp on the ADC side only, R_CL, R_THER to +5V,
    C_VS 100nF 100V 0805, FAULT/NC no-connect. Harness tails J3/J4/J5 per
    D5; J8 (CAN) unchanged. OUT_AUX_L/R end in one 47k pull-down each.
2026-10-18 hw(root): phase-A hierarchy; ERC clean, every net read
    Root sheet pins now match every child hierarchical label (stale plan3 pins
    removed; VBAT_B added with a root label and PWR_FLAG; OUT_* x12, DIAG_*_Q,
    SNS_A-C, EN_5V, +5V, +3V3_ALW, VBAT, CANH/CANL wired by name).
    Also fixed in symlib.py: TPS4H160B_Q1 OUTn pads retyped output -> passive.
    Each channel's two pads are one output tied together; two Output pins on a
    net raised 10 pin_to_pin errors that are not in the circuit (same treatment
    as BTS7008 OUTn). Regenerated outputs sheet and mccan_parts.kicad_sym.
    ERC: 0 errors, 0 warnings. check_netlist: all groups PASS. verify_fpmap: 144 ok.
    DNP set: R2, R3 (0R links across the choke), R26 (12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
2026-10-18 docs: phase-A board decisions reach the spec and the hardware docs
2026-10-18 docs: fix-up from Task 9 review: three quads throughout, true fuse margins
2026-11-07 docs(harness): EL360 rear module wire colours
2026-11-13 hw(outputs): aux stage - BTS7008-2EPA pod switch, yellow PWM buffer, pod tails
    - U14 BTS7008-2EPA switches both pods from VBAT_B (feed B); 77-99 A
    overload trip, so pod inrush cannot trip it. DEN/DSEL pulled down,
    RSENSE on IS. C67/C68 on VBAT_B, C69/C70 at the outputs, all to GND_B.
    - U15 SN74AHCT2G126 buffers AUX_PWM (GPIO 13) to each yellow; each
    enable is that pod's OUT_AUX_x, so yellow never drives an unpowered pod.
    Series R + 5.6 V Zener clamp + pull-down on each yellow line.
    - Pod tails J10/J11 (1 mm2 4-core); blue unconnected until measured.
    - GPIO 13 becomes AUX_PWM; status LED D5/R27 removed.
    - GND_B exported as the pods' return; R100 re-sized 5.6 -> 33 mOhm.
    - check_netlis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
2026-11-13 hw(outputs): U15 is Nexperia 74AHCT2G126DC (VSSOP-8); R82/R83 330R
    Datasheets supplied: 74AHC_AHCT2G126 (Nexperia Rev. 9) and MMBT3904
    (Diotec). The 2G126 pinout is verified. The AHCT part exists only in
    VSSOP-8 (SOT765-1), so the footprint moves from SSOP-8 to
    VSSOP-8_2.3x2mm_P0.5mm; the TSSOP "DP" is AHC with CMOS inputs and must
    not be substituted. R82/R83 go 100 -> 330 R so a yellow shorted to 12 V
    keeps the buffer's output clamp inside IOK 20 mA even with +5V off.
    The stale SN74AHCT2G126 symbol is dropped from the library. MMBT3904
    B1/E2/C3 matches Q_NPN_BEC on Q2, Q3, Q12.
    ERC 0, all check_netlist groups pass, generators idempotent.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
